oceanye/ESP32_C73-MF1750/8寸艾利尔042.jpg

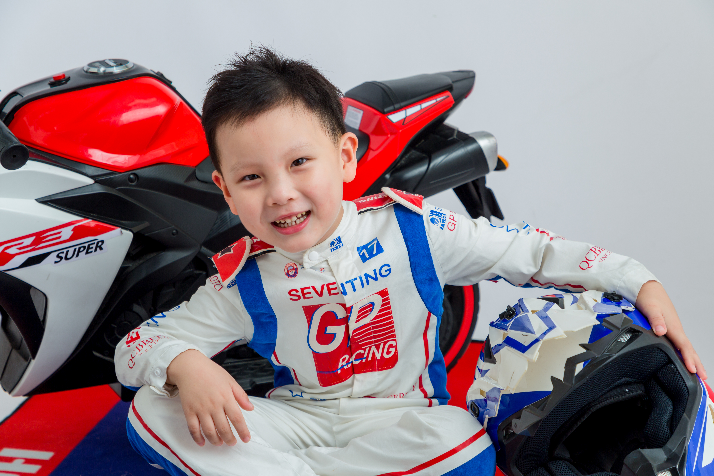
8寸艾利尔042.jpg
