oceanye/ESP32_C73-MF1750/参考资料/2路控制继电器Type-c/继电器引脚说明.jpg

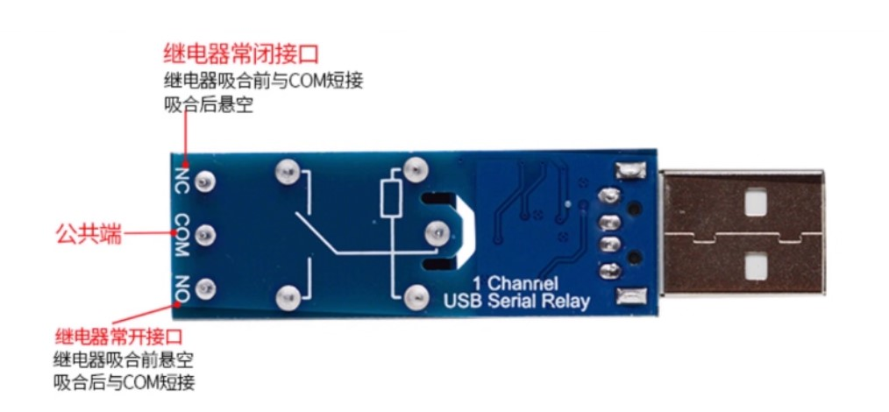
参考资料/2路控制继电器Type-c/继电器引脚说明.jpg
