oceanye/ESP32_C73-MF1750/hardware/mf1750_devkitc_b1_jlcpcb/support/PRE_EXPORT_SOURCE_AUDIT_NOTE.md

# Pre-export source audit

`PRE_EXPORT_SOURCE_VERIFICATION.json` is the exact historical B1 source verification record created before this Gerber/drill package existed.  Its legacy `No Gerber/drill manufacturing package is released` limit is superseded only by this export package's `MANIFEST.json`, `SHA256SUMS.txt`, and `README_ORDER.md`; all remaining source limits still apply.
