oceanye/ESP32_C73-MF1750/hardware/mf1750_devkitc_b2_jlcpcb/support/PRE_EXPORT_SOURCE_AUDIT_NOTE.md

# Pre-export source audit

`PRE_EXPORT_SOURCE_VERIFICATION.json` binds the exact verified B2 canonical source used by this export.  Its local evidence gate is PASS, while live portal/CAM/stock/placement review remains PENDING.  The functional-edge shortfall is removed; the listed J1/J3/J2/antenna/enclosure physical holds remain first-article checks.
