oceanye/ESP32_C73-MF1750/hardware/mf1750_production_v1/production/PCB下单与首板检查.md

# 嘉立创首板下单参数（MF-1750 Rev A1 / Q1 FIX）

- PCB：2 层，80 x 75 mm，FR-4，1.6 mm，1 oz，绿色阻焊，白色丝印。
- 最小线宽/间距：0.20/0.20 mm；常规过孔：0.60/0.30 mm。
- PCB 文件：只上传 `Gerber_mf1750_revA1_Q1FIX.zip`。
- SMT BOM：只上传 `BOM_mf1750_revA1_Q1FIX.csv`。
- SMT 坐标：只上传 `CPL_mf1750_revA1_Q1FIX.csv`。
- 不要复用嘉立创订单中修正前已经解析的旧文件记录。
- SMT：单面贴装；BOM/CPL 各含 46 个相同位号。J2 排针、TP 测试点和
  安装孔需要手工处理，不进入贴片坐标。
- 默认装配：R15、R12、R13 装；R16 不装。
- 禁止同时安装 R15 与 R16。
- J1 使用 C2856838 官方焊盘并旋转 180°，电缆从板顶边伸出；本板顶视
  pin 1 位于左侧 `PIN1 >` 丝印处。插屏前仍须以屏尾实物 pin 1 复核。

嘉立创预览必须逐项复核：

1. 板尺寸为 80 x 75 mm，2 层，全部 SMT 在 Top 面。
2. J1 pin 1 在左侧且排线向板顶边伸出。
3. D1-D4 阴极方向、Q1/Q2 pin 1 和封装方向与顶面渲染图一致。
4. R16 显示为不贴，R15/R12/R13 显示为贴装。
5. Q1 必须为 SI1308EDL：顶视 pin1=G（左下）、pin2=S（右下）、pin3=D（上）。
6. 二极管阴极色带：D1、D2 朝右；D3、D4 朝左。

J2 从 1 到 10 脚依次为：3V3、GND、SI0、SCL、CSB、DC、RST_N、
BUSY_N、可选 CS2、GND。前 8 脚兼容现有 DESPI-C73 主机接线；默认
R15 已把两路片选连接，R16 不贴。

最终布局复核：Q1-S→R1 约 2.51 mm，C0→L1 为 3.20 mm，L2→R3 为
4.55 mm；CP1 两支路合计 20.46 mm，CP2 合计 26.45 mm；两层 GND
铺铜由 6 个功率区局部过孔连接。KiCad 检查结果为 ERC 0、DRC 0、
未连接 0、原理图一致性错误 0。

首板必须限流上电并测量高压轨，不应把“DRC/ERC 通过”等同于已经完成
整屏实物电气验证。本板需要外部稳定 3.3 V；Q1 SI1308EDL 是已记录的
参考族器件选择，首板仍应测温并确认各高压轨后再插屏。
