oceanye/ESP32_C73-MF1750/docs/MF1750_DRIVER_API.md

# MF-1750 基础驱动与 API 参考

本文是 Rev A1/R16 基础驱动的当前统一接口说明。历史排查过程、制造证据和完整
实测记录分别保留在原有文档中；新代码应以本文、`src/epd_driver.h` 和实际路由为准。

## 1. 发布状态与适用范围

| 项目 | 当前值 |
|---|---|
| 当前源码与最近受监督验证 build | `MF1750_DRIVER_RC2G_R16_CCSET_MAPHASH_COLORGUARD_JOBTRACE_PSRFIX_WEBPHOTO_PHYSICAL_BUSYEDGE_2026-08-07`；精确 MAP job1 与 macro4 job2 的协议、nominal timing、BUSY edge、GPIO、电气和忠实度通过；不自动继承为所有帧/算法资格 |
| D0 正式实机验收 build | `MF1750_DRIVER_RC2C_R16_CCSET_MAPHASH_COLORGUARD_JOBTRACE_PSRFIX_2026-08-04` |
| C++ Driver API | `MF1750_R16_CASCADE_V3` |
| RC2F 历史 build / `firmware.bin` | `MF1750_DRIVER_RC2F_R16_CCSET_MAPHASH_COLORGUARD_JOBTRACE_PSRFIX_WEBPHOTO_PHYSICAL_2026-08-05`；811056 字节；SHA-256 `AE5261AA2E679B4AEA11C9C4C2CE5D12BD561EC72748828ECC5BA570A03A4A20`；已刷写，固定 MAP 基准与事故后恢复均通过 |
| RC2G `firmware.bin` | 815664 字节；SHA-256 `9DF89715385F98892549D24B57A6B139FB0844E9CEA52EF4FD2C961D6B0CD772`；2026-08-07 精确复核后刷入并完成两次受监督 exact-action 验证 |
| L535 研究变体 build（独立 TU/env，未继承生产验收） | `MF1750_L535_FRAME_V1_20260926`、`MF1750_L535_FRAME_V2_20261006`、`MF1750_L535_VSH_6000_20261010`、`MF1750_L535_VSH_6600_20261010`、`MF1750_L535_VSH_7200_20261010`、`MF1750_WF_A1_PLL50_20261011`、`MF1750_WF_B1_VSHLV2_6900_20261011`、`MF1750_WF_G6_WHITE_20261017`、`MF1750_WF_COMMENTED_FULL_20261018`、`MF1750_WF_BISECT_R1_20261018`、`MF1750_WF_BISECT_R2A_20261018`、`MF1750_WF_BISECT_R2B_20261018`、`MF1750_WF_BISECT_R2C_20261018`、`MF1750_WF_BISECT_R2D_20261018`、`MF1750_WF_BISECT_R2E_20261018`、`MF1750_WF_BISECT_R2F_20261018`、`MF1750_WF_BISECT_R2G_20261018`；各自批次 manifest 自封于 `.test-output/offline/`，上机资格以批次门为准 |
| L535 WF WMASK 研究变体（records 4–7 剩余 12 种非空组合，独立 TU/env，未继承生产验收） | `MF1750_WF_WMASK_01_20261018`、`MF1750_WF_WMASK_02_20261018`、`MF1750_WF_WMASK_05_20261018`、`MF1750_WF_WMASK_06_20261018`、`MF1750_WF_WMASK_07_20261018`、`MF1750_WF_WMASK_08_20261018`、`MF1750_WF_WMASK_09_20261018`、`MF1750_WF_WMASK_0A_20261018`、`MF1750_WF_WMASK_0B_20261018`、`MF1750_WF_WMASK_0C_20261018`、`MF1750_WF_WMASK_0D_20261018`、`MF1750_WF_WMASK_0E_20261018`；mask bit0/1/2/3 分别选择 record 4/5/6/7；离线包 `WF_WMASK_BUNDLES_20261018_V1`，上机资格以批次门为准 |
| L535 WF WMASK GrayExt 研究变体（低 4-bit base 加整个 records 0–3 组，独立 TU/env，未继承生产验收） | `MF1750_WF_WMASK_1E_20261019`、`MF1750_WF_WMASK_1C_20261019`、`MF1750_WF_WMASK_1D_20261019`；`1E/1C/1D` 是 family label，分别表示 base `0E/0C/0D` + records 0–3，不是新的 8-bit bitmask；离线包 `WF_WMASK_GRAYEXT_BUNDLES_20261019_V1`，上机资格以批次门为准 |
| L535 WF WMASK 0E single-record-add 研究变体（base `0E` 分别加 records 0/1/2/3 中恰好一个，独立 TU/env，未继承生产验收） | `MF1750_WF_WMASK_0E_R0_20261019`、`MF1750_WF_WMASK_0E_R1_20261019`、`MF1750_WF_WMASK_0E_R2_20261019`、`MF1750_WF_WMASK_0E_R3_20261019`；`0E_R*` 是显式 family label，不是新的 bitmask；离线包 `WF_WMASK_0E_R0TO3_BUNDLES_20261019_V1`，上机资格以批次门为准 |
| L535 WF WMASK 0E R0-anchored pair 研究变体（base `0E` 加 R0 与 records 1/2/3 中恰好一个，独立 TU/env，未继承生产验收） | `MF1750_WF_WMASK_0E_R0R1_20261019`、`MF1750_WF_WMASK_0E_R0R2_20261019`、`MF1750_WF_WMASK_0E_R0R3_20261019`；`0E_R0R*` 是显式 family label，不是新的 bitmask；离线包 `WF_WMASK_0E_PAIRS_BUNDLES_20261019_V1`，上机资格以批次门为准 |
| L535 partial-block 首批研究变体（docs/MF1750_PARTIAL_BLOCK_WAVEFORM_HANDOFF_20261020.md，独立 TU/env，未继承生产验收） | 路线 A `MF1750_PARTIAL_BLOCK_ATLAS_1E_20261020`：固定 1E 完整帧 tuple 驱动编译内置的白底七 code 图集帧；路线 B `MF1750_PARTIAL_BLOCK_PTLW_20261020`：clean-PTLW `0x83` 局部窗口 A=1E/B=0E/C=1C（9-byte 包含式、160×120、code-7 全量 preload 后 cropped DTM、PON/DRF/POF 且 PON 后不重复 PTLW）加 factory-OTP 白场锚点/恢复；两条路线的 R20/PWR/PLL/R21 与对应 wf_wmask 完整帧 profile 逐字节一致；不接受运行时坐标、未知命令、VCOM/高压修改或任意 LUT 字节；离线包 `MF1750_PARTIAL_BLOCK_20261020_V1`，上机资格以 P0–P3 批次门为准。P0 实测（批 `MF1750_PARTIAL_BLOCK_P0_20261020_V1`）：1E 下 code0 无可见驱动（对同区白基线 ΔE 1.21，t0→t30 稳定）——1E 混合表固有语义；bg_ref 单区橄榄色块经逐像素解码对拍排除映射/生成器 bug，分析包 `PARTIAL_BLOCK_P0_ANOMALY_ANALYSIS_20261020_V1`。修订 2 判别变体：`MF1750_PARTIAL_BLOCK_ATLAS_1E_20261020_V2`（同 8 格坐标，(544,384)=code7 探针、(792,384)=code6）与 `MF1750_PARTIAL_BLOCK_PTLW_20261020_V2`（patch code 0→4，其余逐字节不变）；离线包 `MF1750_PARTIAL_BLOCK_20261020_V2`。归一化+探针会话变体 `MF1750_PARTIAL_BLOCK_ATLAS_1E_20261020_V3`（排查②协议①+②：单会话内先 NORMALIZE——2×OTP 白 + 3×(code0/code1) active 表交替复位——再 1E 均匀 code7/code1 探针与 V2 图集，最后 OTP 白恢复；逐动作端点、无自动链；逐动作/逐步 BUSY 时间线）；离线包 `MF1750_PARTIAL_BLOCK_20261020_V3`。紧凑布局变体 `MF1750_PARTIAL_BLOCK_ATLAS_1E_20261020_V4`（8 格 110×110 收进当前可见窗 x[16,520] y[170,580] 且全部在 CS1 左半；row0=[0,1,2,3]、row1=[4,5,7,6] 保持 V2 约定；取消 V3 两个探针端点省 2 刷；NORMALIZE 8 步序与 V3 逐字节一致）；离线包 `MF1750_PARTIAL_BLOCK_20261020_V4`。BTST2[3] 阶梯扫掠变体 `MF1750_BTST2_SWEEP_V1_20261021`（排查④后续：V4 帧与 1E tuple 逐字节复用，四端点 `s17/s29/s39/s49` 仅刷新段 BTST2 第 4 字节按档重写（前三字节恒 `6F,1F,17`），0x49 档与 V4 atlas 刷新逐字节一致可直接对比；白恢复同 V4；离线包 `MF1750_BTST2_SWEEP_20261021_V1`）。修复版 `MF1750_BTST2_SWEEP_V2_20261021`（V1 缺陷：CS2 流写后未重选双控，PON/BTST2/DRF 只发 CS2 致级联主控永不完成刷新、DRF 60s 超时；V2 在刷新包装器首行恢复 `setActiveControllers(true, true)`，离线包 `MF1750_BTST2_SWEEP_20261021_V2`）。波形变体图集 `MF1750_WF_ATLAS_V1_20261021`（layer-1 扩稳定色：V4 帧逐字节复用，全帧路径首测 0E/1C，1E 为批内锚点，组曲 1D（GrayExt 亮端）与 0E_R0R1（R0 锚定 pair 暗簇）；刷新沿用 V4 已修复的双控选择语义；离线包 `MF1750_WF_ATLAS_20261021_V1`） |
| 硬件 | MF-1750 Rev A1，R15 拆除、R16=0 Ω |
| 控制器 | 双 SPD1657B，revision `0x04` |
| 面板 | 1024x600，双 512x600 控制器 |
| 默认刷新 SPI | 1,000,000 Hz |
| 实机范围 | RC2C 100 kHz/1 MHz MAP_ORIENT_V1 通过；RC2F 1 MHz 固定 MAP、恢复及低空间诊断通过；RC2F job5 macro4 时序异常；RC2G MAP job1 与同帧 macro4 job2 均 nominal 且忠实度通过，macro4 主观画质差，旧异常根因仍未定位 |

基础驱动 D0 已完成：初始化、双片选级联、`CCSET(0xE0)=0x01`、六色 4bpp
整帧、控制器映射、PON/DRF/POF BUSY 门禁、失败安全断电、任务状态和不可变
诊断报告均已落地并实机验证。

以下内容不属于已验收基础 API：高于 1 MHz 的 SPI 扫频、快速/局部波形、LUT、
局刷、灰阶、未校准普通图片真屏、设备端认证和远端取消。公开的
`epdDisplayFrameAtFrequency()` 只代表驱动可接受显式频率；除 100 kHz 与 1 MHz
外，不代表该频率已经获得硬件发布资格。

## 2. 规范帧合同

| 字段 | 合同 |
|---|---|
| 尺寸 | 精确 `1024x600` |
| 字节数 | 精确 `307200` |
| 排列 | top-left、逐行、无行填充 |
| 像素 | 4bpp；偶数 x 在高 nibble，奇数 x 在低 nibble |
| CS1 | `source_half=0, flip_x=0, flip_y=0, nibble_swap=0` |
| CS2 | `source_half=1, flip_x=0, flip_y=0, nibble_swap=0` |

物理颜色码：

| 码 | 颜色 |
|---:|---|
| `0x0` | 黑 |
| `0x1` | 白 |
| `0x2` | 黄 |
| `0x3` | 红 |
| `0x5` | 蓝 |
| `0x6` | 绿 |

这里的 4bpp 是应用帧和 SPI DTM 的 packed 容器，不代表面板存在 16 个独立颜色。
MF-1750 规格标称 `3-bit E6 full display capabilities`；当前生产合同仍只接受上述
六个经过实屏验证的物理码。`0x4/0x7` 的潜在 3-bit 状态和 `0x8..0xF` 的 bit3
alias/保留行为都尚未通过受控硬件实验。

`0x4` 和 `0x7..0xF` 非法。HTTP raw handler 会在复制完整帧和排队前逐 nibble
拒绝非法码；公开 C++ 显示入口还会在初始化、DTM、PON 之前再次完整验证。

## 3. C++ 驱动 API

头文件：`src/epd_driver.h`。

### 3.1 生命周期与显示

```cpp
void epdBegin();
int epdReadBusy();
bool epdDisplayFrame(const uint8_t *frame, size_t len);
bool epdDisplayFrameAtFrequency(const uint8_t *frame, size_t len, uint32_t spiHz);
bool epdClearWhite();
bool epdClearBlack();
```

- `epdBegin()`：配置 GPIO，并把所有面板侧输出保持为低；它不会自动刷新。
- `epdReadBusy()`：读取原始 BUSY_N 电平。面板供电且空闲时实测为 1；面板断电时
  可能为 0，不能脱离供电状态单独解释。
- `epdDisplayFrame()`：使用已验收的默认 1 MHz，要求非空指针和精确 307200
  字节；只有完整初始化、两半 DTM、PON、DRF、POF 和最终安全收尾都成功才返回
  `true`。
- `epdDisplayFrameAtFrequency()`：合同同上，并要求 `spiHz > 0`。高于 1 MHz
  属于实验调用，必须另做逐级硬件验收。
- `epdClearWhite()` / `epdClearBlack()`：维护诊断用整屏纯色刷新，不是应用渲染
  API；应用应始终生成规范完整帧。

每次显示操作结束后，SPI 被停止，SCK/MOSI/DC/RST/CS1/CS2 被拉低，避免 ESP32
仍由 USB 供电而面板 J2-1 断电时发生反向供电。

### 3.2 无副作用验证

```cpp
bool epdIsSupportedColorCode(uint8_t color);
bool epdValidateFrameColors(const uint8_t *frame, size_t len,
                            size_t *invalidPixel = nullptr,
                            uint8_t *invalidCode = nullptr);
```

两者都不访问面板。`epdValidateFrameColors()` 只检查传入的 `len` 字节颜色码；调用
显示 API 时仍必须独立满足 `len == 307200`。失败时可返回第一个非法像素的线性
索引与非法 nibble。

### 3.3 操作报告

```cpp
const EpdOperationReport &epdGetLastOperationReport();
```

报告是驱动内最后一次 result-bearing 操作的当前快照；下一次操作会覆盖它。直接
C++ 调用方若要长期保留证据，应立即复制结构体。HTTP wrapper 只在 job 完成后把
新报告复制成不可变 JSON，因此后续 REV 或诊断不能给旧 job 换贴报告。

重要字段：

| 字段组 | 含义 |
|---|---|
| `operationId` | 本次 MCU 启动内非零 u32 序号；重启后可重新从 1 开始 |
| `valid/running/sequenceOk` | 报告有效性、进行状态和最终序列结果 |
| `waitTimedOut/timeoutStage` | BUSY 等待超时及首次失败阶段 |
| `busyAssertionMissing/busyMissingStage` | 必须阶段在 250 ms 内没有 BUSY assertion |
| `pon/drf/pofBusySeen` | 三个正式高压阶段必须全部为 true |
| `postPsrBusySeen` | POF 后 PSR 的信息证据；允许为 false |
| `preCommandIdleFailure/preCommandBusyStage` | PON/DRF/POF 命令前无法在 3 秒内回到 idle 时 fail closed |
| `reset/pon/drf/pof/postPsrBusy` | RC2G 命令前电平、等待入口/出口、新 BUSY 边沿、等待和 assertion 延迟 |
| `safeFinishBusy*` | 面板侧输出拉低前、刚拉低后和 5 ms 后的 BUSY 原始样本 |
| `finalBusy/Rst/Cs1/Cs2` | 操作结束时 GPIO 快照；RST 低后的 BUSY 只作信息证据 |
| `inputFrameFnv1a` | 规范输入帧哈希 |
| `cs1DtmFnv1a/cs2DtmFnv1a` | 应用物理映射后的两路 DTM 哈希 |
| `*UploadMs/*WaitMs/totalMs` | 上传、各 BUSY 阶段和总耗时 |

POF 后 PSR 写入不会在当前实板再次拉低 BUSY，因此该阶段只要求最终 idle 和等待
证据；PON、DRF、POF 仍严格要求 BUSY assertion，缺失时 fail closed。RC2G 还要求
每条命令前先观察到 idle，再证明该命令之后出现新的 BUSY assertion；安全收尾必须
在拉低 RST/CS 前先观察到 idle。拉低 RST 后 BUSY 输入可能变为 0，不能单独据此
判定控制器仍忙。

## 4. ESP32 HTTP API

### 4.1 安全与调用规则

当前 ESP32 HTTP 服务没有认证和 TLS，只能运行在可信、隔离的调试网络。不要把它
直接暴露到互联网。正式应用优先使用主机 `HttpDeviceAdapter`，因为它限制路由、
绑定 artifact/mapping、执行一次性 arm，并核对 job 与 diagnostic；这些主机保护
并不等于设备端认证。

设备同一时间只允许一个 EPD job。`202` 只表示已排队，不表示显示成功。调用方必须：

1. GET version 并核对 build/API/尺寸/SPI/PSRAM/mapping；
2. POST 精确规范帧并保存返回的 `job_id` 与 FNV-1a；
3. 轮询相同 job 到 `completed` 或 `failed`；
4. GET immutable diagnostic，并核对 build/API/job/operation/hash/BUSY；
5. 最后由人确认画面、电源和温度。

网络超时后不得盲目重发 `/api/frame`。先查询 `/api/job` 和
`/api/diagnostic/report`；RC2F/RC2G V3 没有远端 cancel API。

### 4.2 稳定的应用协议路由

| Method | Route | 作用 | 面板 I/O |
|---|---|---|---|
| GET | `/api/version` | build、API、帧、SPI、mapping、PSRAM 预检 | 无 |
| POST | `/api/diagnostic/frame-ingress` | raw 帧长度/颜色/哈希/PSRAM 验证 | 无 |
| POST | `/api/frame` | 验证并排队一次正式 1 MHz 整帧刷新 | 有 |
| GET | `/api/job` | 当前/最后 job 状态 | 无 |
| GET | `/api/diagnostic/report` | 最后一个完成 job 的不可变 schema v2 报告 | 无 |

主机应用 adapter 的设备路由 allowlist 只包含以上五项。

另外两个可安全用于 D0 复核、但不在应用 adapter allowlist 内的接口：

| Method | Route | 作用 |
|---|---|---|
| GET | `/api/diagnostic/status` | 读取 `busy/rst/cs/cs2` 原始电平 |
| POST | `/api/diagnostic/map-orient-v1-generate` | 在 PSRAM 生成并校验规范 MAP；返回 `epd_action:"none"` |

N7 使用单独的 `esp32-s3-devkitc-1-n7-spi-sweep` 诊断构建。该构建不会注册
`/api/frame`、浏览器上传或任意频率接口；它以五个编译期固定动作替代默认服务的
可见写操作，并仅用于逐级、受监督的同一启动 SPI 扫频：

| Method | Route | 固定 SPI | 面板 I/O |
|---|---|---:|---|
| POST | `/api/diagnostic/map-orient-v1-sweep-1mhz` | 1 MHz | 一次 MAP_ORIENT_V1 整刷 |
| POST | `/api/diagnostic/map-orient-v1-sweep-2mhz` | 2 MHz | 一次 MAP_ORIENT_V1 整刷 |
| POST | `/api/diagnostic/map-orient-v1-sweep-4mhz` | 4 MHz | 一次 MAP_ORIENT_V1 整刷 |
| POST | `/api/diagnostic/map-orient-v1-sweep-8mhz` | 8 MHz | 一次 MAP_ORIENT_V1 整刷 |
| POST | `/api/diagnostic/map-orient-v1-sweep-10mhz` | 10 MHz | 一次 MAP_ORIENT_V1 整刷 |

这些端点拒绝 query/form 参数，不能由调用方指定其他频率。每个频点都要求独立的
workspace-global 单次 claim；前一频点的 schema v2 分析结果必须为 PASS 才能生成
下一动作身份。任何已 claim 动作的失败或证据不确定都按“不得重试、不得恢复”处理。

### 4.3 Version 预检

```http
GET /api/version
```

成功返回 `200 text/plain`：

```text
MF1750_DRIVER_RC2G_R16_CCSET_MAPHASH_COLORGUARD_JOBTRACE_PSRFIX_WEBPHOTO_PHYSICAL_BUSYEDGE_2026-08-07
Panel: 1024x600
Driver API: MF1750_R16_CASCADE_V3
Frame bytes: 307200
Refresh SPI Hz: 1000000
CS1 Mapping: 0,0,0,0
CS2 Mapping: 1,0,0,0
PSRAM bytes: <managed SPIRAM heap bytes>
Free PSRAM: <current free bytes>
```

`PSRAM bytes` 是 Arduino 受管 SPIRAM 堆，不是封装物理容量。N8R8 实机可能比
8 MiB 少报几 KiB；正式主机门禁只允许最多 64 KiB 的管理开销，并继续要求至少
一帧可用空间。

### 4.4 Raw 帧验证和正式刷新

两个入口都要求：

```http
Content-Type: application/octet-stream
Content-Length: 307200
```

body 是第 2 节规范的 307200 字节二进制帧，不能使用 multipart、base64 或 JSON。

非刷新验证：

```http
POST /api/diagnostic/frame-ingress
```

成功返回 `200`：

```json
{"ok":true,"bytes":307200,"fnv1a":2634290221,"free_psram":8060000,"epd_action":"none"}
```

正式刷新：

```http
POST /api/frame
```

成功排队返回 `202`：

```json
{"ok":true,"bytes":307200,"fnv1a":2634290221,"free_psram":8060000,"job_id":1}
```

### 4.5 设备内置照片工具网页

`GET /` 返回完全在浏览器内运行的照片工具，不会把原始图片上传到 ESP32。选择
一次原图后可反复切换以下六色处理方式：

- `none`：无抖动，形成平滑但细节较少的色块；
- `floyd-steinberg`：误差扩散，细节最多、颗粒也最密；
- `atkinson`：较轻的误差扩散，作为默认照片模式；
- `ordered-bayer-8x8`：固定 8x8 网点，输出可复现但可能出现规则纹理。

网页并排显示缩放/裁剪后的原图与“实际六色上传预览”。照片优化会用固定 gamma
提亮暗部并轻微降低饱和度；关闭后使用解码后的 sRGB 像素。所有模式都使用
`0/1/2/3/5/6` 六个物理码，同时由同一次颜色选择生成预览像素和 4bpp 帧，避免
原图预览与实际上传不一致。

原图构图画布支持鼠标和触摸指针拖动；鼠标滚轮或 `50%..400%` 滑杆缩放；左右
按钮按 90° 旋转；重置按钮恢复 `100%/0°/居中`。旋转后的 contain/cover 基准按
旋转外接框重新计算。拖动期间只更新原图构图，松开后量化；连续缩放使用短防抖，
停止操作后才生成六色预览。任何构图变化都会立即作废旧 `packed` 帧并禁用上传，
直到新预览及其 FNV-1a 生成完成。

右侧六色预览采用 `参考资料/MF-1750..1).pdf` 第 4 页 M009F-T A1 机械规格：

| 参数 | 预览合同 |
|---|---:|
| 像素矩阵 | 1024×600 |
| 有效显示区 | 163.84×97.20 mm |
| 像素间距 | 0.160×0.162 mm |
| 标称密度 | 158 PPI |

因此右侧 canvas 的 CSS 外观比例使用 `163.84:97.20`，而不是把 1024:600 当作
正方形像素比例。适应窗口模式显示完整有效区；1×/2×/4×检查模式按横向一个逻辑
像素对应 1/2/4 CSS px 展开，纵向间距再乘 `0.162/0.160`，可选像素边界叠加。
这模拟的是像素几何与六色码，不是显示器物理毫米校准，也不模拟微胶囊纹理、环境
光、视角或实际 Lab 颜色；后者仍需 calibrated palette 和实屏对比。

切换裁剪、照片优化或抖动模式只在浏览器中重新计算，绝不访问 `/api/frame`。
只有点击“上传并刷新”才提交当前 `packed` 帧；网页必须核对设备响应的 `bytes`
与 FNV-1a 后才轮询对应 job。该内置工具使用固定 reference RGB 色板，仍属于方便
调试的近似照片模式，不替代带 provenance 的 calibrated host pipeline。

### 4.6 Job 状态

```http
GET /api/job
```

```json
{
  "job_id": 1,
  "action": "uploaded_frame",
  "state": "completed",
  "result": true,
  "queued_at_ms": 24256,
  "started_at_ms": 24261,
  "finished_at_ms": 58449,
  "frame_fnv1a": 2634290221
}
```

`state` 为 `idle|queued|running|completed|failed`。未产生结果时 `result` 为
`null`。三个时间戳是本次启动内的 u32 `millis()`，可能回绕；job id 也是本次启动
内序号，MCU 重启后可以重新从 1 开始。

### 4.7 Immutable diagnostic

```http
GET /api/diagnostic/report
```

启动后尚无完成报告时返回：

```json
{"schema_version":2,"valid":false,"error":"no_completed_job_report"}
```

完成后响应把以下身份和驱动字段绑定在同一个不可变 JSON 中：

- `firmware_build_tag`、`driver_api_version`；
- `job_id/action/state/result`、`job_operation_id`、三个 job 时间戳；
- `operation_id`、`valid/running/sequence_ok`；
- `wait_timeout`、`busy_assertion_missing`、`timeout_stage`、
  `busy_missing_stage`；
- `pon/drf/pof/post_psr_busy_seen` 与对应 `*_ms`；
- RC2G 的 `pre_command_idle_failure/pre_command_busy_stage`、
  `busy_trace_schema_version=1` 与 nested `busy_trace`；
- `spi_hz`、完整帧/CS1/CS2 FNV-1a；
- 两路 mapping 和安全收尾的最后等待阶段。

正式成功至少要求：job completed/result=true，两个 operation id 相同且非零，
`sequence_ok=true`，PON/DRF/POF BUSY 为 true，无 timeout/missing stage，SPI/mapping
和三个哈希与提交内容一致，`last_wait_stage="post-display PSR"`。RC2G 还必须证明
PON/DRF/POF 都是 idle-before-command 后的新 BUSY 边沿，safe-finish 开始时 BUSY
为 idle，最终 RST/CS1/CS2 为低；最终 BUSY 0 或 1 都保留为信息样本。

### 4.8 HTTP 错误

| 状态 | 典型 error | 含义 |
|---:|---|---|
| 400 | `frame_size_mismatch` | Content-Length/raw 总长度不等于 307200 |
| 400 | `unsupported_color_code` | 含非法 nibble；同时返回 `invalid_pixel/code` |
| 400 | `frame_too_large` / `upload_aborted` | raw 上传越界或中止 |
| 409 | `epd_action_pending` | 已有 queued/running job |
| 415 | `content_type_must_be_application_octet_stream` | 不是 raw octet-stream |
| 500 | `map_generation_failed` | 规范 MAP 生成/自校验失败 |
| 404 | `Not found` | 未注册路由 |

PSRAM 分配失败通过 400 `frame_buffer_allocation_failed` 返回。错误响应不会把帧排队。

## 5. 维护诊断路由

以下路由继续存在于 RC2F/RC2G 固件，但不属于稳定应用 API，也不在
`HttpDeviceAdapter` allowlist 中。它们可能切换 GPIO、复位控制器、启动高压或
显示历史非规范尺寸；只有在面板供电条件、冷启动间隔和人工授权明确时才可调用。

无高压/引脚维护：

- `POST /api/diagnostic/revisions`
- `POST /api/diagnostic/reset`
- `POST /api/diagnostic/cs-high`
- `POST /api/diagnostic/cs-low`
- `POST /api/diagnostic/cs2-low`
- `POST /api/diagnostic/release`

历史/固定图刷新：

- `POST /api/test`
- `POST /api/black`
- `POST /api/white`
- `POST /api/bars`
- `POST /api/halves-wb`
- `POST /api/bars-800x480`
- `POST /api/white-800x480`
- `POST /api/black-800x480`
- `POST /api/bars-512x600`
- `POST /api/white-512x600`
- `POST /api/black-512x600`
- `POST /api/bars-swap`
- `POST /api/bars-h`
- `POST /api/bars-8bpp`
- `POST /api/bars-cs2-test`

100 kHz 定向诊断：

- `POST /api/diagnostic/white-512-slow`
- `POST /api/diagnostic/black-512-slow`
- `POST /api/diagnostic/white-800-slow`
- `POST /api/diagnostic/white-1024-short-slow`
- `POST /api/diagnostic/white-512-long-slow`
- `POST /api/diagnostic/white-1024-full-slow`
- `POST /api/diagnostic/cs1-bars-isolated`
- `POST /api/diagnostic/cascade-white-black-slow`
- `POST /api/diagnostic/cascade-black-white-slow`
- `POST /api/diagnostic/cascade-dual-bars-slow`
- `POST /api/diagnostic/cascade-global-bars-slow`
- `POST /api/diagnostic/cascade-global-horizontal-bars-slow`
- `POST /api/diagnostic/map-orient-v1-slow`
- `POST /api/diagnostic/dual-white-black-slow`
- `POST /api/diagnostic/dual-black-white-slow`
- `POST /api/diagnostic/dual-white-white-slow`

上述刷新路由通常返回 `202` 与嵌套 `job`；必须继续查询 job/report，不能把排队响应
当作显示成功。部分旧探针没有完整 result/report 语义，只保留用于历史溯源。

## 6. 推荐主机入口

只生成、验证规范 MAP：

```powershell
python tools\mf1750_frame_tool.py --pattern map-orient-v1
```

连接设备但不刷新：

```powershell
python tools\mf1750_frame_tool.py --pattern map-orient-v1 `
  --url http://DEVICE-IP
```

正式刷新需要冷启动确认和两项显式 mapping：

```powershell
python tools\mf1750_frame_tool.py --pattern map-orient-v1 `
  --url http://DEVICE-IP --refresh --confirm-cold-start `
  --controller-mapping 0,0,0,0 `
  --controller-mapping 1,0,0,0
```

工具输出中的 `hardware_tested:false` 表示机器不能替代人的实屏、电源和温度确认，
不表示本文记录的 D0 硬件验收不存在。

## 7. Loopback 应用 API

启动默认离线 UI：

```powershell
python -m app.server
```

显式启用设备 adapter：

```powershell
python -m app.server --enable-device --device-url http://DEVICE-IP
```

服务只允许 numeric loopback 地址。每次启动生成高熵 token，打印在 URL fragment；
浏览器随后把它移入同源 `sessionStorage`。所有 `/application/*` 请求必须带
`X-Application-Token`，POST 还必须有匹配的 `Origin`，并拒绝 query string。

读取路由：

| Method | Route | 作用 |
|---|---|---|
| GET | `/application/config` | 面板、palette、dither、fit、adapter 配置 |
| GET | `/application/status` | artifact、arm、job、锁和恢复状态 |
| GET | `/application/report` | 当前应用 artifact/report |

变更路由：

| Method | Route | 请求 |
|---|---|---|
| POST | `/application/convert` | 精确 2457600 字节 normalized RGBA octet-stream |
| POST | `/application/artifact/invalidate` | JSON object |
| POST | `/application/device/allow` | `{"allow":true}` |
| POST | `/application/device/preflight` | mapping JSON |
| POST | `/application/device/ingress` | `{}` |
| POST | `/application/device/arm` | `{"confirmation":"ARM MF1750 REFRESH"}` |
| POST | `/application/device/enqueue` | mapping JSON |
| POST | `/application/device/job` | `{}` |
| POST | `/application/device/report` | `{}` |
| POST | `/application/device/recover` | `{}` |
| POST | `/application/device/local-abort` | `{}` |
| POST | `/application/device/cancel` | `{}`；RC2F/RC2G V3 明确返回 unsupported |

mapping JSON：

```json
{"cs1":[0,0,0,0],"cs2":[1,0,0,0]}
```

`/application/convert` 的必需 Content-Type 是 `application/octet-stream`；浏览器还会
发送 `X-Input-SHA256`、`X-Input-Media-Type`、`X-Fit-Policy`、`X-Dither-Mode`、
`X-Text-Mode` 和 `X-White-Protection`。默认 reference palette 未校准，只能生成
明确标记的离线预览；只有带完整 provenance 的 calibrated palette 才可能获得正式
上传授权。

普通变更成功响应为 `{"ok":true,"result":...}`；错误统一包含
`ok=false/error/detail/hardware_tested=false`。应用层的 `hardware_tested` 永远为
false，最终物理验收必须在应用报告之外人工记录。

`/application/device/local-abort` 不是远端 cancel。若已经尝试提交
`POST /api/frame`，或 matching completed job 尚未取得 matching diagnostic 与
safe-finish 证据，响应中的 `new_submission_locked=true`，本进程继续拒绝 artifact
替换、preflight、arm 和 enqueue。`remote_job_may_continue` 只描述远端活性是否仍
未知；即使它为 false，丢失安全收尾证据时提交锁仍可保持。只有从未尝试提交 frame
的本地 arm 才能通过 local-abort 安全解锁。

## 8. 已知边界与版本策略

- RC2C/V3 是底层驱动已实测的不可变固件身份；RC2D/V3 增加设备内置网页照片
  工具，RC2E/V3 增加构图变换，RC2F/V3 增加物理像素几何预览，RC2G/V3 增加
  BUSY 命令边沿和安全收尾 GPIO 证据。每个版本必须以独立 build、构建指纹和刷写
  复验记录管理，不能继承 RC2C/RC2F 的固件哈希或硬件资格。RC2G 离线构建记录见
  [`RC2G_BUSYEDGE_OFFLINE_BUILD_2026-08-07.json`](RC2G_BUSYEDGE_OFFLINE_BUILD_2026-08-07.json)。
- 任何改变初始化、CCSET、mapping、颜色码、PON/DRF/POF/PSR、BUSY 门禁或
  面板 GPIO 安全状态的变更，都必须提升 build 身份并重新实机验收；若公开 C++
  调用合同出现不兼容变更，还必须提升 Driver API。
- 当前设备 API 无认证、无 TLS、无 cancel、无持久 job 历史。
- local-abort quarantine 当前只在本地进程内保存；服务异常重启后必须先人工确认
  设备 idle 与安全收尾，不能把重启当作自动解锁证据。完整闭环需要持久 latch，或
  设备侧 boot/request nonce 与可持久查询的 job identity。
- H0 的 RC2C 源码/证据 archive 与 hash 已生成；精确验收二进制和持久异机副本仍
  未补齐，硬件验收 tag 也未创建。创建 tag 前仍需用户明确指定名称和目标。
- 网络照片源、随机选择与定时刷新按
  [`TODO_NETWORK_RANDOM_PHOTO_PIPELINE.md`](TODO_NETWORK_RANDOM_PHOTO_PIPELINE.md)
  分阶段执行；当前尚未实现，也不得直接在 ESP32 上猜测式扩展。
- 当前没有公开或 legacy 未知颜色码测试 API。未来实验不能通过放宽 `/api/frame`
  或公共 C++ 颜色校验实现；只能使用默认关闭、固定图案、哈希锁定、一次性 arm
  的隔离诊断 build/action，并提升版本、重新完成安全和实机验收。完整边界见
  [`EPD_EXTENDED_COLOR_FEASIBILITY_2026-08-05.md`](EPD_EXTENDED_COLOR_FEASIBILITY_2026-08-05.md)
  与 [`TODO_EPD_EXTENDED_COLOR_TESTS_2026-08-05.md`](TODO_EPD_EXTENDED_COLOR_TESTS_2026-08-05.md)。
- 完整实测数据见 `docs/REV_A1_R16_CASCADE_FULLFRAME_TEST_2026-08-04.md`。
