oceanye/ESP32_C73-MF1750/docs/MF-17506-M009F-T_外部参数建议审查_2026-08-21.md

# MF-17506-M009F-T 外部参数建议审查

状态：`OFFLINE EVIDENCE REVIEW / NO DEVICE ACTION / NOT LIVE-AUTHORIZED`  
审查日期：`2026-08-21`  
适用范围：阶段二单像素颜色状态发现，以及后续可能的局刷、SPI 速率和波形研究

## 1. 结论

外部建议中，3.3 V 逻辑、电路现用的 SPI mode 0、MSB first，以及 BS0/BS1 拉低可纳入当前
精确实现；`BUSY active HIGH` 必须纠正为 **BUSY 忙时 LOW、空闲时 HIGH**。当前阶段只保留
已验证的 1 MHz SPI，不把 2–10 MHz 建议写入 D1-512 执行合同。

当前没有足以证明 MF-17506 + 双 SPD1657B 支持真局部刷新的精确命令资料，也没有可信的
runtime LUT 寄存器表。因此不猜测 `0x86`、`0x32` 或其他控制器命令，不把局部刷新写入当前
驱动。刷新中切断主电源会打断原厂波形和直流平衡；本项目当前明确不实现该路径。

## 2. 证据边界

[COMPUTEX 官方 SPD1657 产品页](https://www.computextaipei.com.tw/zh-tw/product/CBA4659B8C39B7F72BDDBEB61C4033B7A51D2AFD55BCA758/info.html)
只支持以下有限结论：SPD1657 被描述为 `800 source × 600 gate`、用于 Spectra 6。该页面不证明：

- 本板所用 SPD1657B rev `0x04` 的完整寄存器、命令或 LUT 格式；
- MF-17506 双控制器 1024×600 级联板的精确初始化和窗口合同；
- `E2802` 是本项目可采用的、与 SPD1657B 完全等价的器件身份；
- 当前面板支持真局刷、刷新中切电或任意第三方控制器命令。

本项目的精确板级实现、已封存 SPI 帧和实测 BUSY 极性优先于相邻型号样例和平台级宣传。

## 3. 逐项裁决

| 外部建议 | 裁决 | 本项目落地 |
|---|---|---|
| logic voltage = 3.3 V | 接受 | 与当前逻辑电压合同一致；不因此推断面板内部高压或其他电源域。 |
| SPI mode 0 | 接受 | 当前精确驱动使用 mode 0。 |
| SPI bit order = MSB first | 接受 | 当前精确驱动使用 MSB first。 |
| BS1 = LOW、BS0 = LOW | 接受 | 当前板通过 R12/R13 固定为低，按现有四线 SPI 接口使用。 |
| BUSY active HIGH | **纠正** | 实测与当前驱动合同均为忙时 LOW、空闲时 HIGH；不得反转等待条件。 |
| 1 MHz 起步 | 接受 | D1-512 固定 1 MHz；不得在同一发现批次改变 SPI 速率。 |
| 2–4 MHz normal、8–10 MHz upper | 推迟 | 尚未在本精确硬件合同下资格化；如需要，另立 N7 速率完整性测试，不与颜色发现混跑。 |
| `Ci→Cj`、`Ci→Cj→Ck` 历史搜索 | 接受概念 | D1-512 直接覆盖全部 `8³=512` 条三步历史，每个 ROI 内像素使用统一 code，不做空间混色。 |
| 16 分区提高吞吐 | 被更密集方案取代 | 当前实际布局为每半屏 11×24，共 528 ROI；其中 512 个候选、16 个参考。仍是完整全屏刷新。 |
| 真局部刷新 | 推迟且硬封锁 | exact support=`UNKNOWN`，current driver=`FALSE`；取得 SPD1657B 精确 command/support package 前不上机探测。 |
| 使用 `0x86` 作为局刷入口 | 拒绝 | 相邻样例只把它标为未来 dither-image helper；没有证据证明其为本板局刷命令。 |
| 写入 RAM LUT / `0x32` / 套用 SSD、UC 系列命令 | 拒绝 | 没有精确寄存器和 LUT 格式；禁止猜命令、穷举命令或套用异构控制器表。 |
| 刷新中按比例切断驱动板电源 | 拒绝，不实现 | 会中断原厂 OTP 波形并破坏直流平衡；当前阶段不得生成可执行 runner、定时切电路径或现场步骤。 |
| 切电前 MCU 全部高阻 | 拒绝作为当前安全动作 | 与当前故障路径已验证的 safe-finish 拉低策略冲突，且没有本板直接证据。 |
| 每候选做两次自动恢复 | 拒绝自动化 | 无精确依据且会增加可见刷新；本项目继续保持一动作一裁决、无 retry/recovery/autochain。 |

## 4. D1-512 当前安全实现边界

D1-512 仅复用已经验证的 factory OTP 完整刷新路径：

1. standard white baseline；
2. 512-recipe source frame；
3. 512-recipe mid frame；
4. 512-recipe target frame；
5. standard white recovery。

实际网格为每半屏 `11列 × 24行`，两半合计 `22×24=528` 个 ROI。每格 `40×22 px`，横向
白缝 4 px、纵向白缝 2 px，每半屏起点 `x0=16`，全屏 `y0=13`。512 格承载所有
`source0..7 × mid0..7 × target0..7` 候选；每个控制器另有 code 0–7 共 8 个参考格，左右合计
16 个参考格。所有候选格内部像素同态，不使用抖动或观看距离混色。

这五个动作仍是全屏 DTM 上传和全局 `PON→DRF→POF`，不是局部刷新。任何离线代码完成、测试
通过或固件构建都不构成上机授权；现场仍须在操作者返回后重新经过 J2-OFF、应用固件刷写和
只读身份检查边界。

## 5. 后续重新打开被推迟路线所需证据

- 局刷：SPD1657B 精确 revision 的 command/support package，至少包含窗口、old-frame RAM、
  partial waveform、边界和 cleanup 合同；
- runtime LUT：精确寄存器地址、长度、格式、VCOM/高压约束及安全恢复说明；
- 高速 SPI：独立的 MAP/双 DTM/帧完整性测试与逻辑分析仪证据；
- 任意波形中断：单独牺牲屏、电子负载开关、直流平衡评估和独立风险批准。

在这些证据到位前，上述路线保持 `NOT IMPLEMENTED / NOT LIVE-AUTHORIZED`。
