oceanye/ESP32_C73-MF1750/docs/MF-17506-M009F-T_阶段二与阶段三测试计划.md

# MF-17506-M009F-T 阶段二与阶段三完整测试计划

版本：v1.0  
日期：2026-08-20  
对象：MF-17506-M009F-T，7.50 英寸，1024 × 600，3-bit E6 电泳屏  
目标：先利用原厂 OTP 波形寻找更多可重复颜色，再在确认 SPD1657B 支持并开放 RAM LUT 写入后，开展受约束的自定义波形实验。

> 本计划以牺牲屏为对象，但仍以“可恢复、可追踪、一次只改变一个变量”为原则。它不能消除永久残影、色料迁移失衡、FPC/驱动 IC 损坏或高压电源故障的风险。

> 执行状态（2026-08-20）：USB/COM 控制继电器已采购但尚未完成实物验收；逻辑分析仪尚未到位。
> 本文保留总体研究设计，实际设备门、证据抵扣、继电器验收、批次数量、人工交接和阶段三硬停止
> 以配套的 [`MF-17506-M009F-T_阶段二与阶段三落地执行流程.md`](MF-17506-M009F-T_阶段二与阶段三落地执行流程.md)
> 为准。该执行补充当前仅为离线设计，不授权 USB/COM、上电、刷写、RESET、继电器动作、刷新或 LUT 写入。

> **2026-08-21 操作者裁决：** 阶段二按“未发现肉眼可辨的新单像素颜色”关闭；色卡、延迟保持
> 和重复资格化不再补做，未执行项记作 operator-closed 而不是 PASS。逻辑分析仪降为阶段三
> 辅助设备；阶段三改沿已存在的厂家 profile 经验 H3 路线继续，严格 ABI 仍标记未证明。具体
> 边界见 [`MF-17506-M009F-T_阶段二关闭与阶段三推进裁决_2026-08-21.md`](MF-17506-M009F-T_阶段二关闭与阶段三推进裁决_2026-08-21.md)。

> **2026-08-30 discovery 补充：** 2026-08-21 的阶段二关闭裁决不变。本日仅在独立
> fresh identity 下执行 RAW-P16 crossover T2 discovery successor V2，用于人工宽色候选发现；
> 它不是阶段二重新开放、不是原 T2、不是 RAM-LUT 阶段三，也不产生正式合格颜色。V2 后已由
> 精确绑定的 W3 factory-OTP white 完成白收容并将 J2 置 OFF。

## 1. 已确认事实、假设和边界

### 1.1 已由面板规格确认

- 面板型号：MF-17506-M009F-T。
- 分辨率：1024 × 600；像素间距约 0.160 × 0.162 mm。
- 50-pin FPC；机械图给出 50 个触点总跨距约 24.50 mm、单触点宽约 0.30 mm，据此可判定为 0.5 mm 间距。采购时仍须核对触点方向、上下接和锁扣结构。
- 两颗 SPD1657/1657B 类驱动 IC；引脚中存在主 `CSB` 和 `SL_CSB`。
- IC 集成显示 RAM、SRAM、LUT、时序控制和高压电源控制；规格写明原厂波形存放在片上 OTP。
- 默认可用 4-wire SPI：`CSB`、`SCL`、`SI0`、`DC`，另有 `RST_N` 和 `BUSY_N`。
- 规格中的 `BUSY_N` 描述与常见命名相反：文档明确写“High 表示忙”。软件必须以真机测量为准，不可只根据 `_N` 后缀判断极性。
- VDD 典型 3.0 V，工作范围 2.4–3.6 V；工作温度 0–50 °C。该数值是面板逻辑电源条件，不等于现有驱动板的外部输入电压。
- 规格不提供 SPD1657B 命令表，明确要求另查 IC 数据手册。

### 1.2 当前实验基础

- 已掌握原有 6 种常规颜色编码，并发现第 7 种蓝色（Blue-2）。
- 阶段二不改 LUT，只调用原厂 OTP 波形，通过不同的颜色历史、目标码、重复次数和等待时间寻找中间稳定状态。
- 阶段三才尝试 RAM LUT；只有在确认命令、数据长度、相位编码和装载流程后才允许进入。
- 逻辑分析仪：DSLogic Plus 100 MHz、16 通道已经足够。阶段二可选，阶段三强烈建议使用；没有必要仅为本项目升级 U2Pro16。

### 1.3 需要纠正的并行测试理解

- 16 个画面分区可以在一次刷新中测试 16 个不同的“像素状态序列”。
- LUT 通常是某颗驱动 IC 的全局资源，不是每个画面分区各有一套 LUT。
- 因而阶段三在单颗 IC 上通常一次只能测试一套候选 LUT；若两颗 IC 确实可独立装载并独立刷新，最多可同时比较两套 LUT，左右各一套。
- 是否能左右独立，必须通过 `CSB/SL_CSB`、BUSY 行为和独立刷新实测确认；仅凭有两颗 IC 不能直接认定。

## 2. 总体流程和放行门槛

| 门槛 | 必须满足的条件 | 不满足时处理 |
|---|---|---|
| G0 硬件安全 | 驱动板原厂模式正常；供电、限流、FPC 方向、公共地正确 | 停止，不接牺牲屏 |
| G1 基线可重复 | 7 色条连续刷新 3 次，无异常 BUSY、过流、花屏 | 排查硬件/时序，不开始筛色 |
| G2 阶段二完成 | 42 个有向两步转换完成；候选颜色有照片和日志 | 补齐数据后再筛选 |
| G3 RAM LUT 证据 | 获得 SPD1657B 命令依据或有效总线捕获；明确 LUT 长度和格式 | 不写 LUT，只继续阶段二 |
| G4 等价 LUT | RAM 装载“未修改基线 LUT”后，显示、BUSY 时间和电流与原厂基线一致 | 立即停止自定义 LUT |
| G5 受约束搜索 | 候选参数满足相位、时长、能量和恢复约束 | 拒绝执行该候选 |

## 3. 设备清单

### 3.1 必需设备

| 项目 | 数量 | 要求/建议 | 用途 |
|---|---:|---|---|
| MF-17506-M009F-T 牺牲屏 | 1–2 | 至少一块实验屏；最好另留一块原始对照屏 | 波形实验与对照 |
| 已验证驱动板 | 1 | 具备正确升压、VCOM、双 IC 连接和 FPC 座 | 驱动面板；不要直接自制切换 VGH/VGL 等高压轨 |
| MCU 板 | 1 | ESP32-S3 或现有主控；USB 串口稳定 | 单一测试固件、执行刷新和回报状态 |
| 可调稳压电源 | 1 | 电压覆盖驱动板额定输入；具有可设电流限制和输出开关 | 供电、异常限流、观察平均电流 |
| 程序控制断电装置 | 1 | 见 3.3；只切驱动板输入正极 | 自动冷启动、刷写保护、故障恢复 |
| 数字万用表 | 1 | 可测驱动板输入电压、静态电流、断电残压 | 接线和掉电验证 |
| DSLogic Plus | 1 | 100 MHz、16 通道 | 阶段三协议确认；阶段二故障诊断 |
| 50-pin 0.5 mm FPC 转接板/延长板 | 1–2 | 必须核对同面/反面触点和座型 | 安全引出数字信号；不要靠飞线夹 FPC |
| 固定相机或手机 | 1 | 锁定曝光、白平衡、焦距；最好支持 RAW | 颜色比较和自动评分 |
| 固定照明箱 | 1 | 高显指、遮挡环境光、固定灯距和角度 | 保证不同批次颜色可比较 |
| 灰卡/色卡 | 1 | 与屏幕处于同一画面和光照平面 | 白平衡和颜色校准 |
| 温度计 | 1 | 记录室温；最好增加贴片热电偶 | 波形与温度高度相关，保证可重复性 |
| ESD 工具 | 1 套 | 防静电腕带、台垫、接地 | 保护裸屏和驱动板 |

### 3.2 建议增加

| 项目 | 建议型号/能力 | 价值 |
|---|---|---|
| 输入电流记录 | INA226 模块，或程控电源自带采样 | 记录每次刷新平均/峰值趋势；INA226 不替代示波器观察快速尖峰 |
| 总线隔离 | TI SN74LVC125A 等带 `Ioff`/部分掉电保护的三态缓冲器 | 防止驱动板断电时，SPI 通过保护二极管反向供电 |
| 示波器 | 50–100 MHz，带合适探头 | 查看电源跌落、上电斜率和 BUSY 异常；不建议新手直接测面板高压轨 |
| 反射式色度仪/分光仪 | 可测反射材料的设备 | 比相机更准确地计算色差；初期可暂不买 |
| 固定压屏框 | 非金属、均匀支撑、不压有效区 | 保持相机位置和面板平整度一致 |

### 3.3 程序控制电源的推荐选择

#### 方案 A：现有电源 + USB 继电器（阶段二最推荐）

- 推荐：Numato 1 Channel USB Powered Relay（SPDT，新版 10 A 型号），电脑上表现为串口，可由 Python 控制。
- 接线：`电源正极 → COM`，`NO → 驱动板电源正极`；电源负极、驱动板地、MCU 地和逻辑分析仪地保持公共参考。
- 使用 NO 触点可以让继电器未吸合时默认断电。
- 机械继电器动作是毫秒级，足以完成以秒为单位的冷启动；若要做数万次快速循环，改用负载开关。
- 不推荐切换地线，因为 MCU 和逻辑分析仪仍需共同参考地。

#### 方案 B：MCU 控制负载开关（长期自动化最推荐）

- 推荐：TI TPS22975/TPS22975EVM，适用于驱动板输入不高于 5.7 V 的情况。
- 特性包括 6 A 连续能力、可调上升时间和可选快速输出放电。
- `ON` 必须加硬件下拉，使 MCU 复位或刷写时默认关闭。
- 与三态 SPI 缓冲器配合：驱动板掉电前先关总线，避免反向供电。
- 如果驱动板输入高于 5.7 V，改选覆盖该电压的高边负载开关/eFuse，不要勉强使用 TPS22975。

#### 方案 C：SCPI 程控台式电源（需要电流记录时选择）

- RIGOL DP932U/DP900 系列：支持标准 SCPI，适合由 PC 控制输出并记录数据。
- OWON ODP3033：支持 USB Device、RS232、LAN 和 SCPI，三通道 0–30 V/3 A（前两路）。
- 对当前项目而言，台式程控电源不是进入阶段二的必要条件；已有合格电源时，加 USB 继电器即可。

### 3.4 不建议购买/使用

- 无文档、上电默认吸合、USB 枚举时会抖动的继电器板。
- 仅低端切地的 MOSFET 模块。
- 不能设限流、输出关闭后仍有明显漏电的廉价电源模块。
- 将逻辑分析仪探头接到 `VGH/VGL/VSH/VSL/VCOM` 等高压轨。
- 在不清楚 FPC 触点方向时插拔或反插转接板。

## 4. 测试台接线与电源时序

### 4.1 推荐连接

```text
PC
├─ USB → MCU（SPI、复位、BUSY、测试指令）
├─ USB → DSLogic Plus（阶段三捕获）
└─ USB → USB 继电器/SCPI 电源（控制驱动板输入）

稳压电源 + → 继电器 COM → 继电器 NO → 驱动板额定输入 +
稳压电源 - ─────────────────────────→ 驱动板 GND
MCU GND、驱动板 GND、逻辑分析仪 GND 共地
```

> 只切驱动板的主输入正极。不要单独切面板内部的 VGH、VGL、VSH、VSL、VCOM 等轨。

### 4.2 断电序列

1. 停止发送新命令。
2. 等待 `BUSY_N` 回到实测空闲电平。
3. 发送驱动 IC 的正常 Power-Off/Deep-Sleep 命令（以工作固件为准）。
4. 等待固件规定的释放时间。
5. 将 MCU 的 `SCL/SI0/DC/CSB/SL_CSB/RST_N` 设为高阻或安全低电平；有三态缓冲器时先拉低 `BUS_EN`。
6. 关闭继电器/负载开关。
7. 用万用表确认驱动板输入已下降到接近 0 V；首次标定残压衰减时间。

### 4.3 上电序列

1. MCU 先进入安全 GPIO 状态，`CSB/SL_CSB` 为未选中。
2. 打开继电器/负载开关。
3. 等驱动板逻辑电源稳定。
4. 继电器 ON 后只允许只读查询；raw BUSY 准入电平可能延迟建立，必须明确读到当前固件合同
   规定的 `BUSY=1` 才能 claim/ARM/EXECUTE。relay ON receipt、固定 sleep 或控制器状态推断均不能
   替代该门；未建立时保护性 OFF。
5. 有三态缓冲器时，再使能 `BUS_EN`。
6. 执行硬件复位和完整初始化。
7. 验证本 campaign 冻结的 raw BUSY 准入电平、控制器状态和温度读取（如果命令已知）；
   不得仅凭 `_N` 命名推断极性。
8. 显示基准白场或 7 色条，确认系统健康。

### 4.4 刷写固件

- 不需要为每个候选测试重新刷写固件。使用一个参数化测试固件，PC 通过 USB/串口发送测试计划。
- 真正刷写 MCU 固件时，驱动板应保持断电，且 SPI 总线不得反向供电。
- 最稳妥的架构是：电脑控制独立 USB 继电器；即使 MCU 在复位，驱动板仍保持断电。

## 5. 软件和数据结构

### 5.1 MCU 固件最小功能

- `power_state`：报告驱动板是否供电。
- `hard_reset`：执行固定复位时序。
- `init_factory`：原厂 OTP 模式初始化。
- `draw_regions`：向 16 个区域写入各自颜色码。
- `refresh`：触发刷新并测量 BUSY 时长。
- `clear_factory`：执行已验证的原厂清屏/恢复序列。
- `load_lut`：仅在阶段三 G3 放行后编译启用。
- `read_status/read_lut`：若 SPD1657B 协议支持则实现。
- 看门狗、BUSY 超时、串口心跳和错误码。

### 5.2 PC 控制程序

- 读取 CSV/JSON 测试计划，不修改固件即可更换候选。
- 为每次运行生成唯一 `run_id`。
- 依次控制供电、初始化、写图、刷新、拍照和恢复。
- 保存串口日志、逻辑分析文件名、照片名和 LUT 哈希。
- 出现异常时停止队列，不自动无限重试。

### 5.3 每次测试必须记录

```csv
run_id,timestamp,panel_id,fw_hash,mode,lut_hash,temperature_c,
region_id,controller_side,source_code,mid_code,target_code,
dwell_ms,repeat_count,busy_ms,input_v,current_avg,current_peak,
photo_file,logic_file,result_label,recovery_ok,notes
```

阶段二 `lut_hash` 固定写 `factory_otp`；阶段三必须保存候选 LUT 原始文件和 SHA-256。

## 6. 16 分区画面设计

### 6.1 布局

- 左半屏 8 格：L01–L08。
- 右半屏 8 格：R01–R08。
- 每格使用相同面积，外围留出白色安全边框。
- 每格内加入机器可读编号；编号区域使用固定黑白，不参与颜色评分。
- 中央分界线清晰标注，用于判断两颗 IC 的边界差异。
- 每批将候选在左右半屏互换一次，排除左右 IC、光照和相机镜头偏差。

### 6.2 分区能够并行的内容

| 测试内容 | 16 格能否不同 | 说明 |
|---|---|---|
| 初始颜色码 | 可以 | 每格写不同源状态 |
| 中间颜色码 | 可以 | 每次全屏刷新时各格写不同目标码 |
| 最终颜色码 | 可以 | 可并行比较状态历史 |
| 等待时间 | 一般不可以完全独立 | 全屏共享刷新时间；可分批测试 |
| 同一 IC 内 LUT | 不可以 | 通常为全局 LUT |
| 左右两颗 IC 的 LUT | 待验证 | 独立装载/刷新成立时最多两套 |

## 7. 阶段二：原厂 OTP 波形下的颜色状态搜索

### 7.1 目标

1. 建立 7 个已知编码在真屏上的颜色和时序基线。
2. 穷举“原色 → 新色”的有向转换，找出因色料历史产生的新颜色。
3. 对命中颜色继续测试三步序列、重复刷新和停留时间。
4. 将新颜色分为：瞬态、短期稳定、可恢复稳定和不可接受残影。

### 7.2 固定实验条件

- 室温优先保持 23–25 °C；每次记录实际温度。
- 固定光源、相机、焦距、曝光、白平衡、拍摄距离和角度。
- 每个批次开始前执行同一原厂恢复序列。
- 所有刷新必须等待 BUSY 空闲。
- 阶段二不改 LUT、不主动切断刷新中途电源、不探测高压轨。

### 7.3 S2-0：硬件和基线验收

1. 驱动板空载上电，核对输入电压和限流设置。
2. 接牺牲屏，显示全白并等待 60 s，观察过热、异响、气味和异常电流。
3. 显示 7 色条，每种颜色占等面积。
4. 连续重复 3 次：恢复 → 7 色条 → 拍照 → 记录 BUSY 时长和电流。
5. 左右半屏显示相同颜色，比较两侧色差和刷新时间。

放行标准：3 次均可完成；BUSY 不超时；无明显新增坏点/条纹；恢复序列能回到基准状态。

### 7.4 S2-1：两步有向转换全覆盖

设 7 个已知编码为 `C0…C6`。测试所有 `Ci → Cj`：

- 总组合 7 × 7 = 49。
- 去掉 7 个 `Ci → Ci` 基线后，共 42 个有向转换。
- 每批 16 个分区，3 批即可覆盖 42 个转换；剩余格放已知参照色。

每批步骤：

1. 执行原厂恢复序列。
2. 16 格分别写入各自 `source_code`，刷新并等 BUSY 空闲。
3. 等待固定 2 s。
4. 16 格分别写入各自 `target_code`，刷新并等 BUSY 空闲。
5. 在 5 s、60 s、10 min 拍照；期间不再刷新。
6. 记录每格颜色、均匀性、左右边界、残影和是否随时间回退。
7. 执行恢复序列并确认 `recovery_ok`。
8. 将同一批候选左右互换后复测一次；命中项至少再重复 3 次。

候选判定：与 7 个已知颜色中的最近者存在明显色差，且区域内部不是仅由斑驳混色造成的视觉假色。

### 7.5 S2-2：三步状态序列搜索

测试 `Ci → Cj → Ck`：

- 全空间为 7³ = 343 条序列。
- 每批 16 条，需要 22 批。
- 可以先排除 `Ci = Cj = Ck` 等明显无变化项；若追求完整数据库则保留。

每批步骤：

1. 恢复到统一基线。
2. 写 `Ci`，刷新，等 BUSY 空闲，等待 2 s。
3. 写 `Cj`，刷新，等 BUSY 空闲，等待 2 s。
4. 写 `Ck`，刷新，等 BUSY 空闲。
5. 在 5 s、60 s、10 min 拍照并评分。
6. 执行恢复并记录恢复质量。

优先策略：先让 `Ck` 取白、黑、两种蓝色及最可能产生混色的目标码；命中后再补全其余序列。

### 7.6 S2-3：命中颜色的参数精炼

对每个候选颜色单独测试：

- 中间等待：0.5 s、2 s、10 s、60 s。
- 相同目标重复刷新：1、2、3 次。
- 候选序列重复：至少 10 次。
- 保存时间：立即、1 min、10 min、1 h、24 h。
- 左右 IC 互换位置，并在屏幕中心/边缘互换位置。

注意：等待时间可能不改变“无电场时”的颜料位置，但可揭示松弛、残影和温度漂移，因此只对命中项测试，不必全空间扫描。

### 7.7 S2-4：阶段二结果分级

| 等级 | 条件 | 后续 |
|---|---|---|
| A | 新颜色明显；10 次可重复；24 h 仍可辨；可完全恢复 | 纳入调色板候选 |
| B | 新颜色明显；重复性一般或存在轻微残影；可恢复 | 进入阶段三重点对象 |
| C | 仅短时可见或区域严重斑驳 | 记录但不优先 |
| D | 导致 BUSY/电流异常、不可恢复残影或坏点 | 加入禁用序列并停止相邻搜索 |

### 7.8 阶段二逻辑分析仪的使用

阶段二正常运行时可以不用逻辑分析仪。以下情况再接入：

- BUSY 偶发不返回或左右半屏不同步。
- 怀疑 DC/CS 时序、命令间隔或复位过程有误。
- 需要为阶段三保留一份“原厂初始化 + 刷新”的基准捕获。

推荐通道：`SCL`、`SI0`、`DC`、`CSB`、`SL_CSB`、`RST_N`、`BUSY_N`、`POWER_EN`。SPI 较低速时，25–50 MS/s 已有足够余量；只有更高速总线才提高采样率。

### 7.9 2026-08-30 RAW-P16 T2 discovery successor V2 人工粗发现

fresh T2 V2 action=
`c184e610cc2ac464ca152eb1af7a0a9f746e5d92c38da53b673de9c0dcdcfd1f`
已 `complete_pass`，每侧 `4×8`，driver=`41913 ms`。人工第一行：

```text
CS1 / commented535(C): 橄榄、黑、绿、白、浅黄、蓝、黄、黑
CS2 / active535(A):    红、粉、绿、白、棕、蓝、深粉、深蓝
```

同一侧四行呈相同颜色集合、不同顺序，观察期间稳定。该记录尚无色卡或受控相机量化，仅为
人工 discovery 候选；不证明绝对颜色、单像素新颜料、正式灰阶、跨位置/跨批重复性或可用
palette，`qualified_colour_count=0`。

精确绑定的 W3 factory-OTP-white action=
`b37e6e5846eecff74b0d478dcdcf5223cdb20f2aa794a2b7f264c42bc21a87e9`
已 `complete_pass`，driver=`35014 ms`；操作者确认全屏干净白，最终 J2 commanded/query OFF。

本轮没有执行 RAM-LUT 写入、未知命令枚举或阶段三 T3，故以下阶段三硬前提与状态均不改变。

## 8. 阶段三：RAM LUT 和自定义波形实验

### 8.1 阶段三的硬前提

面板规格出现“SRAM/LUT”和“波形在 OTP”并不自动证明 MCU 可以任意写 RAM LUT。必须至少取得以下一种证据：

1. SPD1657B 官方/原厂命令资料，明确列出 LUT 装载、长度、相位格式和激活命令；或
2. 一块已知支持自定义 LUT 的参考驱动板/测试仪总线捕获，可完整重复其写入流程；或
3. 现有工作固件确实发送一段可识别的 LUT 数据，且能通过单字节变更验证作用。

如果只有面板 PDF，阶段三停在协议采集，不执行 LUT 写入。

### 8.2 S3-0：逻辑分析仪捕获基线

接入通道：

| 通道 | 信号 | 目的 |
|---:|---|---|
| 0 | SCL | SPI 时钟和解码 |
| 1 | SI0/MOSI | 命令/数据 |
| 2 | DC | 区分命令和数据 |
| 3 | CSB | 主 IC 事务边界 |
| 4 | SL_CSB | 从 IC 事务边界 |
| 5 | RST_N | 复位和初始化边界 |
| 6 | BUSY_N | 刷新时长及忙极性 |
| 7 | POWER_EN | 冷启动时序 |
| 8 | BUS_EN/Power-Good | 可选，总线隔离状态 |

捕获四类操作：

1. 冷上电和完整初始化。
2. 仅写 RAM、不刷新。
3. 单色全屏刷新。
4. 7 色条刷新和正常 Power-Off。

每个捕获文件同时保存固件版本、SPI 频率、温度和照片。触发点优先选 `POWER_EN` 上升沿、`RST_N` 上升沿或 `CSB` 下降沿。

### 8.3 S3-1：确认 RAM LUT 能力

必须回答：

- LUT 是从 OTP 自动复制到 RAM，还是 MCU 直接写入？
- LUT 写命令、地址、总字节数和各表偏移是什么？
- 是否有校验和、解锁、写保护或特殊上电窗口？
- LUT 对主/从 IC 是分别写入还是广播？
- 是否存在 LUT/状态读回命令？`SI0` 读模式的方向切换如何完成？
- 每个相位的驱动状态枚举和时长单位是什么？
- VCOM、border、温度分支和各颜色转换表是否独立？
- LUT 生效后是一次性使用、持续到复位，还是会写入非易失区？

安全要求：只允许写易失 RAM；在完全确认命令前，不执行任何可能写 OTP/NVM 的命令。

### 8.4 S3-2：未修改基线 LUT 等价验证

这是阶段三最重要的门槛。

1. 获取原厂工作 LUT 的完整字节序列或可重复装载形式。
2. 冷启动，以原厂 OTP 路径刷新 7 色条，记录照片、BUSY 时长和电流。
3. 冷启动，把“未修改的同一 LUT”写入 RAM。
4. 用完全相同的图像和环境刷新。
5. 比较左右两侧、颜色、BUSY 时长、电流和恢复效果。
6. 重复至少 3 次。

放行标准：显示结果、刷新时间和电流趋势应与基线一致；如有系统性差异，说明 LUT 解析或装载仍不正确，禁止继续变异。

### 8.5 S3-3：波形参数模型

在格式确认后，把 LUT 解析为可审查的参数，而不是直接随机字节：

```yaml
candidate_id: lut_0001
base_lut_sha256: ...
target_transition: Cx_to_Cy
phases:
  - drive_state: VALID_ENUM
    duration_ticks: N
    paired_group: 1
constraints:
  total_duration_ratio: 0.90
  charge_pair_preserved: true
  otp_write_command_present: false
```

可搜索变量：

- 完整相位块的保留/删除。
- 成对相位的时长同比缩放。
- 某个源色 → 目标色转换的驱动状态序列。
- 合法范围内的重复次数。
- VCOM/border 相关字段仅在格式完全确认后单独测试。

禁止的初始搜索方式：

- 对 LUT 原始字节做无约束随机翻转。
- 在相位中途直接切电，以“停住颜色”。
- 未确认枚举含义就写入未知驱动状态。
- 同一次测试同时改变电压、相位、温度和颜色历史。
- 写入任何可能指向 OTP/NVM 编程的命令。

### 8.6 S3-4：保守的搜索顺序

第一轮只做低能量、结构保持的变化：

1. 保持驱动状态顺序不变，成对缩短相位时长，例如从基线的 100% 逐步降到 95%、90%、85%。
2. 仅在完整且已确认平衡的相位块边界截短。
3. 每次只修改一个转换项，并保留其它表为基线。
4. 每个候选先在小面积区域测试，另一半显示基准对照。
5. 候选通过恢复测试后，才扩大面积或增加重复次数。

第二轮才考虑：

- 对命中候选做更细时间步进。
- 在保持配对关系的前提下增减完整相位组。
- 调整相邻合法驱动状态。
- 测试温度分支，但仍保持 0–50 °C 内并优先 23–25 °C。

### 8.7 S3-5：单个候选的执行流程

1. 检查候选文件的格式、长度、哈希和安全约束。
2. 冷启动并运行健康检查。
3. 显示原厂基线图，确认屏幕可恢复。
4. 装载候选 RAM LUT；如支持读回，逐字节校验。
5. 设置 16 格源状态；刷新并等待 BUSY 空闲。
6. 设置 16 格目标状态；用候选 LUT 刷新。
7. 同步记录 BUSY、输入电流和 SPI 事件。
8. 在 5 s、60 s、10 min 拍照。
9. 重新装载原厂 LUT/复位回 OTP 路径。
10. 执行原厂恢复序列并拍照。
11. 根据异常条件决定继续、冷却或终止队列。

如果确认左右 IC 独立：左侧运行候选 LUT，右侧运行未修改基线 LUT，下一轮左右互换。否则使用整屏同一 LUT，并以相邻批次做对照。

### 8.8 S3-6：自动化搜索策略

使用“候选生成器 → 约束检查 → 真屏执行 → 图像评分 → 恢复验证”的闭环：

1. 从等价基线 LUT 生成候选。
2. 静态检查长度、字段合法性、相位对称/配对、总时长和禁止命令。
3. 一次只运行一个候选或左右各一个候选。
4. 计算候选区域相对 7 个已知颜色的最小色差。
5. 同时评价均匀性、左右差异、残影、BUSY 时长、电流和恢复质量。
6. 新颜色且可恢复的候选进入邻域细化；异常候选及其相邻高应力方向加入禁区。
7. 每个会话设定最大候选数；到达上限后人工检查照片和屏幕，再决定是否继续。

建议评分：

```text
总分 = 新颖色差分 + 均匀性分 + 保持分 + 可重复分
       - 残影罚分 - 电流异常罚分 - BUSY 异常罚分 - 恢复失败罚分
```

颜色“新颖”不能只看 RGB 数值。相机先用灰卡/色卡校正，再将区域颜色转换到 Lab，计算其到 7 个已知颜色的最小 ΔE00；同时保留原始 RAW/JPEG，避免自动白平衡制造假色。

### 8.9 阶段三停止条件

满足任一项立即关闭总线、等待安全状态后断驱动板输入，并停止自动队列：

- BUSY 超过基线允许范围或长时间不返回。
- 输入电流显著超过已验证基线，或电源进入限流。
- 驱动板、FPC 或面板局部异常发热、异味、啸叫。
- 出现扩大的永久线条、块状坏点、闪烁或左右失步。
- 原厂恢复序列连续两次不能恢复基准白场/色条。
- LUT 读回与写入不一致。
- 日志、相机或逻辑分析记录缺失，无法追溯候选。
- 软件检测到未知字段、长度错误、OTP/NVM 命令或不受支持的驱动状态。

## 9. 电流限制和风险控制

- 面板规格中的工作电流为 TBD，不能直接抄一个固定限流值。
- 先用原厂 7 色条和高负载图案测得正常启动峰值与刷新峰值，再在“不会误触发正常启动、但能拦截明显故障”的位置设限流。
- 第一轮自定义 LUT 的总时长/应力不超过基线；先缩短、后细化，再谨慎考虑增加。
- 每个候选后都要执行可恢复的原厂清屏，不允许连续无限叠加未知偏置。
- 逻辑分析仪只接数字低压信号；测高压电源需要合适示波器探头、接地方法和操作者经验。
- 屏幕断电后图像仍会保持，这不代表驱动 IC 仍有电。判断冷启动必须测驱动板输入/逻辑电源，而不是看画面。

## 10. 执行排期建议

| 工作包 | 内容 | 预计批次 | 产出 |
|---|---|---:|---|
| WP0 | 接线、电源时序、相机和 7 色基线 | 1–2 天 | 基线照片、电流、BUSY 数据 |
| WP1 | 42 个两步有向转换 | 3 批 + 镜像复测 | 两步转换矩阵 |
| WP2 | 343 个三步序列 | 22 批 | 三步状态数据库 |
| WP3 | 命中项重复、等待、24 h 保持 | 按命中数 | A/B/C/D 分级调色板 |
| WP4 | SPD1657B 协议资料和总线捕获 | 不定 | 命令表、LUT 结构、证据包 |
| WP5 | 未修改 RAM LUT 等价验证 | ≥3 次 | G4 放行或停止报告 |
| WP6 | 受约束 LUT 搜索 | 每会话限额 | 候选 LUT、照片、日志和评分 |
| WP7 | 命中波形稳定性/可靠性 | 后续阶段 | 可用波形集合和风险说明 |

## 11. 每日开工检查表

- [ ] FPC 方向、锁扣和转接板无松动。
- [ ] 驱动板输入电压正确，电流限制已加载。
- [ ] 继电器/负载开关默认关闭。
- [ ] MCU 复位时 `POWER_EN` 默认关闭、SPI 不反向供电。
- [ ] BUSY 极性已由本次固件实测确认。
- [ ] 室温、光源、相机参数已记录并锁定。
- [ ] 基线 7 色条和恢复序列正常。
- [ ] 测试计划、固件哈希和候选 LUT 哈希已记录。
- [ ] 自动停止条件和最大候选数已启用。
- [ ] 照片、串口、逻辑分析和电流日志目录可写。

## 12. 单次异常处置

1. 停止发送 SPI 命令。
2. 若 BUSY 仍正常结束，等待其空闲；若硬件明显异常，直接关闭驱动板主输入。
3. 保存当前日志、候选 LUT 和最后一张照片，不自动覆盖。
4. 冷却并检查输入残压、FPC、连接器和驱动板温度。
5. 重新上电后只运行原厂基线，不立即重跑候选。
6. 原厂基线不正常则封存该屏和候选，不继续搜索。

## 13. 阶段性交付物

阶段二完成时应有：

- 7 色基准图和颜色编码表。
- 49 项两步转换矩阵（含 7 项自转换基线）。
- 343 项三步序列结果或明确的裁剪规则。
- 每个命中颜色的序列、照片、重复性、保持时间和恢复评级。
- 左右 IC 差异报告。

阶段三完成时应有：

- SPD1657B 初始化、LUT 装载和刷新协议说明。
- 原厂/等价 RAM LUT 文件及哈希。
- 逻辑分析捕获文件和通道定义。
- 每个候选 LUT 的结构化参数、原始字节、运行日志和图片。
- 新颜色调色板、推荐波形、禁用波形和恢复流程。
- 对牺牲屏损伤、残影和重复性限制的真实记录。

## 14. 当前最合理的采购结论

1. 保留 DSLogic Plus 100 MHz 16 通道，不升级 U2Pro16。
2. 如果已有合格可调电源，先买一个有明确串口协议、NO 触点默认断开的 USB 单路继电器；Numato 单路 USB SPDT 是可参考的成熟型号。
3. 如果计划长期无人值守自动化，并且驱动板输入 ≤5.7 V，增加 TPS22975/TPS22975EVM 和带部分掉电保护的三态总线缓冲器。
4. 优先投入固定照明、相机固定架、50-pin 0.5 mm FPC 转接板和可追踪日志；这些对找到“真正的新颜色”比升级逻辑分析仪更重要。
5. 在拿到 SPD1657B 命令表或可复现 LUT 总线捕获之前，不进行阶段三 LUT 写入。

## 15. 参考资料

- `MF-1750..1).pdf`：MF-17506-M009F-T 规格书，A1，2026-02-28。
- Numato 1 Channel USB Powered Relay（SPDT）：https://numato.com/docs/nl-usbr-c-001/
- TI TPS22975：https://www.ti.com/product/TPS22975
- TI TPS22975EVM：https://www.ti.com/tool/TPS22975EVM
- RIGOL DP900 系列：https://www.rigol.com/intl/products/dc-power-supply/DP900.html
- OWON ODP 系列：https://tw.owon.com/products_info.asp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
