oceanye/ESP32_C73-MF1750/docs/MF-17506-M009F-T_阶段二与阶段三落地执行流程.md

# MF-17506-M009F-T 阶段二与阶段三落地执行流程

版本：执行补充 v1.0  
日期：2026-08-20  
上位计划：[`MF-17506-M009F-T_阶段二与阶段三测试计划.md`](MF-17506-M009F-T_阶段二与阶段三测试计划.md)  
上位计划当前文件 SHA-256：`e83895293cc1652524b46159ccd79d5fcbd243425ee40f575621f374aeb7343a`  
静态照片代码规格：[`MF-17506-M009F-T_静态照片阶段二代码实施规格.md`](MF-17506-M009F-T_静态照片阶段二代码实施规格.md)  
当前状态入口：[`STATUS_HANDOFF.md`](STATUS_HANDOFF.md)

状态：`OFFLINE EXECUTION DESIGN / RELAY PROCURED NOT COMMISSIONED / LOGIC ANALYZER NOT AVAILABLE / NO LIVE AUTHORIZATION`

> **2026-08-21 状态覆盖：** 操作者已关闭阶段二，取消未完成的色卡/保持/重复资格化；逻辑
> 分析仪不再作为经验 H3 profile 试验的开工前置，只保留为辅助捕获。仓库后续已经完成继电器
> 实物控制、WF20 C/T 真屏因果对照和 D1-512 全空间筛查；历史 `PENDING/0 of 4` 数值不得继续
> 当作当前状态。阶段三按新裁决先准备 WF23 standalone treatment；严格 ABI 仍未证明，禁止盲扫
> 命令、随机修改 opaque body、写 VCOM/高压/OTP/NVM 或刷新中切电。当前状态以
> `STATUS_HANDOFF.md` 与阶段二关闭裁决文件为准。

本文不替换上位计划，而是把它落成可实施的设备门、软件包、批次顺序、人工交接和证据结构。
本文不授权访问 USB/COM、上电、刷写、RESET、继电器动作、面板刷新或 LUT 写入。

## 1. 当前执行判断

1. USB/COM 控制继电器已经采购，但型号、串口协议、VID/PID/序列号、上电默认状态和失联行为
   尚未在本仓库封存，因此状态为 `PROCURED_NOT_COMMISSIONED`，不能直接接入驱动板。
2. 逻辑分析仪尚未到位。它不阻塞阶段二的离线开发、继电器验收和 factory-OTP 状态搜索，
   但阶段三保持硬阻塞；没有逻辑分析仪也没有同版 SPD1657B LUT 命令证据时，禁止写 LUT。
3. 当前面板已由操作者确认 `J2=OFF / 全屏干净白 / 无残留 / 无声味热异常`。开始新会话前
   必须重新取得现场数值，不能继承该历史确认。
4. 继电器只负责会话上电、正常收尾断电和故障切断。正常的相邻刷新之间保持供电，不因每个
   action 反复切换继电器；刷固件、改接线、合同要求冷启动或异常恢复时才做电源循环。
5. 第一阶段自动化始终为“有人监督的逐批执行”。USB 继电器不是无人值守安全证明，也不替代
   电源限流、物理切断、温度/电流观察和人工停机。

## 2. 现有证据抵扣与新计划缺口

| 项目 | 已有证据 | 在本计划中的处理 | 仍需补齐 |
|---|---|---|---|
| 原生 transport code | 八码 atlas 已得到 7 个视觉组，`code4 ≡ code7`，其余六码可区分 | 作为先导证据和批次参照 | 新夹具/新屏上的 3 次基线重复、固定相机和正式色差记录 |
| 两步 old→new | 已完成双控制器完整 8×8 primer→target 首轮，左右反序；code4/code7 列出现历史亮度分层，其余列无纵向变化 | 不再把“是否覆盖”当未知；用于排列正式确认批次和高优先候选 | 5 s/60 s/10 min 时间点、16大格、镜像、重复和统一温度证据 |
| U04/U07 六前态 | 六个前态到 U04/U07 后均为一致蓝色，两 target 肉眼无差别 | 降低相同路径的重复优先级 | 仅在新矩阵出现矛盾或需要仪器定量时复测 |
| 白恢复 | 多条路径均能恢复干净白；最近标准全白为 RC2G Job/Operation 4/4 | 作为每批收尾基线 | 新会话仍须验证；历史成功不授权失败后的自动第二次恢复 |
| 空间抖色 | 70 ROI atlas 与照片分析完成，出现橙、浅黄、黄绿、紫、棕、青绿和粉红等空间混色 | 与原生单像素状态搜索分开记账 | 可选渐变/效果扩展另建 release，不混入本阶段二 42/343 序列 |
| RAM LUT | 同版 SPD1657B 精确命令、799/704-byte 双控 ABI 和电气字段仍无直接证据 | 阶段三保持 `NO-GO` | 官方命令资料或可复现参考捕获、完整格式、等价 RAM LUT |

现有 8×8 矩阵结果入口：

- `../.test-output/hardware/MF1750_EC5_OTP_TRANSITION_MATRIX_LIVE_20260810_V1/ordinal-02-target-result.json`
- `../.test-output/hardware/MF1750_EC5_OTP_TRANSITION_MATRIX_LIVE_20260810_V1/ordinal-02-target-observation.json`
- `../.test-output/hardware/MF1750_EC5_OTP_TRANSITION_MATRIX_LIVE_20260810_V1/ordinal-03-white-result.json`
- `../.test-output/hardware/MF1750_EC5_OTP_TRANSITION_MATRIX_LIVE_20260810_V1/ordinal-03-white-observation.json`

## 3. 门禁与设备到位状态

| Gate | 名称 | 当前状态 | 放行条件 | 可执行内容 |
|---|---|---|---|---|
| D0 | 离线设计门 | `OPEN` | 不访问设备，所有计划可重放 | 计划编译器、fake relay、schema、测试、预览 |
| R0 | 继电器身份门 | `PENDING ARRIVAL/INFO` | 型号、手册、触点额定值、VID/PID/serial、命令协议封存 | 只读枚举与离线 adapter 选择 |
| R1 | 继电器空载门 | `PENDING` | 默认 NO、枚举不抖动、命令幂等、重连行为已测 | 空载 ON/OFF，不接驱动板 |
| R2 | 继电器低压假负载门 | `PENDING` | 100 次循环无误吸合；失联/进程退出行为已记录 | 万用表或安全假负载测试 |
| R3 | 驱动板无屏门 | `PENDING` | 输入残压/衰减、反向供电和上电时序通过 | 驱动板供电，不接面板 |
| S20 | 阶段二基线门 | `PENDING FRESH SESSION` | 面板、RC2G/固件、供电、相机和 7 色基线通过 | factory-OTP 可见动作 |
| S21 | 两步确认门 | `PENDING` | 三个正向批次和三个镜像批次均完整恢复 | 候选筛选与重复 |
| L0 | 逻辑分析仪设备门 | `BLOCKED: NOT AVAILABLE` | 型号/序列号封存，已知 SPI 自测解码通过 | factory-OTP 数字捕获 |
| G3 | LUT 命令证据门 | `BLOCKED` | 官方资料或完整可复现写 LUT 捕获；OTP/NVM 命令可排除 | 只允许构建 RAM-LUT loader 候选 |
| G4 | 等价 LUT 门 | `BLOCKED` | 未修改 RAM LUT 与 OTP 基线至少 3 次等价 | 单变量、低应力 LUT 候选 |

任何后级 Gate 不能用“设备已采购”“命令看起来相似”“面板 PDF 提到 SRAM/LUT”替代。

## 4. PC 侧软件落地架构

建议新增以下彼此隔离的模块；真实设备 adapter 在 R0 后才实现：

```text
tools/mf17506_stage23/
├─ plan_compiler.py          # 生成批次、镜像位置、动作身份和预览
├─ relay_contract.py         # 继电器接口、状态机和 fail-closed 规则
├─ relay_fake.py             # 离线 fake，覆盖断连/超时/误回包
├─ relay_<model>.py          # R0 后按实物型号新增，不猜协议
├─ session_runner.py         # 电源、MCU、相机提示和证据落盘编排
├─ observation.py            # 人工观察输入与封存
├─ analyzer.py               # Lab/ΔE00、均匀性、保持和恢复分析
└─ logic_import.py           # L0 后导入 DSLogic 捕获；阶段二可缺省
```

### 4.1 继电器统一接口

真实 adapter 至少实现：

```text
discover() -> exact device identity
connect(expected_identity)
command_off()
command_on()
read_commanded_state() -> ON/OFF/UNKNOWN
close()
```

`read_commanded_state()` 只代表控制器回报，不证明驱动板真的有电或已经掉电。R2/R3 必须通过
电压或电流实测标定。软件不得只凭 COM 号选设备，必须同时绑定 VID、PID、USB 序列号和型号；
MCU 与继电器端口必须由不同 identity 区分。

### 4.2 电源状态机

```text
SAFE_OFF
  └─ operator gate + relay identity + electrical setup
       → POWERING_ON → ON_VERIFY → RUN_READY
RUN_READY
  ├─ exact visible action → ACTION_ACTIVE → RUN_READY
  ├─ normal close → POWERING_OFF → OFF_VERIFY → SAFE_OFF
  └─ anomaly → FAULT_LATCHED → emergency OFF → manual inspection
```

- `POWERING_ON` 期间禁止 MCU 刷写和可见刷新。
- `ACTION_ACTIVE` 期间普通软件不得切继电器；只有明确硬件异常允许紧急断电。
- 任一串口超时、回包不符、日志落盘失败或状态为 `UNKNOWN` 都进入 `FAULT_LATCHED`，不自动重试。
- 程序退出时尝试发送 OFF，但若实测继电器在 USB 失联后保持最后状态，就不能把退出清理视为
  硬件 failsafe；在增加 watchdog/eFuse 前禁止无人值守。

### 4.3 运行证据目录

```text
.test-output/hardware/MF17506_STAGE23_<SESSION_ID>/
├─ SESSION-MANIFEST.json
├─ DEVICE-IDENTITIES.json
├─ RELAY-EVENTS.ndjson
├─ MCU-TRANSCRIPT.ndjson
├─ POWER-OBSERVATIONS.csv
├─ CAMERA-CONTRACT.json
├─ actions/
│  └─ <ordinal>-<action-id>/
│     ├─ ACTION-MANIFEST.json
│     ├─ RESULT.json
│     ├─ OBSERVATION.json
│     └─ photos/
└─ logic/                    # L0 前必须为空且 manifest 明确 not_available
```

所有 manifest 先于设备动作生成；结果使用新文件原子落盘，禁止覆盖。每次动作记录 firmware、
plan、frame、relay adapter 和 LUT（若有）的 SHA-256。claim 后发生超时则结果为
`UNKNOWN_DO_NOT_RETRY`，不能自动补发同一可见动作。

## 5. 继电器到位后的验收流程

### R0：身份和文档封存

1. 拍摄继电器正反面、端子标识和铭牌。
2. 保存厂家命令手册或协议文本，不从其他相似板卡猜命令。
3. 只连接 PC，不接触点负载；读取设备管理器/USB 枚举的 VID、PID、serial、COM 和驱动名。
4. 验证插入、拔出和 PC 重启时触点默认状态；用万用表蜂鸣/电阻档确认 COM–NO。
5. 若上电、枚举或打开串口会短暂吸合，R0 直接失败，不接驱动板。

### R1/R2：空载和假负载

1. 运行 OFF 10 次，确认幂等且不会反向变 ON。
2. 运行 `ON→OFF` 100 次，记录命令、回包、接点状态和动作时间。
3. 分别在 ON 和 OFF 时拔 USB、关闭控制进程、让 PC 睡眠/唤醒，记录继电器保持还是释放。
4. 制造串口占用、乱码、半包和超时，fake/真实 adapter 均应 fail closed。
5. 若继电器失联后保持 ON，标记 `NO_HARDWARE_FAILSAFE`；仍可有人监督使用，但不能无人值守。

### R3：驱动板无屏验收

1. 物理切断保持可用；面板不接，MCU SPI 先置安全态。
2. 电源正极通过 `COM→NO` 接驱动板输入；负极和 MCU 共地。继电器不得旁路现有物理切断。
3. 校准 ON 后输入稳定时间、OFF 后输入和 TP1 残压下降时间。
4. MCU USB 保持连接，继电器 OFF 时检查驱动板是否被 SPI/GPIO 反向供电。
5. 如有反向供电，先增加具备部分掉电保护的三态缓冲器；未解决前不得接屏自动循环。

R0–R3 全部通过后，才能生成绑定该继电器 identity 的真实 session release。

## 6. 阶段二的正式执行顺序

### 6.1 七个正式视觉状态

阶段二主矩阵固定使用 transport code `0–6`：

| code | 当前人工颜色名 | 角色 |
|---:|---|---|
| 0 | 黑 | 正式状态 |
| 1 | 白 | 正式状态/恢复参照 |
| 2 | 黄 | 正式状态 |
| 3 | 红 | 正式状态 |
| 4 | Blue-1 | 正式状态 |
| 5 | Blue-2 | 正式状态 |
| 6 | 绿 | 正式状态 |
| 7 | 与 code4 肉眼等色 | alias 控制，不作为第八个新颜色 |

每个正式批次保留至少一个 `code4↔code7` alias 控制格，用于发现控制器或会话漂移。

### 6.2 S2-PRE：完全离线准备

1. 生成 42 个 `Ci→Cj, i≠j`，按 14 项/批分为 A/B/C 三批；每批另留 2 格为白和 alias 控制。
2. 为每批生成左右位置镜像版 A′/B′/C′，pair identity 不变，只改变 ROI。
3. 冻结 source/target/white 三帧及 preview SHA-256；每批最多 3 个可见动作。
4. 为照片预生成 ROI、编号、灰卡区域和文件名，不依赖现场手工命名。
5. 生成 dry-run transcript，fake relay 和 fake MCU 下证明 0 真实 I/O、异常不自动继续。

### 6.3 S2-0：新测试台基线

1. fresh 现场检查并建立 session；继电器处于 OFF，物理切断就绪。
2. 上电、初始化 factory OTP，执行全白健康检查。
3. 执行三轮 `7色条→观察/拍照→标准白恢复`，总计 6 个可见动作；正常轮次之间不切继电器。
4. 每轮记录 BUSY、输入电流、温度、左右一致性和白恢复。
5. 三轮任一异常即停止；不得为了凑足三轮自动重放失败动作。

S2-0 通过只证明新测试台基线稳定，不自动授权 S2-1。

### 6.4 S2-1：42 个两步转换正式确认

每个 A/B/C 或 A′/B′/C′ 批次：

1. 标准白恢复并确认基线。
2. 显示 source frame；等待 BUSY 完成和固定 2 s。
3. 显示 target frame；等待 BUSY 完成。
4. 在 5 s、60 s、10 min 拍照；这 10 min 内保持统一的 powered-idle 条件，不切继电器。
5. 记录每格颜色、均匀性、旧态轮廓、边界、左右差异、电流和温度。
6. 执行一次标准白恢复并人工确认。
7. 到达批次安全停点；下一批必须由操作者继续，不自动串行。

正式覆盖量：3 个正向批次 + 3 个镜像批次，每批 `source→target→white`，共 **18 个可见动作**。
时间点拍摄不是可见动作。现有 8×8 结果是先导证据，不计入这 18 个新测试台正式动作。

### 6.5 候选判定和重复

初筛只标记，不立即宣称新颜色：

- `H0`：落在既有 7 色组内；
- `H1`：可能只是不均匀/网点/残影造成的假色；
- `H2`：与最近已知色有稳定差异，待镜像和重复；
- `H3`：出现电气、BUSY 或恢复异常，立即禁用并封存。

只有正向和镜像都为 H2 的 pair 才进入确认。先重复 3 次；仍成立后再做 10 次重复、
0.5/2/10/60 s dwell 和 1 h/24 h 保持。1 h/24 h 必须在 manifest 中固定为
`powered_idle` 或 `safe_power_off`，两种保持模式不得混在同一统计中。

### 6.6 S2-2：三步序列不是默认全量队列

`7³=343` 条序列若按 16 格执行，需要 22 批；每批至少
`source→mid→target→white` 四个可见动作，即 **88 个动作**。若全量再做左右镜像，则至少
**176 个动作**，尚未计入重复和异常恢复。

因此默认流程为：

1. 只从 S2-1 的 H2 候选生成优先三步序列；
2. 每条候选的前态扩展、目标扩展和 alias 控制由 plan compiler 确定并完整列出；
3. 先运行一个不超过 16 条的批次，人工评审后再决定是否扩展；
4. 若 S2-1 没有 H2，阶段二以“未发现新增可重复单像素状态”结束，不穷举 343；
5. 只有用户明确选择“建立完整状态数据库”时才生成 343 全量 release，且必须另行预算屏耗和时间。

裁剪不是删除数据：所有未执行序列必须在最终报告中列出 `NOT_RUN` 和确定性裁剪理由。

## 7. 逻辑分析仪到位后的流程

### L0：设备自测

1. 封存型号、硬件序列号、软件版本和探头定义。
2. 用已知频率方波和已知 SPI fixture 做 25/50/100 MS/s 自测；确认边沿、位序和时间基准。
3. 检查所有探头仅连接数字低压信号，共地方式正确；禁止连接 VGH/VGL/VSH/VSL/VCOM。

### L1：factory-OTP 基准捕获

在不改 LUT 的固件上捕获并分别保存：

1. 冷上电、复位和完整初始化；
2. 仅写显示 RAM、不刷新；
3. 全白刷新；
4. 7 色条刷新；
5. 正常 Power-Off/Deep-Sleep。

每个捕获至少保存原始工程文件、导出 CSV/二进制、通道定义、触发点、采样率、固件哈希和照片。
解析结果必须能与固件发出的命令/数据计数相互核对。

L1 可以在阶段二基线会话中附带完成，但逻辑分析仪未到位时不得伪造 `logic_file`；字段应明确为
`not_available`，不能写空文件冒充捕获。

## 8. 阶段三的逐门落地流程

### G3：命令和格式证据

L1 捕获普通 factory-OTP 初始化并不等于发现 RAM-LUT 写命令。进入 loader 实现前必须确定：

- 写入是易失 RAM，而非 OTP/NVM；
- 主/从 IC 的选择方式、命令、长度、表偏移和激活流程；
- 相位驱动枚举、时长单位、VCOM/border/温度分支；
- 是否可读回，以及读方向切换；
- 复位/掉电后的失效边界。

若捕获中根本没有 LUT payload，结论应是“当前路径使用 OTP，未观察到 host LUT”，而不是尝试
猜写相邻芯片命令。

### G4：未修改基线 LUT

只有取得完整原厂等价 RAM LUT 才执行：

1. OTP 路径基线 7 色条与白恢复，三次；
2. 冷启动后写入逐字节相同的 RAM LUT；支持读回时必须全量一致；
3. 相同帧、温度、SPI 和相机条件下重复三次；
4. 比较颜色、BUSY、电流、左右一致性和恢复。

无法读出或重建完整基线 LUT 时，G4 不可测试，阶段三停止；不能用“全 `00`/`FF`”或相邻型号
样例代替未修改基线。

### S3-C1：首轮候选

G4 通过后才允许：

1. 每个候选从已验证基线结构派生，保留禁止命令扫描和完整 SHA-256；
2. 首轮仅对已证明成对的完整相位做 `100%→95%→90%→85%` 的同比缩短；
3. 一次只改变一个转换项，不改电压、温度和其它表；
4. 小面积 active pixels 只减少参与像素数，不代表 LUT 本身局部生效；仍按全局 LUT 风险管理；
5. 初始每个会话最多 1 个候选，人工检查恢复后才能提高会话上限；
6. 每个候选独立授权、独立 claim，不自动重试，不在失败后自动写第二套 LUT。

出现 BUSY/电流/温度/左右失步/读回/恢复任一异常时，先正常停止命令；若有硬件危险则继电器
立即断电并锁存 `FAULT_LATCHED`。后续只允许人工检查和原厂基线恢复，不重跑候选。

## 9. 分阶段软件工作包

| 工作包 | 现在能否做 | 实现内容 | 完成定义 |
|---|---|---|---|
| D1 evidence-gap | 是 | 读取现有 matrix/COLOR_LAB/dither 结果，生成已覆盖/待补表 | 确定性报告、0设备I/O |
| D2 plan compiler | 是 | 42 pair、A/B/C、镜像、ROI、帧、预览和动作身份 | unit tests 覆盖重复/遗漏/左右镜像 |
| D3 relay contract/fake | 是 | 状态机、异常注入、事件日志、adapter 接口 | 断连/乱码/超时均停队列 |
| D4 session dry-run | 是 | fake relay + fake MCU + 人工提示 + 原子证据 | 全批次 dry-run 0真实I/O |
| R4 real adapter | 待R0 | 按精确继电器协议实现 | R0–R2 实测及回归通过 |
| R5 power integration | 待R3 | 实测上/掉电、残压和反向供电门 | 无屏测试通过 |
| S2 release | 待R5 | 绑定 panel/firmware/relay/camera 的正式阶段二 release | live_authorized=false，待逐批授权 |
| L2 capture importer | 待L0 | 导入/校验 DSLogic 原始捕获和通道定义 | 已知 SPI fixture 重放一致 |
| S3 loader | 待G3 | 仅允许已证易失 RAM-LUT 命令 | 未过G3时编译/运行均 hard-block |
| S3 candidate engine | 待G4 | 结构化单变量候选和静态约束 | fake-only 反例与边界测试通过 |

## 10. 建议排期

### 现在至继电器到位

- 完成 D1–D4；不连接设备。
- 固定 42 pair 的批次/镜像规则、照片命名和结果 schema。
- 准备继电器信息采集卡，不实现猜测型号的真实串口命令。

### 继电器到位后的第一个半天

- 只做 R0–R2；不接驱动板和面板。
- 若默认态、枚举抖动或失联行为不合格，当天不进入 R3。

### 第二个半天

- 做 R3 驱动板无屏验收、残压和反向供电检查。
- 形成 real adapter identity 和 bench result；仍不刷新面板。

### 第一个阶段二真屏会话

- 只做 S2-0 三轮基线与白恢复。
- 最终继电器 OFF、物理切断确认、屏幕白态观察后安全停机。

### 后续阶段二会话

- 每个会话最多一个 A/B/C 或镜像批次；目标后保留 10 min 观察，再白恢复收尾。
- 六个正式批次完成后统一分析，不在现场临时生成三步序列。

### 逻辑分析仪到位后

- 先 L0 自测，再将 L1 捕获附加到一个已计划的 factory-OTP 基线会话。
- 只有 G3/G4 通过才另排阶段三；否则以协议证据不足正式结项，不做 LUT 写入。

## 11. 每次现场交接的最小消息

### 会话开始前

```text
panel_id=___；
J2/物理切断=OFF；
继电器命令状态=OFF；驱动板输入实测=___ V；
MCU USB identity=___；继电器 USB identity=___；
屏幕状态=___；温度=___°C；电源电压=___ V CV；限流=___ A；
相机/照明配置已锁定；无异响、异味或异常发热；
本次只申请执行批次=___。
```

### 每批结束后

```text
batch_id=___；动作结果=___；BUSY=___ ms；
目标后5s/60s/10min照片=___/___/___；
最高电流=___ A；最高温度=___°C；
白恢复=通过/失败；残影/条纹/边界异常=___；
继电器状态=___；驱动板输入=___ V；是否停止=是/否。
```

## 12. 当前下一步

当前不需要打开 J2、连接继电器触点或等待逻辑分析仪才能继续的软件工作是 D1–D4。
真实继电器 adapter 开工前只缺一组设备身份输入：**继电器精确型号、厂家协议/说明书、触点额定值，
以及到货后只连接 PC 时的 VID/PID/USB serial/默认触点状态**。

阶段二的第一个真屏门是 R0–R3 全部通过后的 S2-0，不是直接开始 42/343 队列。阶段三的第一个门
是 L0/L1/G3，不是试写候选 LUT。
