oceanye/ESP32_C73-MF1750/docs/MF1750_WROOM_B3_R3_PLACEMENT_MIGRATION_AUDIT_2026-08-24.md

# MF1750 WROOM B3 R3 PCB 布局迁移审计

- 日期：2026-08-24
- 审计类型：`REVIEW_ONLY`
- 输入：冻结 B2 PCB、当前 B3 R2 布局候选 PCB、B3 R3 器件冻结与约束台账
- 输出边界：本文档只记录迁移证据、布局建议和 HOLD；未修改 PCB、原理图或生成器

## 1. 结论

1. **B2 与当前 B3 R2 的完整几何一致是事实基线，不是 R3 的“全不变”要求。** B2 的 61 个封装位置/面/角度在当前 R2 PCB 中一致；629 段走线 + 75 个过孔的 704 个铜几何对象也逐项一致。R3 强制冻结的是 J1/FPC、显示高压/电荷泵和面板侧扇出；R3 **允许且必须**改造 J2/J3、`/3V3 -> /EPD_SW_3V3` 语义，以及七根数字网在 J2 侧的接口尾段。
2. **当前 B3 PCB 仅是 `B3-WROOM-POWER-TF-R2-PLACED` 布局候选，不是 R3 可投板版。** 它尚未路由新网络，未与 R3 原理图做 parity，且仍是旧 `U6/U7 SN74LVC125APWR` 候选，而非 R3 冻结的单颗 `U6 SN74CB3Q3245PWR`。
3. **72 × 105 mm 只适合紧凑试排；R3 首选评审包络为 80 × 125 mm。** 扩大版面不改变 B2 坐标，但可同时给 WROOM 天线净空、TF 插卡行程、USB-C/电池/按键边缘操作、手焊返修和新增 H3/H4 留出可审计空间。72 × 105 mm 可保留为对比候选，但不能在天线、插卡和返修门未通过时冻结。
4. **B2 与 B3 的边界应是网表可追溯的电源/数字接口，不是任意铜线搭接。** `TPS22950 -> EPD_SW_3V3 -> B2 TP1/R4/R8 -> EPD_3V3/V_B`；七根 EPD 数字线经单颗 U6 掉电隔离，在本文列出的 J2 尾段锚点重连到面板侧保护铜图。

## 2. 证据基线与坐标约定

坐标单位为 mm，为 KiCad PCB 文件内的板本地坐标；角度是 KiCad 封装角度；`F`/`B` 表示顶面/底面。名义板框以 `Edge.Cuts` 中心线为准，不将 0.05 mm 画线半宽计入成品外形。

| 对象 | 路径/修订 | SHA-256 / 状态 |
|---|---|---|
| 冻结 B2 PCB | `hardware/mf1750_devkitc_b2_pcba_margin/mf1750_devkitc_b2_pcba_margin.kicad_pcb` | `462e127279bacc894eab5e8cc242cd6d26e1d3ee87708ad398f8064b5a5c4238` |
| 当前 B3 PCB | `hardware/mf1750_wroom_b3_power_tf/mf1750_wroom_b3_power_tf.kicad_pcb` | `6da0e247e50ba4ce9ea984d6f0da72d98c1ac31544bf1aecbbb449bf3707e3a7` |
| 当前 B3 原理图 | `hardware/mf1750_wroom_b3_power_tf/mf1750_wroom_b3_power_tf.kicad_sch` | `158e54c1b8e0301860239bd69d837215caf2a9f5d5a34687a32fee922b310bf0`；ERC 0，契约 246/246，176 器件/175 网络/552 引脚节点，B2 继承 655/655 |
| B2 验证 | `verification_manifest.json` / `board_audit.json` / `drc_final.rpt` | ERC 0 错误/0 警告，DRC 0，未连接 0，项目审计 PASS |
| B3 现状说明 | `hardware/mf1750_wroom_b3_power_tf/placement_audit.json` | `PLACED_CANDIDATE_NOT_ROUTED_NOT_SCHEMATIC_PARITY` |
| B3 当前只读 DRC | `hardware/mf1750_wroom_b3_power_tf/drc_current_readonly.rpt` | 49 项违规，0 未连接，0 封装错误；**FAIL** |

`0 未连接` 不能解读为 B3 已路由：当前 PCB 本身尚未捕获 R3 新网表，因此新电源树和新信号根本不在该未连接统计中。

## 3. B2 显示驱动保护核与 R3 接口改造窗口

### 3.1 板框、层叠与不可变边界

- B2 名义板框：`x=0..65.0` × `y=0..60.5`，65.0 × 60.5 mm。
- B3 必须保留 J1/FPC、高压/电荷泵、面板侧扇出、R4/R8 屏端分配、R15/R16 装配状态和本文保护锚点之后的铜图。J2 连通性改造、J3 移除、`/3V3` 网名语义迁移和七根线的 J2 尾段是显式例外，不受“全区哈希必须相等”约束。
- B2 经验证的四层基线：`JLC04161H-7628`、1.6 mm、ENIG 1 µin；L1 F.Cu 1 oz / 0.2104 mm prepreg / L2 In1.Cu 0.5 oz 完整 GND / 1.065 mm core / L3 In2.Cu 0.5 oz 电源 / 0.2104 mm prepreg / L4 B.Cu 1 oz。
- B2 普通通孔过孔为 0.30 mm 孔 / 0.60 mm 盘。这是 B2 已验证基线，不等于 B3 USB 差分阻抗已经获得厂商承认。
- B2 共有 8 个 zone；其中 F/B/In1 的 GND 铜区在 B2 内部包络约为 `x=0.65..64.35, y=0.65..59.85`。R3 可以在 B2 外新建/分段铜区；在 B2 保护核内，zone 的层、净距和电气覆盖必须保持，但比较前应先把 B2 `/3V3` 规范化别名为 R3 `/EPD_SW_3V3`。
- B2 旧 DevKitC `J2` 封装坐标为 `(6,58.5) / 90°`，其几何/Courtyard 大约占 `x=-1.07..68.86, y=32.59..61.55`。R3 保留该物理封装与坐标作 DNP 调试位，但其 7 个面板信号脚必须改到 `MCU_*` 侧，不得再直连面板网。`J3` 在 R3 中必须移除，其两段入口支线列入明确豁免。

### 3.2 必须保留的 B2 器件坐标和朝向

| Ref | X | Y | 角度 | 面/备注 |
|---|---:|---:|---:|---|
| C0 | 4 | 31 | -90° | F |
| C1 | 42 | 24.5 | 0° | F |
| C2 | 23 | 31.5 | 0° | F |
| C3 | 27.5 | 46.5 | 0° | F |
| C4 | 5.5 | 40.5 | 0° | F |
| C5 | 22 | 40.5 | 0° | F |
| C6 | 60 | 31.5 | 90° | F |
| C7 | 18.5 | 17 | -90° | F |
| C8 | 22.5 | 17 | -90° | F |
| C9 | 26.5 | 17 | -90° | F |
| C10 | 30.5 | 17 | -90° | F |
| C11 | 34.5 | 17 | -90° | F |
| C12 | 38.5 | 17 | -90° | F |
| C13 | 6 | 16.5 | -90° | F |
| C14 | 10.5 | 16.5 | -90° | F |
| C15 | 59 | 18.5 | -90° | F |
| C16 | 57.5 | 24 | 0° | F |
| C17 | 53.5 | 24 | 0° | F |
| C18 | 49.5 | 24.5 | 0° | F |
| C19 | 45.5 | 24 | 0° | F |
| C20 | 46.5 | 16.5 | -90° | F |
| C21 | 43 | 16.5 | -90° | F |
| C22 | 34.5 | 31.7 | 180° | F |
| C23 | 13.5 | 46.5 | 0° | F |
| D1 | 17.3 | 31.7 | 180° | F |
| D2 | 11 | 40.5 | 180° | F |
| D3 | 16.5 | 40.5 | 0° | F |
| D4 | 54 | 31.7 | 0° | F |
| H1 | 4 | 6 | 0° | 机械，保留 |
| H2 | 59 | 6 | 0° | 机械，保留 |
| J1 | 31.5 | 7.5 | 180° | FPC，保留出线/Z 包络 |
| J2 | 6 | 58.5 | 90° | 物理几何保留、DNP；指定脚网络必须改为 MCU 侧 |
| J3 | 12 | 4.3 | 180° | **R3 必须移除**；此行仅记录 B2/R2 事实坐标 |
| L1 | 10 | 30 | 0° | F |
| L2 | 46.5 | 30 | 0° | F |
| Q1 | 17 | 27.5 | 90° | F |
| Q2 | 39.5 | 31 | 0° | F |
| R1 | 21 | 27.5 | 0° | F |
| R2 | 14.5 | 16.5 | -90° | F |
| R3 | 57.5 | 27.5 | 0° | F |
| R4 | 4.5 | 46.5 | 0° | F，R3 的 EPD 电源交界点之一 |
| R5 | 27.5 | 31.5 | 90° | F |
| R6 | 19 | 46.5 | 0° | F |
| R7 | 23 | 46.5 | 0° | F |
| R8 | 8.5 | 46.5 | 0° | F，R3 的 EPD 电源交界点之一 |
| R9 | 43 | 21 | -90° | F |
| R10 | 46.5 | 21 | -90° | F |
| R12 | 50.5 | 14.5 | 0° | F |
| R13 | 54.5 | 14.5 | 0° | F |
| R15 | 36.5 | 40.5 | 0° | F，DNP |
| R16 | 40.5 | 40.5 | 0° | F，FIT |
| TP1 | 4.5 | 50.5 | 0° | B |
| TP2 | 8.5 | 50.5 | 0° | B |
| TP3 | 25 | 27.5 | 0° | B |
| TP4 | 29 | 27.5 | 0° | B |
| TP5 | 25 | 43.5 | 0° | B |
| TP6 | 60.5 | 22.5 | 0° | B |
| TP7 | 29.5 | 43.5 | 0° | B |
| TP8 | 36.5 | 54 | 0° | B |
| TP9 | 41.5 | 54 | 0° | B |
| TP10 | 52.5 | 54 | 0° | B |

### 3.3 B2/R2 铜路事实基线

下表是 B2 与当前 R2 完整一致的客观记录，不是 R3 应继续保持全量等值的放行条件。去除 UUID 后，629 段走线 + 75 个过孔的几何/网络/层/线宽规范化 SHA-256，B2 与当前 R2 均为：

`976c03e3bb7e43389d65ad2231199bafbb8960c66daeb74a5d6e5583293f99b8`

| 网络 | 线段 | 过孔 | 总走线长 | 线宽 | 层 | 迁移意义 |
|---|---:|---:|---:|---|---|---|
| `/3V3` | 19 | 5 | 120.832 mm | 0.4/0.5/0.6 | F/B/In2 | B2/R2 事实名；R3 规范化为 `/EPD_SW_3V3` |
| `/EPD_3V3` | 9 | 4 | 38.018 mm | 0.4/0.6 | F/In2 | 面板逻辑供电 |
| `/V_B` | 21 | 6 | 82.541 mm | 0.5/0.8 | F/In2 | 显示高压前级供电 |
| `/SW_H` | 12 | 0 | 25.677 mm | 0.2/0.45 | F | 高压开关回路 |
| `/NEG_PUMP_H` | 4 | 0 | 9.007 mm | 0.2/0.4 | F | 负压泵回路 |
| `/VPH` | 14 | 2 | 34.877 mm | 0.2/0.45 | F/B | 高压泵节点 |
| `/SW_C` | 7 | 0 | 13.159 mm | 0.2/0.4 | F | 电荷泵开关节点 |
| `/VPC` | 18 | 2 | 62.282 mm | 0.2/0.45 | F/B | 电荷泵节点 |
| `/RESEH` | 6 | 2 | 22.179 mm | 0.2/0.4 | F/B | 高压基准回路 |
| `/RESEC` | 10 | 2 | 54.021 mm | 0.2/0.4 | F/B | 电荷泵基准回路 |
| `/CP1N` | 6 | 0 | 22.696 mm | 0.2 | F | 电荷泵飞跨网 |
| `/CP1P` | 7 | 0 | 23.556 mm | 0.2 | F | 电荷泵飞跨网 |
| `/CP2N` | 9 | 0 | 20.634 mm | 0.2 | F | 电荷泵飞跨网 |
| `/CP2P` | 11 | 2 | 25.473 mm | 0.2 | F/B | 电荷泵飞跨网 |
| `/VCP1` | 7 | 0 | 21.262 mm | 0.2 | F | 电荷泵储能网 |
| `/VCP2` | 9 | 2 | 23.834 mm | 0.2 | F/B | 电荷泵储能网 |
| `/RST_N` | 24 | 1 | 81.314 mm | 0.2 | F/B | EPD 控制 |
| `/DC` | 25 | 1 | 85.152 mm | 0.2 | F/B | EPD 控制 |
| `/CSB` | 27 | 2 | 117.103 mm | 0.2 | F/B | EPD 控制 |
| `/CS2` | 7 | 0 | 31.337 mm | 0.2 | F | EPD 控制 |
| `/SCL` | 11 | 3 | 119.930 mm | 0.2 | F/B | EPD 控制 |
| `/SI0` | 18 | 3 | 114.287 mm | 0.2 | F/B | EPD 双向数据，不得当作单向线 |
| `/BUSY_N` | 21 | 2 | 126.422 mm | 0.2 | F/B | EPD 状态 |
| `/SL_CSB` | 28 | 3 | 104.808 mm | 0.2 | F/B | EPD 控制 |
| GND | 103 | 9 | 328.114 mm | 0.2 | F/B | 除 J3 直接入口支线外，与 B2 四层回流一起保护 |

路由原则：新增 TPS63070 开关节点、USB D+/D−、TF SPI 和 WROOM 数字扇出都不得穿过 B2 高压/电荷泵簇，也不得切断 L2 上 B2 已验证的连续回流面。

### 3.4 R3 可程序化保护集与豁免集

自动迁移审计必须以源 B2 PCB SHA-256
`462e127279bacc894eab5e8cc242cd6d26e1d3ee87708ad398f8064b5a5c4238`
为唯一基线。UUID 只用来从这个固定源文件剔除接口尾段；对生成后 R3 应比较规范化几何元组，不要求新文件沿用旧 UUID。

```text
SOURCE_B2_SHA256 = 462e127279bacc894eab5e8cc242cd6d26e1d3ee87708ad398f8064b5a5c4238

# 物理封装坐标/面/角度/封装名必须相同；J2 包含在内。
FOOTPRINT_GEOMETRY_REQUIRED = B2_ALL_REFS - {J3}

# J3 必须从 R3 移除。
FOOTPRINT_REQUIRED_ABSENT = {J3}

# J2 只豁免下列脚的网络属性，不豁免物理几何。
J2_PAD_NET_EXEMPT = {4, 5, 6, 7, 16, 17, 18}

# 比较铜几何前的语义别名。
NET_ALIAS = {/3V3: /EPD_SW_3V3, /GND: GND}

# 源 B2 中允许删除/改造的铜对象；其余旧 track/via 必须作为 R3 子集保留。
TRACK_UUID_EXEMPT = {
  4d1417b9-2610-4ea8-9606-e6195d1b5abf,
  c7ac9ba3-f6f4-46d4-935c-e214f9bccdbc,
  5efd92a2-34d2-494e-8c59-2932a0ddd77d,
  0340befd-a85d-4e52-b8ef-655f1d3f1177,
  928a5728-d641-42f7-b774-6d21012d5bbb,
  afa163df-7a84-4853-b0c1-b422f06590a5,
  32be88ed-7f34-4043-9dce-4fdbcc086e2a,
  062cf581-1873-4721-a329-56c85f3ec102,
  15478d8c-6cc5-453b-85eb-5549480f929b,
  97f80bfc-b49e-4a41-a1d7-24d5ca5f256c,
  40f189e3-83b2-4816-9a92-7f26f31c232e
}
VIA_UUID_EXEMPT = {}
```

J2 必须保留 DNP 封装几何，但指定脚的 R3 网名必须改为：

| J2 pad | B2/R2 网 | R3 必须网 |
|---:|---|---|
| 4 | `/BUSY_N` | `/MCU_BUSY_N` |
| 5 | `/RST_N` | `/MCU_RST_N` |
| 6 | `/DC` | `/MCU_DC` |
| 7 | `/CSB` | `/MCU_CSB` |
| 16 | `/CS2` | `/MCU_CS2` |
| 17 | `/SI0` | `/MCU_SI0` |
| 18 | `/SCL` | `/MCU_SCL` |

下表将豁免 UUID 绑定到源 B2 实际几何，并定义豁免尾段之后的**保护锚点**。R3 必须将每组锚点重连到 U6 同一面板侧通道；如一个网有两个锚点，两者都必须保持同网导通。

| 接口 | 源网 | 豁免 track UUID | 保护锚点（X,Y,层） |
|---|---|---|---|
| J2 pad 4 | `/BUSY_N` | `4d1417b9-2610-4ea8-9606-e6195d1b5abf` | `(17.8336,54.2864,F.Cu)` |
| J2 pad 4 | `/BUSY_N` | `c7ac9ba3-f6f4-46d4-935c-e214f9bccdbc` | `(6.4932,51.3732,B.Cu)` |
| J2 pad 5 | `/RST_N` | `5efd92a2-34d2-494e-8c59-2932a0ddd77d` | `(10.0862,52.4262,B.Cu)` |
| J2 pad 6 | `/DC` | `0340befd-a85d-4e52-b8ef-655f1d3f1177` | `(12.2199,52.0199,B.Cu)` |
| J2 pad 7 | `/CSB` | `928a5728-d641-42f7-b774-6d21012d5bbb` | `(25.74,54.0,B.Cu)` |
| J2 pad 7 | `/CSB` | `afa163df-7a84-4853-b0c1-b422f06590a5` | `(14.3169,51.5769,B.Cu)` |
| J2 pad 16 | `/CS2` | `32be88ed-7f34-4043-9dce-4fdbcc086e2a` | `(45.012,57.588,F.Cu)` |
| J2 pad 17 | `/SI0` | `062cf581-1873-4721-a329-56c85f3ec102` | `(43.2101,55.0701,B.Cu)` |
| J2 pad 18 | `/SCL` | `15478d8c-6cc5-453b-85eb-5549480f929b` | `(43.9517,53.2717,B.Cu)` |
| J3 pad 1 | `/3V3` | `97f80bfc-b49e-4a41-a1d7-24d5ca5f256c` | `(12.0,10.5,In2.Cu)`；J3 移除后不再对外连接 |
| J3 pad 2 | GND | `40f189e3-83b2-4816-9a92-7f26f31c232e` | `(9.0983,4.3,F.Cu)`；J3 移除后不再对外连接 |

电源方面，B2 `/3V3` 的保护铜图在别名为 `/EPD_SW_3V3` 后必须保留；U5 的新输出优先接到现有 `TP1 pad 1 @ (4.5,50.5)`，然后继续经已验证铜图到 R4/R8。如布局人选择另一个现有 `/EPD_SW_3V3` 盘作入口，必须在检查器配置中显式更新，不得用区域级宽泛豁免代替。

比较算法应是“保护源对象集是 R3 的子集”，而不是“B2 与 R3 整板完全相等”：

1. 验证源 B2 SHA；
2. 将 `/3V3` 映射为 `/EPD_SW_3V3`，并将 B2 局部 `/GND` 映射为 R3 全局 `GND`；
3. 从源集中剔除 `J3`、J2 指定脚的 pad-net 属性和 11 个豁免 track UUID；
4. 对剩余源封装和 track/via/zone 生成不含 UUID 的几何元组，要求全部出现在 R3；
5. 单独断言 J3 不存在、J2 七脚网名如上、U6 七个面板侧通道各与对应锚点导通，以及 U5 输出与 `/EPD_SW_3V3` 保护铜图导通；
6. 新增 R3 铜可以存在，但进入 `x=0..65, y=0..60.5` 时只能是到上述明确锚点/J2 MCU 脚/电源入口的接口连线；其他新增铜立即报错并要求人工审批。

## 4. 当前 B3 R2 候选的客观现状

### 4.1 板框与新器件当前位置

- 名义板框：72 × 105 mm，4 层。
- B2 区 `x=0..65, y=0..60.5` 位置不变。
- 新增位置只是视觉/机械候选，未经新网表、电气回路、热或可制造性门。

| Ref | 当前中心/角度 | 当前几何事实 | R3 判定 |
|---|---|---|---|
| U1 WROOM | `(58,81), -90°` | F.Fab 主体约 `x=45.2..70.8, y=71.95..90.05`；嵌入式全铜层禁布区约 `x=64.75..85.75, y=57..105` | 禁布区与当前 GND 铜箔冲突；未冻结 |
| U2 BQ24074 | `(11,65.5), 0°` | Courtyard 约 `x=8.845..13.155, y=63.345..67.655` | 须按 USB/电池电流路径重排 |
| U3 STM6600 | `(20,65.5), 0°` | Courtyard 约 `x=18.575..21.425, y=63.725..67.275` | 与电源键、BQ 相互位置待冻结 |
| U5 TPS22950 | `(35,66), 0°` | Courtyard 约 `x=32.925..37.075, y=64.275..67.725` | 建议移近 B2 R4/R8 交界 |
| U6/U7 125 | `(11.5,77)` / `(25,77)` | 两颗旧候选 | R3 已被单颗 U6 `SN74CB3Q3245PWR` 取代，不可照此路由 |
| J4 microSD | `(30,98.5), 180°` | 主体约 `x=23.955..36.005, y=92.75..108.25`，卡口朝下边缘 | 功能朝向正确，需保留外部插卡包络 |
| J5 USB-C | `(5.2,88), 90°` | Courtyard 约 `x=-0.095..9.375, y=82.655..93.345` | 左边可达性正确，但封装与边距须修正 |
| J6 电池 | `(14,97), 180°` | 当前是竖直候选，与 H3 Courtyard 仅约 0.75 mm | R3 已转为暂定侧插 JST `S3B-PH-KL`；当前封装非权威 |
| H3/H4 | `(4,101)` / `(51,101)` | 当前底边安装孔候选 | 需随板框/外壳重新对称定位 |

### 4.2 当前 DRC 阻断

`drc_current_readonly.rpt` 含 49 项：16 项铜到板边、12 项钻孔范围、8 项文字高度、4 项铜间距、4 项阻焊桥、3 项禁布区和 2 项丝印到板边。关键问题是：

- 3 个 GND 区域进入 WROOM 天线封装自带的全铜层禁布区；
- USB-C 重叠 A/B 脚尚无网络，导致间距/阻焊桥报错；
- USB-C 多个盘仅约 0.43 mm 距板边，低于当前 0.50 mm 规则；
- WROOM 热盘 41 的 0.20 mm 钻孔低于当前 0.30 mm 最小孔规则。

上述任一点未解决时，B3 都不是可提交嘉立创的板。

## 5. R3 建议板框与功能分区

### 5.1 72 × 105 mm 与 80 × 125 mm 对比

| 项目 | 72 × 105 mm 当前候选 | 80 × 125 mm 宽松候选 |
|---|---|---|
| B2 保护核 | 可保留 J1/高压/电荷泵/面板扇出，同时实施接口豁免 | 同左；额外空间不改变 J2/J3 与 U6/U5 的必要迁移语义 |
| WROOM 天线 | 当前禁布框约到 `x=85.75`，与 72 mm 宽板/铺铜冲突；需明确超出板边或板内无铜实现 | 按 `rot=270°, origin≈(52,90)` 的初排，封装天线禁布约 `x=58.75..79.75, y=66..114`，可在板内完整建立规则区 |
| TF 下边插卡 | 与安装孔/电池/手指行程拥挤 | 可独立保留插卡、拔卡和热风返修包络 |
| USB-C/电源键/电池 | 均需边缘资源，当前 J6-H3 已过紧 | 可将接口分离到左/下边，避免操作与线束冲突 |
| 手焊/返修 | QFN/TDFN/电感/屏蔽罩通道紧张 | 有条件满足人工焊接和探测间距 |
| 新增 H3/H4 | 当前不对称，H3 与 J6 间隙不足 | 可在下方新增区对称配置；初始中心可评审 `(5,120)` / `(75,120)` |

**R3 建议：先用 80 × 125 mm 完成电气、RF、连接器可达性和手焊冻结，不在尚未闭环前压缩回 72 × 105 mm。** H3/H4 的建议坐标只是 80 × 125 mm 的机械起点，必须以外壳、螺柱、TF 卡和连接器实物包络二次审批。H1/H2/J1 仍保留 B2 坐标不动。

### 5.2 建议功能分区

| 分区 | 建议包络/位置 | 器件 | 不可妥协的路由原则 |
|---|---|---|---|
| A. B2 保护显示核 | `x=0..65, y=0..60.5` | J1/FPC、高压/电荷泵、面板扇出、保护 TP/锚点 | 除第 3.4 节程序化豁免外，不移件、不改层/线宽/过孔/几何；J3 必须移除，J2 七脚必须迁到 MCU 侧，`/3V3` 必须映射为 `/EPD_SW_3V3` |
| B. EPD 电源/数字交界 | 紧贴 B2 下边界，约 `y=61..72` | U5 TPS22950、U6 SN74CB3Q3245、Q3、/OE 上拉/下拉、去耦 | U5 优先经 TP1 接入保护电源铜图；U6 面板侧逐网重连第 3.4 节锚点，MCU 侧连 WROOM 与 J2 DNP 脚；七线同时掉电隔离，SI0/SDA 保留双向能力 |
| C. PowerPath | 左/中部新增区，USB-C 与电池入口之间 | U2 BQ24074、U3 STM6600、电源键、J6 | VBUS-BQ 和 BAT-BQ 短/宽；STM 的按键/保持网远离 TPS63070 SW；接口侧向可达 |
| D. 3.3 V 开关电源岛 | 中部新增区，不贴天线/USB/EPD 高压区 | U4 TPS63070、XFL4020 1.5 µH、VIN/VOUT 电容、FB | VIN-U4-SW-L-VOUT-GND 最小环路；SW 铜面积仅满足数据手册；FB 取样远离 SW/电感；就近多过孔回 L2 GND |
| E. USB-C 与差分通道 | 左边缘约 J5 当前高度，向 WROOM 直达 | J5、ESD、CC Rd、22 Ω | D+/D− 等长并行、90 Ω ±10%，L2 连续 GND；不跨分割/孔缝；必须换层时成对过孔且旁边加 GND 回流过孔 |
| F. TF 卡 | 下边缘，卡口向外、卡片从下边向板内插入 | J4、SPI 串阻/上拉、去耦 | SPI 短且共用连续 GND 参考；不穿天线禁布；留足卡片插拔、手指和屏蔽罩返修包络 |
| G. WROOM/RF | 右边/下方新增区 | U1、EN/BOOT 维修点、去耦 | 天线优先伸出基板边缘；否则按 Espressif 要求建立全层无铜/无走线/无器件净空，并进行整机 RF 实测 |
| H. 边缘人机/机械 | 左/下边，避开 TF 口与天线 | SW1 电源、SW2/SW3 用户键、J6、H3/H4 | 按键推杆和插头出板方向在 F.Fab/Edge.Cuts 画实际操作包络，不只看 Courtyard |

## 6. 专项审计要求

### 6.1 ESP32-S3-WROOM-1 天线

Espressif 官方 PCB 布局指南要求模组天线尽量伸出基板边缘；无法伸出时，天线周边至少 15 mm 不应有铜、走线或器件，并需经过整机吞吐/距离验证。本项目执行门如下：

- 天线禁布必须同时禁止 F.Cu/In1.Cu/In2.Cu/B.Cu 铜箔、走线、过孔、焊盘和器件；重铺后重新 DRC，不能用排除掩盖。
- 不得用覆盖整板的矩形 GND zone 轮廓穿过 WROOM 封装天线 keepout；否则即使期望填充被自动挖空，KiCad 仍会对 zone 对象报 `items_not_allowed`。最终 F.Cu/In1.Cu/In2.Cu/B.Cu 铜区必须在右侧建立明确缺口，或拆成与 keepout 边界一致的分段多边形，再重铺和 DRC。
- 禁止电池、FPC、屏蔽罩、螺钉/铜柱、外壳金属化层和线束进入天线三维净空。
- 80 × 125 mm 候选中，`U1≈(52,90), rot=270°` 是一个可进入摆放/外壳联合评审的起点，不是冻结坐标。如采用天线越边方案，还需将模组信号盘全部留在板内，并检查拼板边条、铣刀和 SMT 支撑。

### 6.2 TF 卡下边向外

- 当前 J4 `(30,98.5), 180°` 的卡口朝下边缘，功能朝向可保留。
- 在 80 × 125 mm 版本中应将 J4 放到最终下边缘，卡座触点在板内，卡片/指甲/屏蔽罩在板外的全行程不与 H3/H4、J6、SW2/SW3 冲突。
- 需用实物确认插卡方向、卡检测开关常态极性和焊接盘视野；只看顶视封装不足以放行。

### 6.3 USB-C、电源键、电池接口

- USB-C 应固定在外壳可达边缘；当前左边方向可作为起点，但必须先解决重复脚网络、阻焊桥和 0.43/0.50 mm 边距冲突。
- SW1 电源键靠近 STM6600 功能区，但以推杆在外壳孔内的真实行程冻结；SW2/SW3 与 SW1 留出手指识别间距。
- J6 必须侧向可插拔，避开 USB-C 线缆、按键推杆、H3/H4 螺柱和 TF 卡行程。电池红/黑/温度线顺、板端 MPN 和配套线束尚未解除 HOLD。

### 6.4 BQ24074 / STM6600 / TPS63070 / TPS22950

- **BQ24074**：VBUS 去耦、BAT 去耦、PowerPath 节点和热盘过孔围绕 U2 就近布置；USB 入口大电流不与 D+/D− 共用细颈回流。
- **STM6600**：放在 U2 与电源键之间；`EN_SYS` 进 TPS63070 EN 要短，但不贴 TPS63070 SW/电感。
- **TPS63070**：U4、XFL4020-152MEC、输入 bulk `C31-C33`、输出 bulk `C34-C37`、FB 分压必须按 TI 布局顺序形成一个紧凑岛。`C46=10 µF/0603` 必须尽量贴近 VIN-GND，`C47=10 µF/0603` 必须尽量贴近 VOUT-GND；`R29=10 kΩ` 串接 VIN 到 PS/SYNC。不为“手焊间距”拉长开关热环路；手焊空间留在岛外。
- **TPS22950**：贴近 B2 `R4/R8` 交界，`IN/GND/CIN`、`OUT/COUT`、`RILIM`均就近；`EPD_SW_3V3` 到 B2 的高电流路径短/宽，`FLT/ON` 远离开关节点。
- PowerPath 区、TPS63070 岛和 B2 高压泵区之间应靠功能分区和连续 GND 回流隔离，不用切碎 L2 GND 的方式“隔离”。

### 6.5 U6 掉电隔离与 B2 数字边界

- R3 仅装单颗 `SN74CB3Q3245PWR`；当前 PCB 中的两颗 `SN74LVC125APWR` 不应继续路由。
- U6 `VCC=EPD_3V3`，`/OE` 用上拉确保掉电/启动默认关断，再由 Q3 拉低使能；Q3 和上拉/去耦贴 U6 布置。
- 七路对应 `MCU_RST_N/RST_N`、`MCU_DC/DC`、`MCU_CSB/CSB`、`MCU_CS2/CS2`、`MCU_SCL/SCL`、`MCU_SI0/SI0`、`MCU_BUSY_N/BUSY_N`。`SI0` 已确认为双向，必须经双向 bus switch，不得回退到单向 125。
- U6 放在第 3.4 节面板侧保护锚点与 WROOM 之间；J2 指定脚只接 `MCU_*` 侧，J3 不装且不留连接器封装。EPD 侧支线不应绕经 TPS63070 SW 岛或 USB 差分通道。

## 7. 手焊、返修与装配间距

以下是本项目的 R3 建议目标，不是元器件厂商或嘉立创的自动放行声明：

- 普通 0603/小 IC Courtyard 之间目标至少 1.0 mm；QFN/TDFN/TSSOP 返修侧优选 1.5 mm。
- TPS63070/电感热风区外围留约 2.0 mm 工具通道；但 U4-电感-电容的热环路仍按数据手册最紧凑。
- USB-C、J6、TF 卡座、侧按键和安装孔周边目标至少 3.0 mm 工具/手指空间，另加各自的插拔/线缆/卡片/推杆包络。
- 底面尽量不放器件，保持 L2 连续 GND；仅在能明确返流、机械和装配面的前提下放底面测试点/必需小件。
- 每个连接器必须同时审查 F.Fab 本体、Courtyard、配对件、线缆/卡片行程和 Z 高度，不能只审焊盘。

## 8. 建议的 R3 布局实施顺序

1. 在 80 × 125 mm 候选上以 B2 SHA 构建第 3.4 节的“保护子集 + 显式豁免”检查器：保留除 J3 外的 B2 封装几何，仅豁免 J2 七脚网名和 11 个接口 track UUID，并要求所有 75 个旧过孔继续出现。
2. 先放板边件：TF 下边朝外、USB-C、J6、SW1/SW2/SW3、H3/H4；用外壳/线束/卡片实体包络锁定。
3. 放 WROOM 并首先锁定天线全层禁布和三维金属净空；然后锁定 USB D+/D− 直达通道。
4. 放 BQ24074/STM6600，锁定 USB/电池 PowerPath；再放 TPS63070 完整热环路岛。
5. 在 B2 边界放 TPS22950 与单颗 U6/Q3，以 U5→TP1、U6 面板侧→保护锚点、U6 MCU 侧→WROOM/J2 DNP 七脚的方式完成迁移；移除 J3 及其两段豁免支线。
6. 路由优先级：TPS63070/BQ 热回路 → USB D+/D− → EPD 受控电源 → U6 七线 → TF SPI → 低速控制。
7. 重铺四层后执行 schematic-to-PCB parity、ERC、DRC、零未连接、天线禁布、USB 阻抗、连接器边距和封装渲染门。
8. 最后才评估能否从 80 × 125 mm 压缩；压缩不得改变 B2 冻结坐标或破坏上述功能通道。

## 9. 未解除 HOLD

1. **R3 原理图/PCB parity 与接口迁移 HOLD**：当前 B3 PCB 不包含已冻结的完整 R3 电源树和单颗 U6 架构；J2 七脚还未迁到 MCU 侧，J3 还未移除，`/3V3 -> /EPD_SW_3V3` 还未实施，U4/按键也未按 R3 完整同步。
2. **WROOM RF/机械 HOLD**：天线超出板边还是板内净空尚未冻结；外壳、电池、FPC、螺柱和拼板支撑未做三维验证。
3. **板框 HOLD**：72 × 105 mm 当前候选过紧；80 × 125 mm 是本审计建议的 R3 宽松起点，仍需外壳确认。
4. **USB-C HOLD**：重复 A/B 脚网络、阻焊桥、铜到板边与 90 Ω ±10% 差分阻抗均未闭环。当前层叠没有“已控阻”证据。
5. **WROOM 热盘孔径 HOLD**：封装 0.20 mm 钻孔与当前 0.30 mm 板规则冲突；需根据 Espressif 推荐、嘉立创当次工艺和钢网/填孔方案明确决策。
6. **J6 电池接口 HOLD**：暂定 `JST S3B-PH-KL / C20089271`，但板端与线端 MPN、针脚线序、锁扣方向、线束和电池保护均未确认；当前 PCB J6 不可直接沿用。
7. **按键/外壳 HOLD**：Alps 器件电气封装已有本地核对工作，但 SW1/SW2/SW3 在外壳上的最终位置与推杆行程未冻结。
8. **TPS63070 版图 HOLD**：R29/C46/C47 原理图合同已按 TI Rev.B §11.1 关闭；但 C46/C47 相对 U4 VIN/VOUT/GND 的紧贴位置、RNM0015A 封装、XFL4020 电感、热盘和热环路仍未在重新同步的完整 R3 PCB 中经 DRC/渲染验证。
9. **TF 机械 HOLD**：真实卡座、卡片、指甲、外壳开口和 card-detect 常态逻辑未做实物复核。
10. **B2 旧机械 HOLD 延续**：J1/FPC 出线与整机外壳首件仍需实物评审。J3 已定义为移除，不再保留侧插线束 HOLD；J2 量产 DNP 时不需要插座 Z 包络放行，但若仍要支持可选 DevKitC 调试装配，则须单独恢复其孔径/Z 包络审查。

## 10. 放行条件

只有同时满足以下条件，才可将后续 PCB 标记为 R3 路由/制造候选：

- 第 3.4 节保护子集比较 PASS：除 J3 外的 B2 封装几何保留，11 个豁免 track 外的旧铜几何全部保留，75 个旧过孔保留，`/3V3` 按别名与 `/EPD_SW_3V3` 比较；704 铜对象整体 SHA 只作 B2/R2 事实证据，**不再要求 R3 相等**；
- J3 已移除，J2 物理几何保留且七脚均为规定 `MCU_*` 网，U6 面板侧对应锚点导通，U5 输出与 `/EPD_SW_3V3` 保护铜图导通；
- R3 原理图与 PCB 网表 parity 零差异；
- ERC/DRC/未连接全部为零，且未用排除隐藏天线、USB、孔径或边距问题；
- TPS63070、BQ24074、TPS22950 的官方布局检查表逐项通过；
- WROOM 天线禁布的四铜层视觉审查和整机金属包络通过；
- USB-C、TF、J6、SW1/SW2/SW3、H3/H4、J1/FPC 通过 2D/3D 机械可达性复核；
- 以最终嘉立创层叠重新计算/设定 USB 90 Ω ±10% 走线，并完成订单页在线设置复核。

## 11. 权威来源与本地证据

- Espressif [ESP32-S3 Hardware Design Guidelines: PCB Layout Design](https://docs.espressif.com/projects/esp-hardware-design-guidelines/en/latest/esp32s3/pcb-layout-design.html)：四层建议、L2 完整 GND、模组天线越边/净空、USB 差分布线原则。
- Espressif [ESP32-S3-WROOM-1/1U Datasheet](https://www.espressif.com/sites/default/files/documentation/esp32-s3-wroom-1_wroom-1u_datasheet_en.pdf)：模组尺寸、推荐陆地图和天线区。
- TI [TPS63070 Datasheet](https://www.ti.com/lit/ds/symlink/tps63070.pdf)：RNM 封装、功率级布局和开关热环路。
- TI [TPS22950-Q1 Datasheet](https://www.ti.com/lit/ds/symlink/tps22950-q1.pdf)：IN/OUT/ILIM/热盘布局。
- TI [SN74CB3Q3245 Datasheet](https://www.ti.com/lit/ds/symlink/sn74cb3q3245.pdf)：PW/TSSOP-20 引脚和 Ioff 掉电隔离能力。
- 本地 R3 器件冻结：`docs/MF1750_WROOM_B3_COMPONENT_FREEZE_2026-08-24.md`。
- 本地 R3 约束台账：`docs/MF1750_WROOM_B3_R3_CONSTRAINT_LEDGER_2026-08-24.md`。
- B2 审计证据：`hardware/mf1750_devkitc_b2_pcba_margin/verification_manifest.json`、`board_audit.json`、`drc_final.rpt`。
- B3 现状证据：`hardware/mf1750_wroom_b3_power_tf/placement_audit.json`、`drc_current_readonly.rpt`、`preview/placement_top.png`、`preview/placement_bottom.png`。

---

**最终判定：** B2/R2 的 61 封装和 704 铜对象完全一致，是迁移起点的有力证据，但不是 R3 全量冻结门。R3 不可变核是 J1/FPC、高压/电荷泵、面板侧扇出和豁免尾段之后的保护铜图；J2 七脚迁到 MCU 侧、J3 移除、`/3V3 -> /EPD_SW_3V3` 以及 U6/U5 锚点重连是必做改造。当前 B3 R2 PCB 仅能用于摆放参考；R3 应从 80 × 125 mm 四层宽松包络开始布局，闭环保护子集、R3 parity、WROOM 天线、USB 90 Ω、电源热环路、TF/连接器/按键机械包络和所有 DRC HOLD 后，再评估尺寸压缩与嘉立创首板交付。
