oceanye/ESP32_C73-MF1750/docs/REV_B_MINI_L1_L2_DOWNSIZING_ASSESSMENT_2026-08-05.md

# Rev B-mini：L1/L2 与相关功率器件小型化初步评估

文档日期：2026-08-05

结论状态：只读评估已记录；候选料未冻结；未开始 Rev B 原理图或 PCB 设计

适用对象：MF-1750 Rev A1 高压驱动及后续 Rev B-mini

评估源码基线：`3dfd477`

Hardware tested in this assessment: `NO`

ESP32、TF 卡、共用 3.3 V 和整板电源架构的主记录见
[`H1_REV_B_MINI_COMPONENT_ASSESSMENT_2026-08-05.md`](H1_REV_B_MINI_COMPONENT_ASSESSMENT_2026-08-05.md)。
本文件作为 L1/L2 和相关功率器件的详细附录。

## 1. 决策摘要

L1、L2 具备明显缩小的技术可能。面板参考电路只要求二者为
`15 µH; 2 A`，没有指定 7 mm 封装；当前 Rev A1 使用的
`SMMS0650-150M` 为 `7.1 × 6.6 mm` 级封装，存在缩小空间。

当前推荐边界为：

- Rev B-mini 第一轮优先评估高性能 5030 级、`15 µH`、磁屏蔽电感；
- `4 × 4 mm` 级只作为取得 L1/L2 峰值和 RMS 电流后的面积优先实验方案；
- 不通过降低到 `10 µH` 换取尺寸；
- L1 与 L2 分别按各自最坏波形评估，不因 Rev A1 共用一个料号而假定应力相同；
- 当前结论不是生产替换批准，也不授权修改冻结的 Rev A1 BOM、Gerber 或 PCB；
- 不建议用重叠“万能双封装”牺牲开关环路，候选应采用独立 PCB 变体验证。

正式候选顺序：

1. Würth `7843845030150`：第一候选；
2. Coilcraft `XGL5030-153MEC`：强二供和共同首轮样品；
3. Coilcraft `XGL4040-153MEC`：面积优先实验；
4. Würth `74438356150`：超薄激进实验，不作为当前定版料。

## 2. 当前硬件直接证据

### 2.1 当前器件与封装

Rev A1 生产 BOM 中 L1、L2 均为：

```text
SXN SMMS0650-150M
15 µH / 3.1 A
LCSC C149585
```

证据：

- [`BOM_mf1750_revA1_Q1FIX.csv`](../hardware/mf1750_production_v1/production/BOM_mf1750_revA1_Q1FIX.csv)；
- [`SXN_SMMS0650_7.1x6.6mm.kicad_mod`](../hardware/mf1750_production_v1/MF1750_Production.pretty/SXN_SMMS0650_7.1x6.6mm.kicad_mod)。

当前 footprint 的 Fab 本体为 `7.10 × 6.60 mm`，courtyard 约
`8.90 × 7.30 mm`。仓库没有 SXN 官方规格书，因此下列项目仍未由一手资料确认：

- `3.1 A` 是按温升定义的 Irms，还是按某个降感百分比定义的 Isat；
- DCR 最大值和热态 DCR；
- 10%、20%、30% 降感对应的饱和电流；
- 精确高度、SRF、工作电压和开关频率下的磁芯损耗。

第三方采购元数据可作为样品比较线索，但不得代替正式料号承认书。

### 2.2 面板参考要求

[MF-1750 规格书第 10 页](<../参考资料/MF-1750..1).pdf>)把 L1、L2
统一列为：

```text
15 µH; 2 A
```

该资料没有给出封装、DCR、Isat/Irms 定义、容差或开关频率。因此可以推出
“7 mm 封装不是已知硬要求”，但不能推出“任意标有 2 A 的 15 µH 电感都等效”。

### 2.3 L1、L2 的作用不同

当前拓扑见 [`generate_mf1750_production_v1.py`](../hardware/generate_mf1750_production_v1.py)：

- L1 位于 `V_B → L1 → SW_H`，同时参与 VPH/PREVGH 正高压和 PREVGL
  负压泵的建立；
- L2 位于 SW_C/RESEC 支路，服务独立 VPC 负压泵；
- R1=`0.20 Ω`、R3=`0.22 Ω` 是两条支路的电流检测/控制路径。

所以 L1 暂按更保守方案处理；L2 可能更适合先做小封装 A/B 样，但必须由实测
波形证明。最终也允许两者使用不同尺寸和料号。

### 2.4 当前实测缺口

现有整屏测试只记录 3.3 V/1 A 限流电源保持 CV、L1/L2 温度正常或无明显升温，
见 [`REV_A1_R16_CASCADE_FULLFRAME_TEST_2026-08-04.md`](REV_A1_R16_CASCADE_FULLFRAME_TEST_2026-08-04.md)。

当前没有：

- L1、L2 各自的峰值电流；
- 每个刷新阶段的 RMS 电流；
- 定量最高温度和温升；
- SW_H/SW_C 开关频率、占空比、过冲和振铃；
- VPH、PREVGL、VPC 的定量建立、纹波和释放波形。

输入电源显示 1 A 以下不能证明电感脉冲峰值低于 1 A。

## 3. 官方候选料比较

下表只使用候选厂商官方规格；数值均需结合温度和实际 PCB 降额。

| 等级 | 精确料号 | 本体尺寸 | DCR typ/max | Isat 定义 | 热电流定义 | 结论 |
|---|---|---:|---:|---:|---:|---|
| A1 | [Würth WE-MXGA `7843845030150`](https://www.we-online.com/components/products/datasheet/7843845030150.pdf) | 5.4 × 5.4 × 3.1 mm | 64.5/74.4 mΩ | 1.9 A@降感10%；4.3 A@30% | 4.5 A@ΔT40 K | 第一候选；80 V、磁屏蔽、AEC-Q200 |
| A2 | [Coilcraft `XGL5030-153MEC`](https://www.coilcraft.com/getmedia/e64ac115-95f2-45c7-b798-1b3769b91583/xgl5030.pdf) | 5.48 × 5.28 × 3.1 mm | 68.8/77.1 mΩ | 1.7/2.7/3.6 A@降感10/20/30% | 3.4/4.5 A@ΔT20/40℃ | 强二供；80 V、屏蔽、AEC-Q200 |
| B | [Coilcraft `XGL4040-153MEC`](https://www.coilcraft.com/getmedia/21a95fb2-d27c-4ef3-a232-0b0b8777d20e/xgl4040.pdf) | 约 4.0 × 4.0 × 4.1 mm | 74.5/82.2 mΩ | 1.2/1.9/2.5 A@降感10/20/30% | 2.7/3.6 A@ΔT20/40℃ | 平面面积优先实验；峰流接近 2 A 时可能降感明显 |
| B2 | [Bourns `SRP5030HMT-150M`](https://www.bourns.com/docs/product-datasheets/SRP5030HMT.pdf) | 约 5.6 × 5.2 × 2.8 mm | 90/108 mΩ | 2.6 A typ@降感30% | 4.1 A typ@ΔT40℃ | 低高度条件二供；公开表未给工作电压，使用前需厂商确认 |
| C | [Würth WE-MAPI `74438356150`](https://www.we-online.com/components/products/datasheet/74438356150.pdf) | 4.1 × 4.1 × 2.1 mm | 200/230 mΩ | 1.35 A@降感10%；2.85 A@30% | 2.1 A@ΔT40 K | 超薄实验；DCR 高，仅在测流后评估 |

注意：

- 不同厂商的“额定电流”可能分别由温升、10%/20%/30% 降感定义，禁止只比较
  一个电流数字；
- Isat 必须按瞬时峰值校核，刷新时间短不能消除磁饱和风险；
- Irms 数据高度依赖厂商测试铜皮、环境和散热，必须在 Rev B 实板复验；
- `74438356150` 当前存在 PCN，若后续采用，应按采购日期重新下载生效版本；
- 在缺少 SXN 官方规格书时，不能宣称任何候选已经与当前料完全等效。

## 4. 面积与体积收益

仅按本体平面计算：

```text
当前每颗：7.1 × 6.6 = 46.86 mm²
当前两颗：93.72 mm²

5.4 × 5.4 两颗：58.32 mm²，减少约 37.8%
4.0 × 4.0 两颗：32.00 mm²，减少约 65.9%
4.1 × 4.1 两颗：33.62 mm²，减少约 64.1%
```

若当前器件实测高度约为 5 mm，则 5030 候选包络体积约减少 60%，
XGL4040 约减少 72%，4020 约减少 85%。这些是几何估算，不包含焊盘、courtyard、
磁场净空和开关环路布线。

现板为 80 × 75 mm，两个电感本体只占整板约 1.56%；在 Rev B-mini 中仍有收益，
但仅替换电感不会自动得到小型 PCB，必须同步重新布局其他功率器件和测试点。

## 5. 相关器件的小型化优先级

Rev A1 有 13 颗 1210 电容：11 颗 `10 µF/25 V` 和 2 颗
`0.47 µF/50 V`。按 `3.2 × 2.5 mm` 本体估算总面积约 `104 mm²`，已经大于
两颗当前电感的 `93.72 mm²`。证据见
[`REV_A1_1210_PAD_AUDIT.md`](REV_A1_1210_PAD_AUDIT.md)。

### 5.1 可优先评估

- C23：位于 3.3 V 的 V_B 输入，当前为 `10 µF/25 V/1210`；优先寻找满足
  有效容量、纹波和温度要求的 0805 候选；
- 逻辑上拉和绑带电阻：可从 0603 评估到 0402，但面积收益小且返修难度增加；
- 非量产调试点：可改为底面 pogo pad 或缩小测试盘，但首轮 Rev B 仍应保留
  高压、电流和电源关键测点。

### 5.2 有条件评估

- C14/C15：`0.47 µF/50 V/1210` 可筛选 0805，但必须核对实际偏压下有效容量；
- D1-D4：SOD-123 可筛选 SOD-323/DFN，但必须核对实际反向峰值、浪涌、VF、
  漏电和温升；
- R1/R3：1206 电流检测电阻可筛选 0805，但必须满足脉冲功率、温漂、精度和
  Kelvin/低寄生布局；
- Q2：SOT-23 可筛选 2 × 2 mm DFN；必须保持极性、VDS/VGS、RDS(on)、脉冲
  电流和热性能；
- Q1 已为 SC-70，继续缩小的面积收益较低。

### 5.3 当前不得直接缩小

- C2/C4/C5/C6：VPH、PREVGL、VPC 与飞跨电容；
- C7-C12：VSH/VSH_LV/VSH_LV2/VSL/VSL_LV/VSL_LV2 轨电容。

上述电容必须先得到对应电源轨直流值、过冲、纹波和最低有效电容量。高容 MLCC
封装越小，直流偏压导致的容量衰减通常越严重；不能只按标称容量和耐压替换。

## 6. 定版前的测量方法

不能只用 R1/R3 阻值推导控制器限流：

```text
Itrip,L1 ≈ VRESEH_trip / 0.20 Ω
Itrip,L2 ≈ VRESEC_trip / 0.22 Ω
```

SPD1657B 的比较器门限、消隐时间、限流方式和开关频率未知，所以公式中的
`Vtrip` 不能猜测。R1/R3 的 `0.2 W` 额定也不是开关峰值电流上限。

现板至少补测：

1. 用差分探头测 R1 两端，取得 L1 在 Q1 导通阶段的电流斜坡和峰值；
2. L1 关断后的二极管电流不经过 R1，完整 Irms 应使用电流探头或专用串联
   四端 shunt；
3. 测 R3 两端并同步 SW_C，确认 L2 的完整电流波形；
4. 同步记录 SW_H/SW_C 的频率、导通时间、`di/dt`、过冲和振铃；
5. 覆盖冷启动、PON、DRF 各阶段、POF、六色纯色、最坏转换和连续刷新；
6. 记录 VPH、PREVGL、VPC 的建立、纹波、跌落、释放以及电感热像。

## 7. 候选准入门槛

第一轮工程门槛建议为：

```text
L0 = 15 µH ±20%
Isat（20%降感、最高工作温度）≥ 1.25 × 实测最坏 Ipk
Irms（最高温、实际铜皮/机壳降额后）≥ 1.25 × 实测最坏阶段 Irms
工作电压 ≥ 1.25 × 实测端间峰值及振铃
屏蔽、软饱和结构优先
SRF 明显高于实测开关频率
```

DCR 比较边界：

- 最大值不高于当前第三方元数据约 85 mΩ：优先；
- 85-110 mΩ：条件接受，必须完成轨值、效率和热验证；
- 明显高于 110 mΩ：只作为低 RMS 电流实验，不进入首轮生产 BOM。

候选实板还必须同时满足：

- 无明显饱和拐点或电流失控；
- VPH、PREVGL、VPC 与 Rev A1 基线一致且无异常纹波/建立延迟；
- BUSY、刷新时间、输入电流和显示结果不劣于基线；
- 连续刷新后温升、噪声和 EMI 可接受；
- POF 后高压正常释放。

## 8. 推荐样板组合

### Rev B-mini A：低风险首轮

```text
L1 = Würth 7843845030150
L2 = Würth 7843845030150
二供 = Coilcraft XGL5030-153MEC
```

目的：在约 38% 电感平面面积缩减下，优先保持低 DCR、热能力和饱和裕量。

### Rev B-mini B：面积优先实验

```text
L1 = 5030 级候选
L2 = Coilcraft XGL4040-153MEC
```

前提：L2 实测峰值/RMS 和最高温度满足第 7 节门槛。

### Rev B-mini C：超薄研究样

```text
L1/L2 候选 = Würth 74438356150
```

仅在实测证明峰值和 RMS 足够低时进入 A/B；其较高 DCR 不适合作为当前默认方案。

## 9. 后续决策门禁

在进入原理图和 PCB 设计前仍需：

- 完成 H0 Rev A1 archive/hash；硬件 tag 继续需要用户明确授权；
- 取得 L1/L2 定量波形和温升；
- 测量高压轨和 1210 电容实际偏压；
- 用户确认目标 PCB 长宽、总厚度、是否允许双面 SMT/4 层；
- ESP32 当前初步基线为 WROOM-1-N8R8；用户仍需确认生产模组、是否做
  XIAO Plus 工程样、天线形式和机械位置；
- TF 卡槽、独立 SPI、EPD 3.3 V load switch 与总电源路径进入 H2 输入；
- 完成 ESP32、TF 写卡、EPD 刷新及三者叠加的 3.3 V 电流/跌落实测；
- 用户确认电池、USB-C、TF 卡口和机械位置；
- 核对候选料可采购性、厂商规格版本、JLC 装配类型及生命周期。

在这些门禁完成前，本文件只用于 H1 候选收敛，不构成 H2 设计启动或采购授权。
