oceanye/ESP32_C73-MF1750/docs/REV_A1_1210_PAD_AUDIT.md

# Rev A1：1210 电容焊盘复核

日期：2026-07-13  
涉及位号：C7、C8、C9、C10、C11、C12、C14、C15。

## 结论

没有选错料号或封装，不构成生产阻断项，不建议因此撤单。这 8 颗均为
标准 1210 / 3225 Metric MLCC，PCB 焊盘与器件尺寸及厂家推荐 land pattern
匹配。“器件宽、焊盘窄”的观感来自陶瓷本体覆盖两个端头焊盘之间区域；
MLCC 只需要两端金属化端头落在焊盘上，焊盘不应覆盖整个陶瓷本体。

## 料号

| 位号 | LCSC/JLC | 器件 | 规格 |
|---|---|---|---|
| C7–C12 | C2909422 | Walsin 1210B106K250CT | 10uF、25V、X7R、1210 |
| C14/C15 | C309505 | Yageo CC1210KKX7R9BB474 | 0.47uF、50V、X7R、1210 |

JLC 与 LCSC 均把两个料号标为 1210；本地 BOM 使用的封装为
`Capacitor_SMD:C_1210_3225Metric`。

## PCB 实际尺寸

- 单个焊盘：1.15 × 2.70mm。
- 焊盘中心距：2.95mm。
- 内间隙：1.80mm。
- 总铜跨度：4.10mm。
- PCB F.Fab 本体：3.20 × 2.50mm。
- 名义 toe 外伸：每端约 0.45mm。
- 横向焊盘宽度：2.70mm，大于 2.50mm 名义器件宽度。

Yageo 对 CC1210 推荐的回流焊尺寸为：总跨度 A=4.0±0.25mm、内间隙
B=2.0±0.25mm、焊盘长度 C=1.0±0.25mm、焊盘宽度 D=2.7±0.25mm。
本板 A=4.10、B=1.80、C=1.15、D=2.70，全部处于推荐范围。

## 嘉立创预览判断

C7–C12、C14、C15 的两个焊盘中心均沿板面上下方向排列，因此器件的
3.2mm 长轴也必须上下排列：

- 若预览中的器件长轴为竖向，并跨接上下两个焊盘：可以接受提示继续。
- 若预览中的器件长轴为横向，与两个焊盘连线垂直：这是旋转错误，应让
  嘉立创把这些位号旋转 90°，不应通过更换料号解决。

收板后仍按常规检查两端焊锡润湿、器件是否翘起或偏移，但本地尺寸审计
没有发现增加虚焊概率的 land-pattern 问题。
