oceanye/ESP32_C73-MF1750/参考资料/E6_73_sample code_V1.2_20250116/E6_73_sample code_V1.2_20250116/Version_Descriptions.txt

V1 20231027
V1.1 20231030 => Fix typo
V1.2 20250116 --> add VDD cut sequence at each display function
