oceanye/ESP32_C73-MF1750/hardware/mf1750_production_v1/production/mf1750_production_v1_schematic.pdf

1 | 2 | 3 | 4 | 5 | 6 | 7 | 8 | 9 | 10 | 11

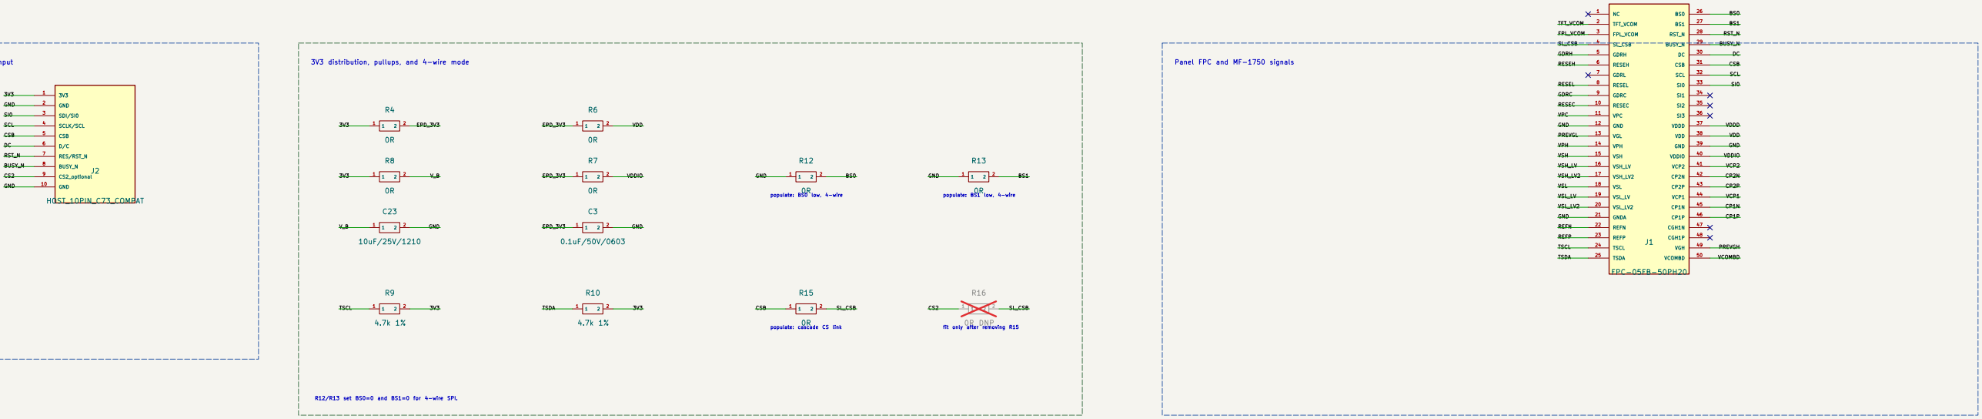
[picture p3: figure]
GND 2; SDI/SI0 3; SCLK/SCL 4; CSB 5; RES/RST_N 7; BUSY_N 8; CS2_optional 9; GND 10; J2 HOST_10PIN_C73_COMPAT; TFT_VCOM; FPL_VCOM; SL_CSB; GDRH; RESEH; GDRL 7; RESEL 8; GDRC; RESEC; VPC; GND; VGL 13; VPH; VSH; VSH_LV 16; VSH_LV2; VSL 18; VSL_LV 19; VSL_LV2; GNDA 21; REFN; REFP; TSCL 24; TSDA 25; 27 RST_N; 28 BUSY_N; 30 CSB; 31 SCL; VDDD; VDD; 38 GND; VDDIO; VCP2; VCP1; 46 CGH1N; 47 CGH1P; VGH; VCOMBD; FPC-05FB-50PH20; 0R DNP; VSL_LV EPD_3V3; TSDA; RST_N; BUSY_N; VCP2 CP2N; PREVGH; TSCL; EPD_3V3; CSB; RESEL; PREVGL VPH; SCL CSB; VSH_LV; VSL CS2; SCL 3V3; populate: BS0 low, 4-wire; populate: BS1 low, 4-wire; fit only after removing R15
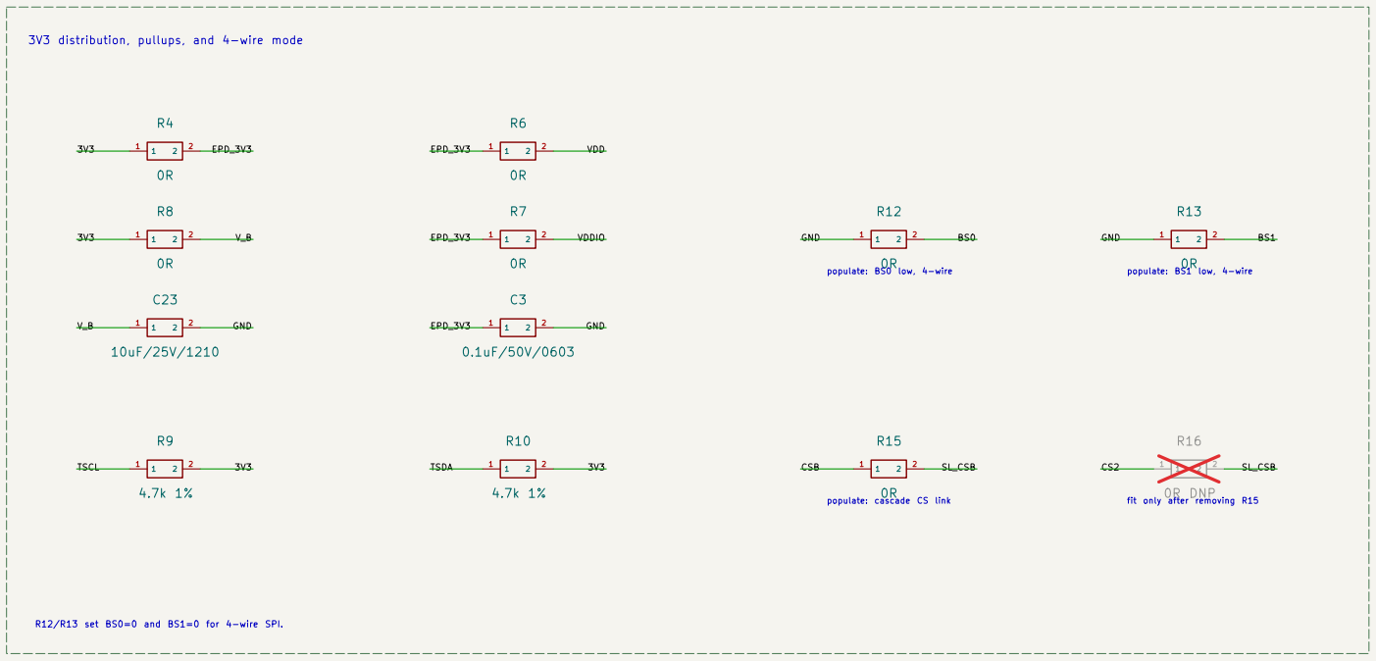
[picture p4: figure]

AB

C

D

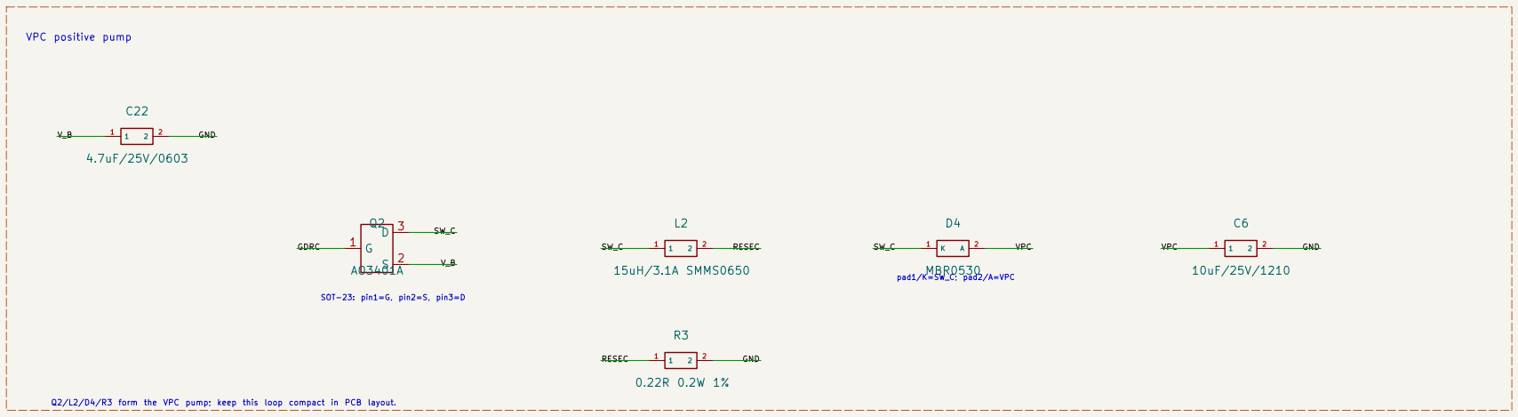
[picture p5: figure]
15uH/3.1A SMMS0650; 2 D4 MBR0530; RESEC; GND; VPC; GDRC; pad1/K=SW_C; pad2/A=VPC; VPC positive pump

E

## FGH

AB

C

D

E

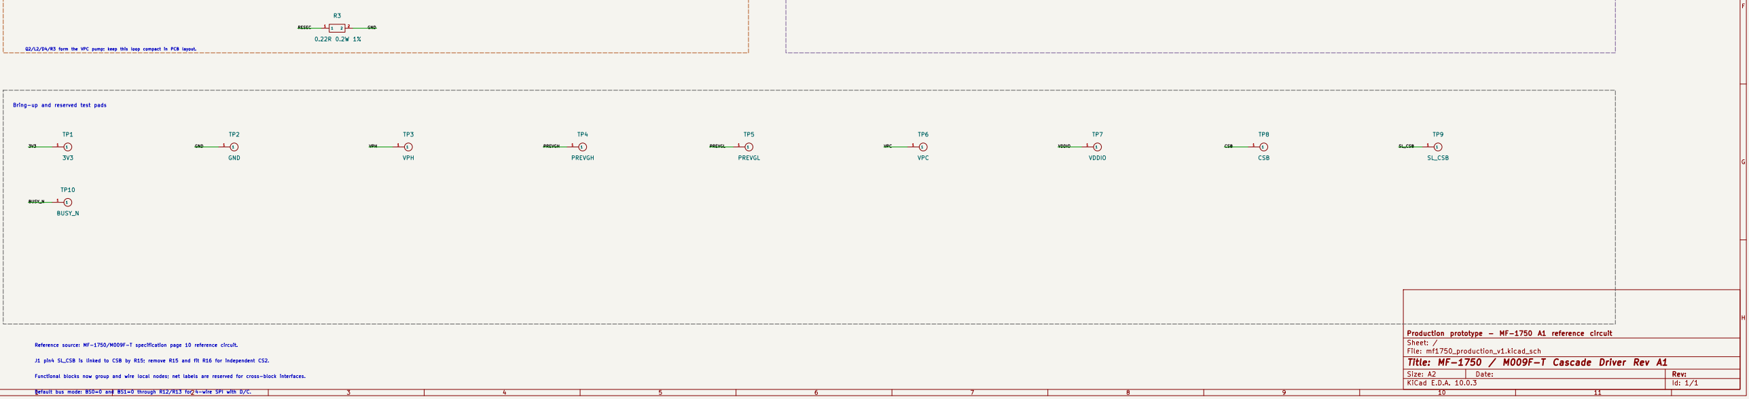
[picture p6: figure]
FGH Date:; KiCad E.D.A. 10.0.3; Size: A2; Rev:; File: mf1750_production_v1.kicad_sch; Sheet: /; 1 TP8 CSB; 1 TP10 BUSY_N; 1 TP2 GND; VPH; 1 TP4 PREVGH; 1 TP5 PREVGL; VPC; VDDIO; SL_CSB; PREVGH; PREVGL; CSB; GND; BUSY_N

# Title: MF-1750 / M009F-T Cascade Driver Rev A1

# Production prototype - MF-1750 A1 reference circuit

1

1
2

2 C21

## 1uF/50V/0805

1

1
2

2 C16

## 1uF/50V/0805

1

1
2

2 C14

## 0.47uF/50V/1210

1

1
2

2 R2

0R

1

1
2

2 C10

## 10uF/25V/1210

1

1
2

2 C20

## 1uF/50V/0805

1

1
2

2 C8

## 10uF/25V/1210

1

1
2

2 C12

## 10uF/25V/1210

1

1
2

2 C9

## 10uF/25V/1210

1

1
2

2 C13

## 4.7uF/10V/0805

1

1
2

2 C7

## 10uF/25V/1210

1

1
2

2 C11

## 10uF/25V/1210

1

1
2

2 C1

## 2.2uF/25V/0603

1

1
2

2 C19

## 1uF/50V/0805

1

1
2

2 C18

## 1uF/50V/0805

1

1
2

2 C17

## 1uF/50V/0805

1

1
2

2 C15

## 0.47uF/50V/1210

VDDD

GND

RESEL

GND

VSH_LV2

GND

VSL

VSL_LV2 | REFN | GND
GND | REFP
TFT_VCOM | GND
FPL_VCOM | GND
VSH | GND

GND

VSH_LV | GND
VSL_LV | GND
GND | VCP2 | GND | CP2N | CP2P | VCP1 | GND
CP1N | CP1P | VCOMBD | GND

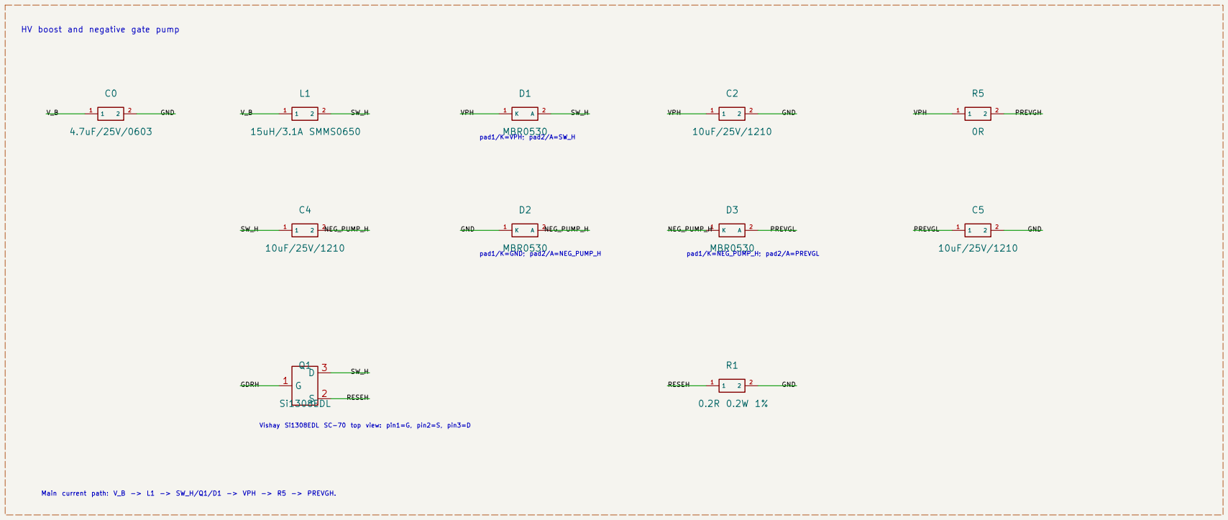
[picture p7: figure]
2 D3 MBR0530; 2 D2 MBR0530; Si1308EDL; 2 D1 MBR0530; 15uH/3.1A SMMS0650; GND; PREVGL V_B; PREVGL; NEG_PUMP_H; VPH; GND NEG_PUMP_H; RESEH; GDRH; PREVGH; pad1/K=NEG_PUMP_H; pad2/A=PREVGL pad1/K=VPH; pad2/A=SW_H

Main current path: V_B -> L1 -> SW_H/Q1/D1 -> VPH -> R5 -> PREVGH. SOT-23: pin1=G, pin2=S, pin3=D

J1 pin4 SL_CSB is linked to CSB by R15; remove R15 and fit R16 for independent CS2. Functional blocks now group and wire local nodes; net labels are reserved for cross-block interfaces. Default bus mode: BS0=0 and BS1=0 through R12/R13 for 4-wire SPI with D/C. Diode polarity is assigned in BOM notes; match footprint pin A/K to those notes before PCB layout. Reserved FPC pins are routed only to isolated single test pads; pin1 NC is explicitly no-connect. Footprints and voltage ratings are assigned for the Rev A production prototype. Default firmware uses one CS with R15 fitted; independent CS2 is an optional bring-up configuration. Reference source: MF-1750/M009F-T specification page 10 reference circuit.

### MCU / SPI control input

Q2/L2/D4/R3 form the VPC pump; keep this loop compact in PCB layout.

Panel-side caps, references, and flying capacitors

Vishay Si1308EDL SC-70 top view: pin1=G, pin2=S, pin3=D Bring-up and reserved test pads

3V3 distribution, pullups, and 4-wire mode | Panel FPC and MF-1750 signals HV boost and negative gate pump
pad1/K=GND; pad2/A=NEG_PUMP_H R12/R13 set BS0=0 and BS1=0 for 4-wire SPI. | populate: cascade CS link
