oceanye/ESP32_C73-MF1750/hardware/mf1750_devkitc_compact/mf1750_fpc_pinmap.csv

pin | name | net | note
1 | NC |  | Per I/O and mechanical pin tables; page-10 VPP label is not used
2 | TFT_VCOM | TFT_VCOM
3 | FPL_VCOM | FPL_VCOM
4 | SL_CSB | SL_CSB | Slave controller select; default linked to CSB through R15
5 | GDRH | GDRH
6 | RESEH | RESEH
7 | GDRL |  | Reserved
8 | RESEL | RESEL
9 | GDRC | GDRC
10 | RESEC | RESEC
11 | VPC | VPC
12 | GND | GND
13 | VGL | PREVGL
14 | VPH | VPH
15 | VSH | VSH
16 | VSH_LV | VSH_LV
17 | VSH_LV2 | VSH_LV2
18 | VSL | VSL
19 | VSL_LV | VSL_LV
20 | VSL_LV2 | VSL_LV2
21 | GNDA | GND
22 | REFN | REFN
23 | REFP | REFP
24 | TSCL | TSCL
25 | TSDA | TSDA
26 | BS0 | BS0
27 | BS1 | BS1
28 | RST_N | RST_N
29 | BUSY_N | BUSY_N
30 | DC | DC
31 | CSB | CSB
32 | SCL | SCL
33 | SI0 | SI0
34 | SI1 |  | Reserved in 4-wire SPI
35 | SI2 |  | Reserved in 4-wire SPI
36 | SI3 |  | Reserved in 4-wire SPI
37 | VDDD | VDDD
38 | VDD | VDD
39 | GND | GND
40 | VDDIO | VDDIO
41 | VCP2 | VCP2
42 | CP2N | CP2N
43 | CP2P | CP2P
44 | VCP1 | VCP1
45 | CP1N | CP1N
46 | CP1P | CP1P
47 | CGH1N |  | Reserved
48 | CGH1P |  | Reserved
49 | VGH | PREVGH
50 | VCOMBD | VCOMBD
