oceanye/ESP32_C73-MF1750/docs/G1_SPECTRA6_GAMUT_MAPPING_HANDOFF_2026-08-05.md

# G1 Spectra 6 抖动前色域映射与照片优化 Handoff（2026-08-05）

状态：`READY FOR REMOTE AI / SOFTWARE-ONLY / HARDWARE CALIBRATION BLOCKED`

> 本工作包的目标不是再增加一种抖动算法，而是在现有 C2 六色量化之前加入
> 可审计、可复现、由面板 profile 驱动的亮度与色域映射。没有合格的实测
> artifact 时，可以完成代码、schema、实验预览和离线测试，但不得声称颜色已经
> 实屏校准，也不得解锁正式整屏上传。

## 0. 工作包元数据

```text
Work package ID: G1
Authoring baseline: local main 0dfdbd7
Execution baseline: 以集成负责人提供的、包含本 Handoff 的精确 commit 为准
Suggested branch: feature/spectra6-gamut-mapping
Primary execution environment: host/server; no hardware required
Hardware tested: NO
Target panel contract: 1024x600, 4bpp, 307200 bytes
Legal physical codes: 0=black, 1=white, 2=yellow, 3=red, 5=blue, 6=green
Canonical colour engine: host/color_pipeline
Formal-colour blocker: controlled D65/2deg panel and mixture measurements
```

远程 AI 开始工作时必须先记录：

```powershell
git rev-parse HEAD
git status --short --branch
```

若当前提交不包含本文件，或工作区存在会与本工作包重叠的未知修改，应停止并向
集成负责人报告，不得自行换一个旧基线继续实现。未跟踪的 `.test-output/` 属于
现有工作区内容，不得读取、删除、清理或提交。

## 1. 背景与结论

用户提供的文章[《只靠抖动是不够的》](https://www.einkframe.com/2025/12/11/spectra-6-gamut-mapping-zh/)
提出了正确的工程顺序：先将源图映射到 Spectra 6 实际可表现的亮度和综合色域，
再把连续目标颜色转成六种物理像素的空间分布。只更换 Floyd–Steinberg、Atkinson、
Stucki 或 JJN，主要改变纹理和误差传播，不能单独解决过暗、过曝、肤色偏差、
绿色层次断裂或饱和区域细节丢失。

该文章只能作为技术方向，不能作为规格书、测量数据或可复现算法来源。它没有公开：

- 面板六色 XYZ/Lab 或光谱反射率；
- 照明、观察者、测量几何、面板批次和温度；
- 色域边界、黑白点、映射函数、LUT 或优化目标；
- “绿＋黄”等混色比例的求解方法；
- 抖动参数、测试集、真屏 RAW、Delta E 结果或显著性数据。

因此不得从文章插图反推坐标，不得复制一个固定“绿＋黄”规则，也不得把 ISFR
宣传效果写成项目已经验证的结论。ICC 同样指出，照片向较小输出色域映射时通常
需要感知渲染，并且对比度、细节、色相和饱和度之间不存在唯一最优取舍：

- [ICC profile 与 rendering intent 说明](https://www.color.org/iccprofile.xalter)；
- [ICC.1:2022](https://www.color.org/specifications/ICC.1-2022-05.pdf)；
- [E Ink Spectra 6 官方发布说明](https://www.eink.com/news/detail/E-Ink-Launches-E-Ink-Spectra-6-a-Revolutionary-New-Color-ePaper-for-Paper-Sign-Replacement)。

## 2. 当前仓库事实

### 2.1 已有能力

- `host/color_pipeline/color.py` 已实现 IEC sRGB 传递函数、线性 RGB、D65 XYZ、
  D65/2° Lab 和 CIEDE2000；
- `host/color_pipeline/pipeline.py` 已有最近色、serpentine Floyd–Steinberg、
  Atkinson、Bayer 8x8 和确定性 hashed threshold；
- C2 已有透明像素线性光白底合成、白色保护、边缘保护、文本模式、规范帧打包、
  预览 PNG、颜色使用率、输入/帧 hash 和确定性报告；
- `host/color_pipeline/palette.py` 的 palette schema v2 已绑定物理色码、D65/2°、
  measurement ID、artifact SHA256 和 canonical hash；
- `host/application/pipeline.py` 已经对未校准 palette、正式上传用途、报告身份和
  frame hash 执行 fail-closed 校验；
- 主机 Web/API、离线预览和设备适配层已经存在；
- 当前使用场景是低频刷新照片相框，复杂图片处理应优先放在 host/server，
  ESP32-S3 只接收确定性最终帧并缓存，不为本工作包升级 ESP32-P4。

### 2.2 当前关键缺口

1. `host/color_pipeline/palettes/reference_srgb_v1.json` 明确是
   `calibrated=false`、`calibration=null` 的数学 sRGB 锚点，不是 MF-1750
   真屏测量；
2. 当前主机路径把规范化图像直接送入最近色/误差扩散，没有独立的 pre-dither
   tone/gamut mapping；
3. 当前报告没有 gamut profile、rendering intent、映射算法版本、映射强度、
   out-of-gamut 比例、亮度/色度压缩量和 mapped-raster 身份；
4. `src/main.cpp` 的设备内嵌网页仍硬编码另一套近似 RGB palette、RGB 欧氏距离和
   固定 gamma/饱和度处理，与主机 Lab/CIEDE2000 管线并不等价；
5. 当前 ordered 模式用最近两色的距离比例作概率，这不是六色面积混合权重求解；
6. hashed threshold 明确不是 blue noise；
7. 浏览器规范化路径不能可靠保留原图 ICC/宽色域 provenance，部分 host fallback
   缩放质量也不适合作为正式照片路径；
8. 当前预览是代码色的显示器模拟，不是环境光下真屏的物理复现。

## 3. 必须区分的五层概念

实现者不得把以下概念混为一谈：

1. **Palette calibration**：测量六个物理纯色色块，得到带条件和 provenance 的
   XYZ/Lab；
2. **Gamut characterization**：测量典型双色/多色面积混合及图案，建立实际可达
   综合色点集或模型；
3. **Gamut mapping**：将源图连续颜色和亮度压缩到目标模型内；
4. **Halftoning/dithering**：把映射后的连续目标实现为六种物理像素的空间分布；
5. **Soft proof**：在普通显示器上模拟最终代码流的观感，只能作为近似预览。

六个纯色色点可以支持一个 `experimental linear-XYZ convex model`，但不能据此
宣称已经掌握真实空间混色色域。Lab、Delta E 或 CIE 1931 `xy` 中的几何距离也
不能直接当作物理混色比例。

## 4. 本工作包目标

高级 AI 应完成所有不依赖真屏测量的软件工作，而不是只提交调研报告：

1. 设计并实现独立、可关闭的 pre-dither gamut mapping 层；
2. 定义严格的 gamut profile/schema、provenance、canonical hash 和授权门禁；
3. 以 `host/color_pipeline` 为唯一 canonical colour engine；
4. 支持至少三种版本化 rendering preset；
5. 保持旧 C2 行为可选择且 byte-for-byte 回归稳定；
6. 把新映射身份纳入 application artifact、报告和正式用途校验；
7. 在 host Web UI 提供原图、映射后连续预览、最终六色预览的对照；
8. 生成未来实测所需的离线纯色/混色色卡和 manifest，但不调用设备；
9. 提供单元、性质、golden、集成、消融和性能测试；
10. 输出完整的设计决策、已知限制和未来硬件标定输入格式。

## 5. 授权范围与永久保护边界

### 5.1 允许修改

在确有需要且保持职责清晰时，可修改或新增：

```text
host/color_pipeline/
host/application/
app/
web/
tests/
tools/                         # 仅离线色卡/测量 artifact 工具
docs/
README.md
```

### 5.2 默认禁止修改或执行

- 不修改 `src/`，尤其不得把第三套 gamut/palette 算法复制到 `src/main.cpp`；
- 不修改 `hardware/`，特别是 `hardware/mf1750_production_v1/production/`；
- 不改变 GPIO、R15/R16、CS1/CS2、色码、左右映射、扫描方向或 nibble packing；
- 不修改 SPD1657B LUT、波形、电压、时钟或 BUSY 门禁；
- 不刷写 COM8，不访问设备 `/api/frame`，不触发任何真屏刷新；
- 不下载网络照片，不调用相册服务，不加入非确定性的在线推理依赖；
- 不直接提交或推送 `main`，不创建硬件 tag；
- 不清理用户已有未跟踪文件或无关 dirty worktree；
- 不把软件 CI、预览 PNG 或模拟 Delta E 写成 `Hardware tested: YES`。

如实现必须修改 `src/`、设备协议、正式上传授权模型的基本语义或引入强制第三方
运行时依赖，应先停下，在 Handoff 中提出独立设计变更请求，不能自行扩大范围。

## 6. 目标架构

```text
原始文件 + embedded ICC/EXIF
            ↓
可信解码、方向修正、source-profile 记录
            ↓
高质量裁剪/旋转/缩放到 1024x600
            ↓
规范 working raster（显式 sRGB/linear-light 合同）
            ↓
黑白点与亮度范围映射
            ↓
pre-dither gamut mapping + rendering intent
            ↓
连续 mapped target + canonical identity
            ↓
六色面积权重/候选选择
            ↓
确定性 halftoning/dithering
            ↓
合法色码 → 307200-byte 4bpp frame
            ↓
从最终 code stream 反渲染 preview + 完整 report
```

核心库继续接受已经规范化的 `RasterImage`，不得让颜色核心隐式依赖浏览器。
原始文件 ICC/EXIF 的读取应位于 application/decode adapter；核心不强制依赖 Pillow
或 LittleCMS。若环境不能可靠转换 embedded ICC，必须明确 fail closed 或记录由
调用者显式授权的 sRGB assumption，不能静默丢弃 profile 后声称颜色可复现。

## 7. Gamut profile 合同

应新增独立于 palette schema v2 的 gamut profile。它引用 palette 的 canonical
SHA256，不复制或重新定义六个物理色码。具体 JSON 形状可在 ADR 中确定，但至少要
严格包含：

- schema version、profile ID、profile version、pipeline compatibility；
- underlying palette ID 和 canonical SHA256；
- model kind，例如 `linear_xyz_convex_v1`、`measured_point_cloud_v1`；
- characterization level，例如 `reference`、`measured_primaries`、
  `measured_mixtures`；
- illuminant、observer、measurement geometry、backing、instrument；
- panel model、panel ID/batch、firmware commit、waveform version；
- temperature、humidity和测量日期；缺失值必须显式为 null，不得猜测；
- measurement ID、原始 artifact SHA256 和数据单位；
- pure-colour/mixture sample 引用、空间 mask ID、面积比例；
- rendering presets 的版本化参数；
- canonical serialization scope 和 canonical SHA256；
- 信任说明：hash 只是审计指纹，不是签名或 trust store。

严格要求：

- 未知字段、错误类型、NaN、inf、越界值、重复样本、非法比例、hash 不符全部拒绝；
- `reference-srgb-v1` 永远不得被改成 calibrated；
- 示例 profile 必须命名并标记为 `synthetic/uncalibrated/experimental`；
- profile 的正式资格必须由 provenance 和既有 palette 门禁推导，不能靠一个容易
  篡改的 `formal=true` 布尔值获得；
- 启用 mapping 的正式用途必须同时具备合格的 calibrated palette 和对应的
  characterized gamut profile；panel/batch、palette hash、firmware/waveform、
  温度区间及所使用的 halftone pattern 必须与测量 artifact 匹配；
- 新门禁只能附加在现有 calibrated palette、frame、hash 和 authorization 门禁之上，
  不能替换或削弱它们；
- 缺少 mixture measurement 时，模型必须在报告中明确标为 approximation。

## 8. 算法要求
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
