oceanye/ESP32_C73-MF1750/hardware/mf1750_devkitc_b2_pcba_margin/preview/final_bottom.png

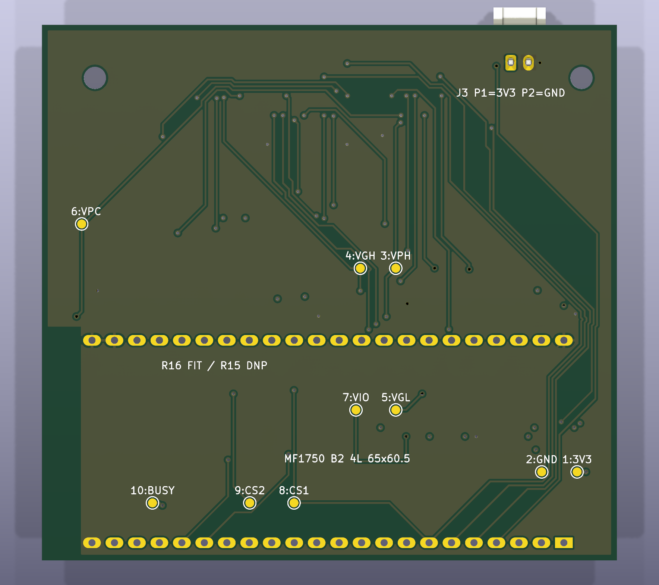
hardware/mf1750_devkitc_b2_pcba_margin/preview/final_bottom.png
