oceanye/ESP32_C73-MF1750/hardware/mf1750_devkitc_compact/preview/working_bottom.png

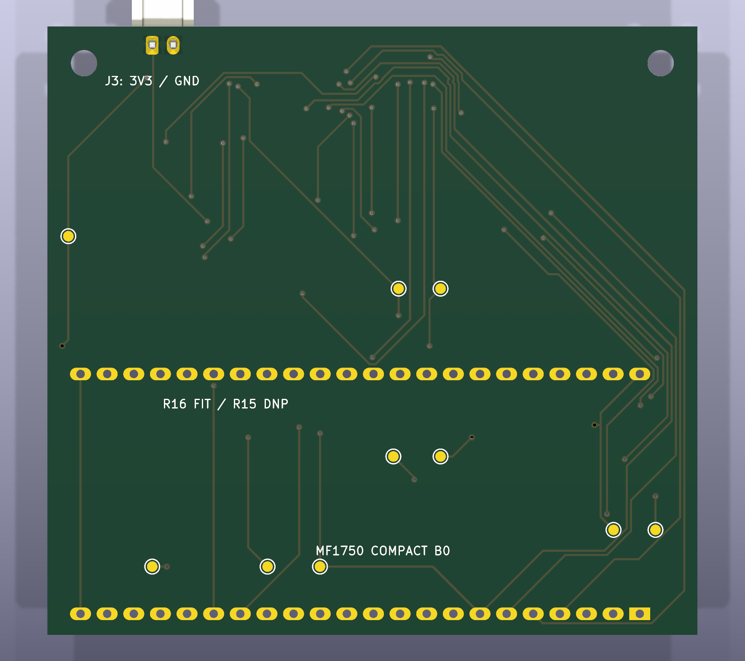
hardware/mf1750_devkitc_compact/preview/working_bottom.png
