oceanye/ESP32_C73-MF1750/hardware/mf1750_page5_fpc_detail.png

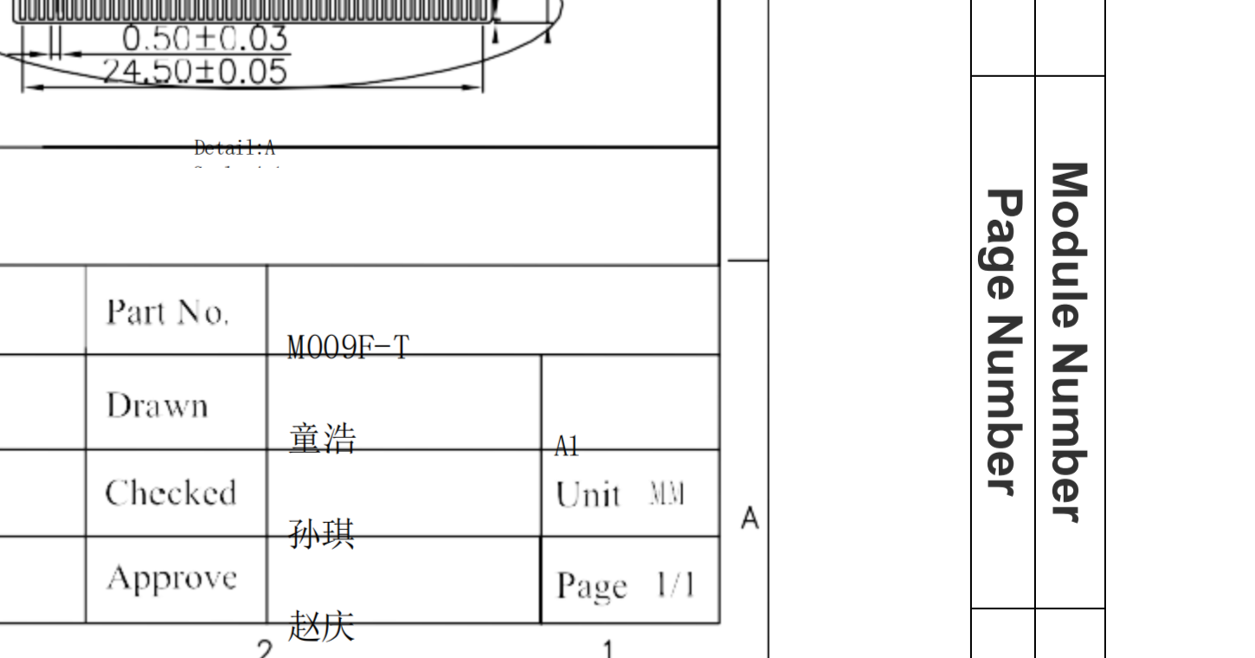
hardware/mf1750_page5_fpc_detail.png
