oceanye/ESP32_C73-MF1750/hardware/mf1750_page5_pin_table.png

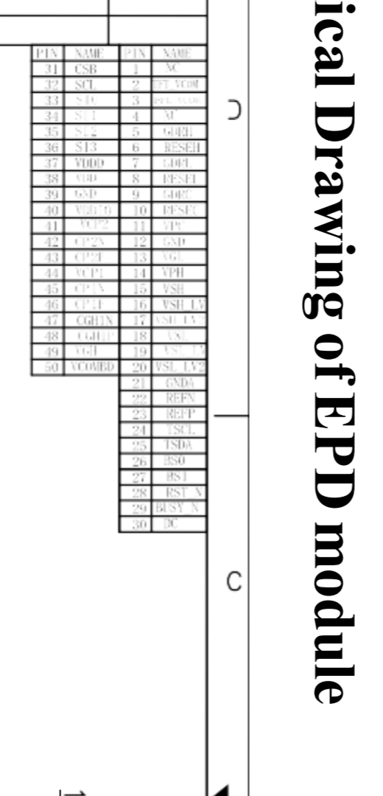
hardware/mf1750_page5_pin_table.png
