oceanye/ESP32_C73-MF1750/hardware/mf1750_production_v1/production/mf1750_production_v1_top.png

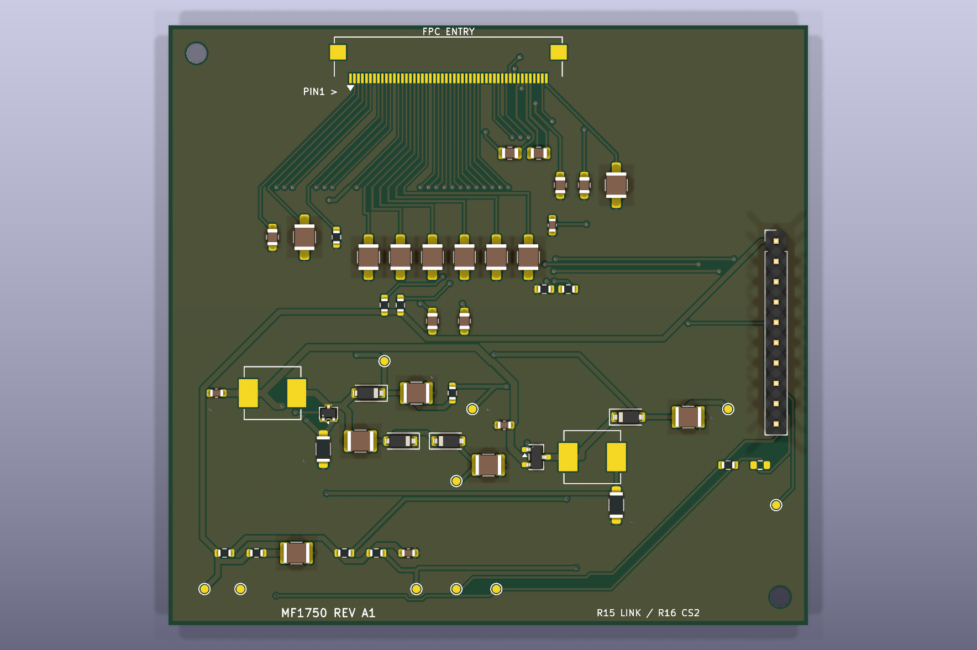
hardware/mf1750_production_v1/production/mf1750_production_v1_top.png
