oceanye/ESP32_C73-MF1750/参考资料/2路控制继电器Type-c/串口软件相关设置.png

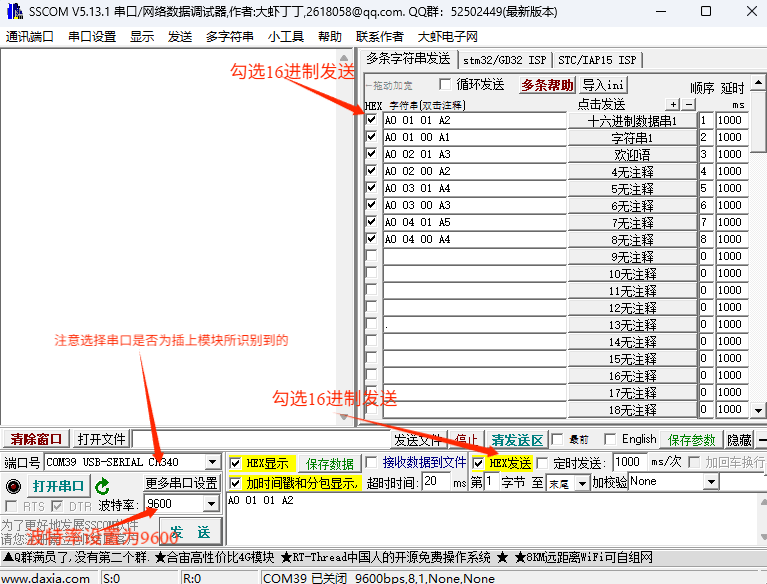
参考资料/2路控制继电器Type-c/串口软件相关设置.png
