oceanye/ESP32_C73-MF1750/参考资料/2路控制继电器Type-c/继电器接法说明1.png

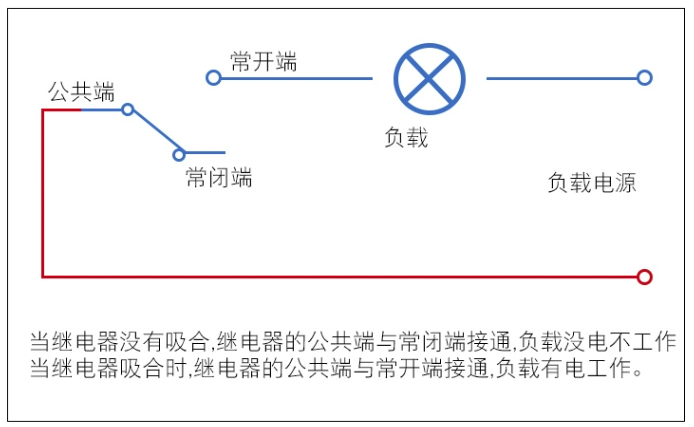
参考资料/2路控制继电器Type-c/继电器接法说明1.png
