oceanye/ESP32_C73-MF1750/参考资料/DESPI-C73-SCH-20251014_01.png

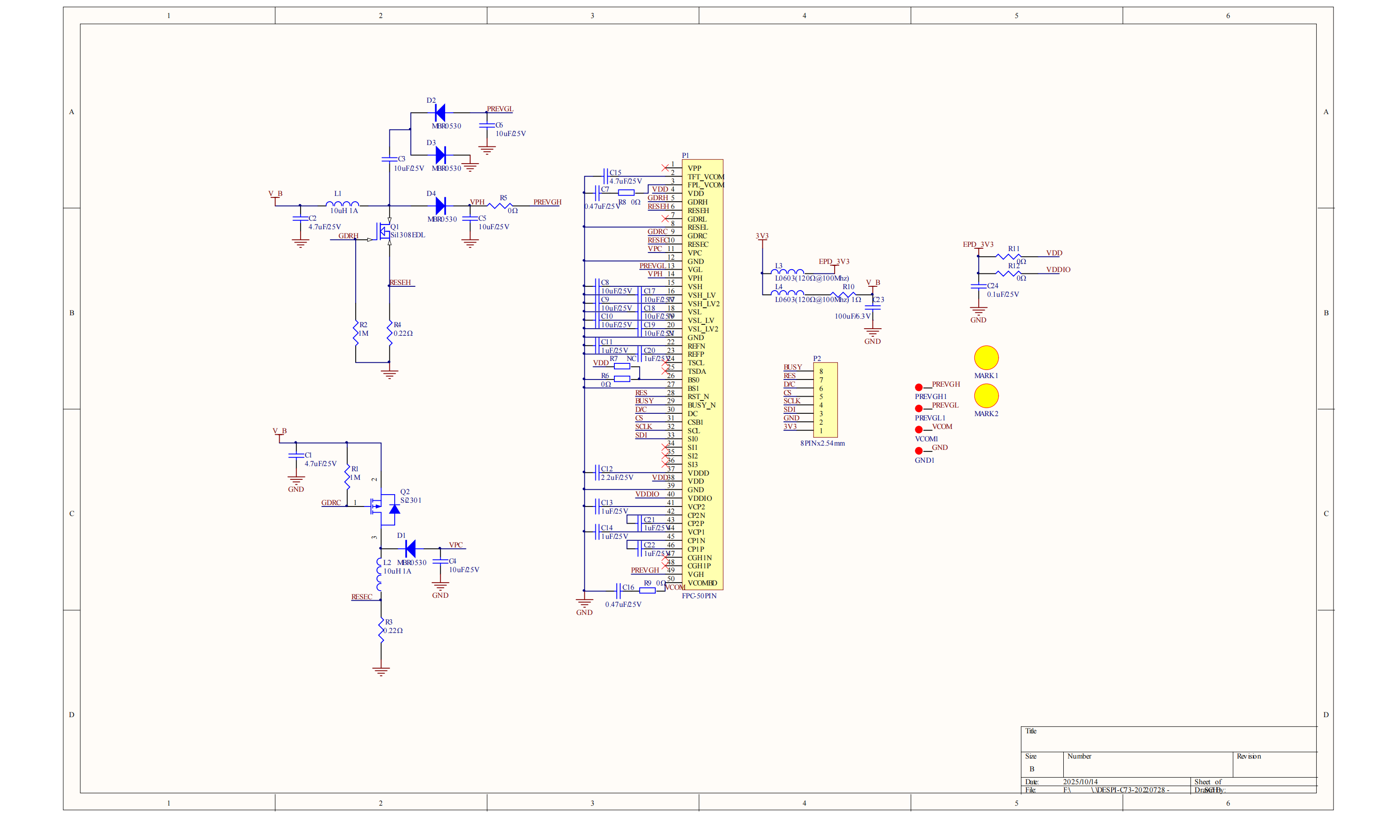
参考资料/DESPI-C73-SCH-20251014_01.png
