oceanye/ESP32_C73-MF1750/参考资料/MF-1750..1)_22.png

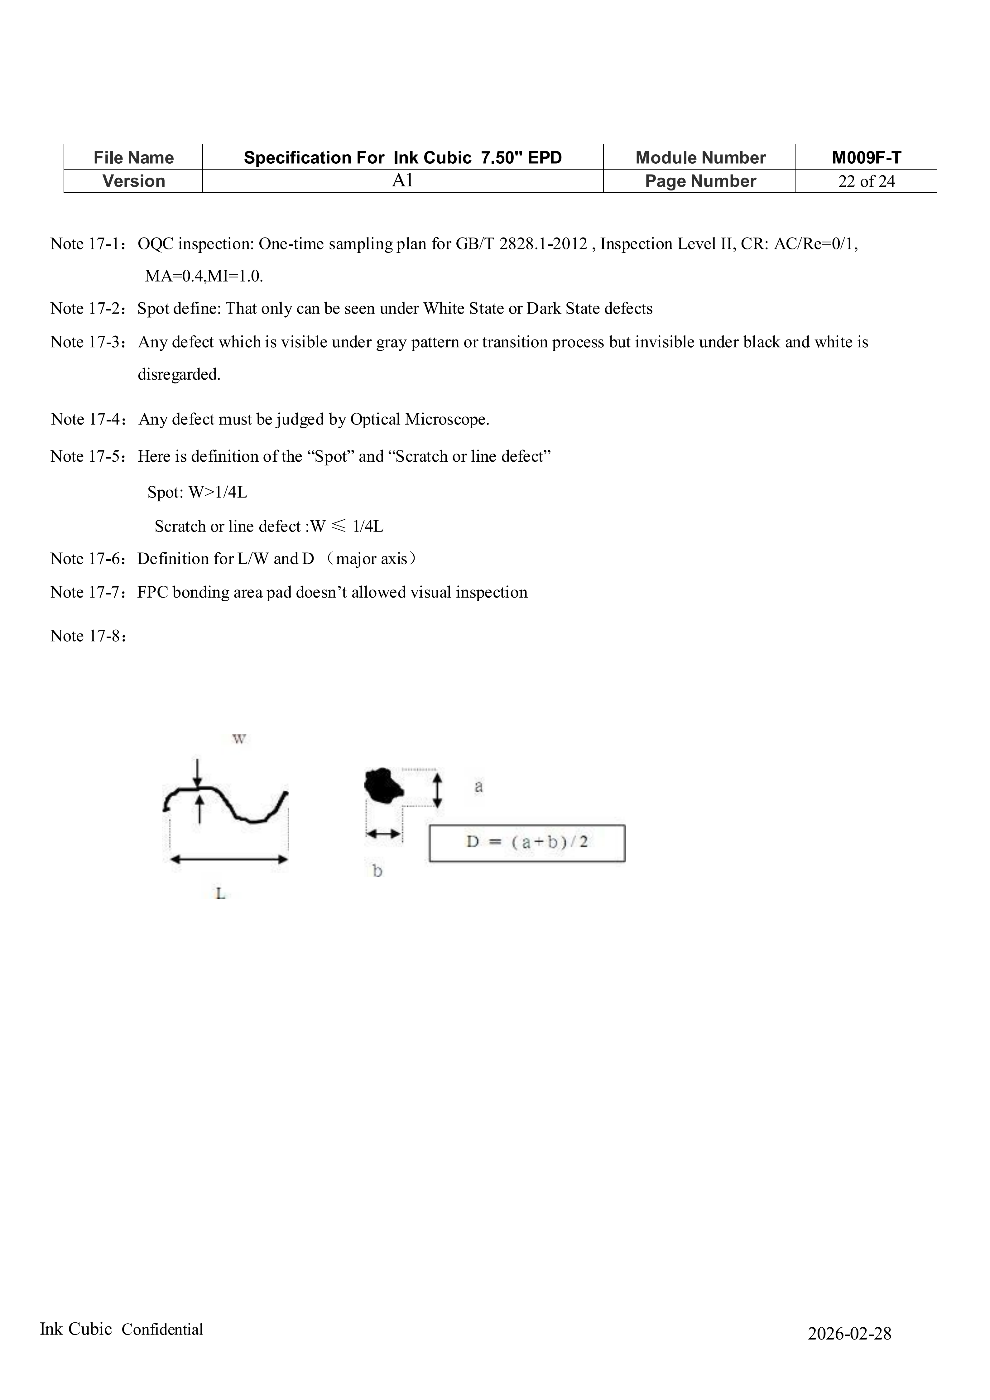
参考资料/MF-1750..1)_22.png
