oceanye/ESP32_C73-MF1750/hardware/mf1750_devkitc_b2_jlcpcb/support/ORDER_CHECKLIST.md

# Upload/order checklist

- [ ] Upload only the Gerber ZIP, BOM CSV, and CPL CSV in `upload/`.
- [ ] Confirm 65 x 60.5 mm, 4 layers, 1.6 mm, JLC04161H-7628, outer 1 oz / inner 0.5 oz.
- [ ] Confirm ENIG 1U, green mask, white silkscreen, PTH/NPTH separation.
- [ ] Confirm L2=GND and L3=power; do not accept an inferred Gerber-job stackup.
- [ ] Confirm all 46 SMT refs and 16 LCSC lines; R16 FIT, R15 absent.
- [ ] Review J1, D1-D4, Q1/Q2 orientation, pin 1, side, and rotation.
- [ ] Recheck live stock, substitutions, CAM/DFM, paste, and production files.
- [ ] Preserve mechanical first-article holds for J1/FPC, J3, J2, antenna, and enclosure.
