oceanye/ESP32_C73-MF1750/hardware/mf1750_devkitc_compact_b1/bom_reference.csv

Designator | Value | Footprint | LCSC Part # | Manufacturer | MPN | DNP | Note
J1 | 50pin 0.5mm dual-contact FPC | MF1750_Production:XUNPU_FPC-05FB-50PH20_1x50_P0.5mm_DualContact | C2856838 | XUNPU | FPC-05FB-50PH20 | No | Official JLC footprint; pin1 left in assembled-board top view
J2 | ESP32-S3-DevKitC-1-N16R8 socket | MF1750_Compact:ESP32-S3-DevKitC-1_Socket |  | Espressif | ESP32-S3-DevKitC-1-N16R8 + 2x 1x22 stacking female socket | Manual | Exact N16R8; 22.86 mm rows; installed board spacing >=11 mm; manual/DNP from SMT
J3 | EPD 3V3 INPUT | Connector_JST:JST_PH_S2B-PH-K_1x02_P2.00mm_Horizontal |  | JST | S2B-PH-K + PHR-2 housing + wire-gauge-matched PH crimp contacts | Manual | Hand-fit keyed horizontal input; pin1=3V3, pin2=GND
C0 | 4.7uF/25V/0603 | Capacitor_SMD:C_0603_1608Metric | C69335 | SAMSUNG | CL10A475KA8NQNC | No
L1 | 15uH/3.1A SMMS0650 | MF1750_Production:SXN_SMMS0650_7.1x6.6mm | C149585 | SXN | SMMS0650-150M | No
D1 | MBR0530 | Diode_SMD:D_SOD-123 | C77336 | JSCJ | MBR0530 | No | pad1/K=VPH; pad2/A=SW_H
C2 | 10uF/25V/1210 | Capacitor_SMD:C_1210_3225Metric | C2909422 | Walsin | 1210B106K250CT | No
R5 | 0R | Resistor_SMD:R_0603_1608Metric | C21189 | UNI-ROYAL | 0603WAF0000T5E | No
C4 | 10uF/25V/1210 | Capacitor_SMD:C_1210_3225Metric | C2909422 | Walsin | 1210B106K250CT | No
D2 | MBR0530 | Diode_SMD:D_SOD-123 | C77336 | JSCJ | MBR0530 | No | pad1/K=GND; pad2/A=NEG_PUMP_H
D3 | MBR0530 | Diode_SMD:D_SOD-123 | C77336 | JSCJ | MBR0530 | No | pad1/K=NEG_PUMP_H; pad2/A=PREVGL
C5 | 10uF/25V/1210 | Capacitor_SMD:C_1210_3225Metric | C2909422 | Walsin | 1210B106K250CT | No
R1 | 0.2R 0.2W 1% | Resistor_SMD:R_1206_3216Metric | C2907350 | FOJAN | FRL1206FR200TS | No
C22 | 4.7uF/25V/0603 | Capacitor_SMD:C_0603_1608Metric | C69335 | SAMSUNG | CL10A475KA8NQNC | No
L2 | 15uH/3.1A SMMS0650 | MF1750_Production:SXN_SMMS0650_7.1x6.6mm | C149585 | SXN | SMMS0650-150M | No
D4 | MBR0530 | Diode_SMD:D_SOD-123 | C77336 | JSCJ | MBR0530 | No | pad1/K=SW_C; pad2/A=VPC
C6 | 10uF/25V/1210 | Capacitor_SMD:C_1210_3225Metric | C2909422 | Walsin | 1210B106K250CT | No
R3 | 0.22R 0.2W 1% | Resistor_SMD:R_1206_3216Metric | C3017221 | VO | SCR1206FR220 | No
R4 | 0R | Resistor_SMD:R_0603_1608Metric | C21189 | UNI-ROYAL | 0603WAF0000T5E | No | FIT; J3 external EPD 3V3 to EPD_3V3
R8 | 0R | Resistor_SMD:R_0603_1608Metric | C21189 | UNI-ROYAL | 0603WAF0000T5E | No | FIT; J3 external EPD 3V3 to V_B
C23 | 10uF/25V/1210 | Capacitor_SMD:C_1210_3225Metric | C2909422 | Walsin | 1210B106K250CT | No
R6 | 0R | Resistor_SMD:R_0603_1608Metric | C21189 | UNI-ROYAL | 0603WAF0000T5E | No
R7 | 0R | Resistor_SMD:R_0603_1608Metric | C21189 | UNI-ROYAL | 0603WAF0000T5E | No
C3 | 0.1uF/50V/0603 | Capacitor_SMD:C_0603_1608Metric | C14663 | YAGEO | CC0603KRX7R9BB104 | No
R9 | 4.7k 1% | Resistor_SMD:R_0603_1608Metric | C23162 | UNI-ROYAL | 0603WAF4701T5E | No
R10 | 4.7k 1% | Resistor_SMD:R_0603_1608Metric | C23162 | UNI-ROYAL | 0603WAF4701T5E | No
R12 | 0R | Resistor_SMD:R_0603_1608Metric | C21189 | UNI-ROYAL | 0603WAF0000T5E | No | populate: BS0 low, 4-wire
R13 | 0R | Resistor_SMD:R_0603_1608Metric | C21189 | UNI-ROYAL | 0603WAF0000T5E | No | populate: BS1 low, 4-wire
C13 | 4.7uF/10V/0805 | Capacitor_SMD:C_0805_2012Metric | C87998 | SAMSUNG | CL21B475KPFNNNE | No
C14 | 0.47uF/50V/1210 | Capacitor_SMD:C_1210_3225Metric | C309505 | YAGEO | CC1210KKX7R9BB474 | No
R2 | 0R | Resistor_SMD:R_0603_1608Metric | C21189 | UNI-ROYAL | 0603WAF0000T5E | No
C7 | 10uF/25V/1210 | Capacitor_SMD:C_1210_3225Metric | C2909422 | Walsin | 1210B106K250CT | No
C8 | 10uF/25V/1210 | Capacitor_SMD:C_1210_3225Metric | C2909422 | Walsin | 1210B106K250CT | No
C9 | 10uF/25V/1210 | Capacitor_SMD:C_1210_3225Metric | C2909422 | Walsin | 1210B106K250CT | No
C10 | 10uF/25V/1210 | Capacitor_SMD:C_1210_3225Metric | C2909422 | Walsin | 1210B106K250CT | No
C11 | 10uF/25V/1210 | Capacitor_SMD:C_1210_3225Metric | C2909422 | Walsin | 1210B106K250CT | No
C12 | 10uF/25V/1210 | Capacitor_SMD:C_1210_3225Metric | C2909422 | Walsin | 1210B106K250CT | No
C21 | 1uF/50V/0805 | Capacitor_SMD:C_0805_2012Metric | C28323 | SAMSUNG | CL21B105KBFNNNE | No
C20 | 1uF/50V/0805 | Capacitor_SMD:C_0805_2012Metric | C28323 | SAMSUNG | CL21B105KBFNNNE | No
C1 | 2.2uF/25V/0603 | Capacitor_SMD:C_0603_1608Metric | C415535 | Murata | GRM188Z71E225KE43D | No
C19 | 1uF/50V/0805 | Capacitor_SMD:C_0805_2012Metric | C28323 | SAMSUNG | CL21B105KBFNNNE | No
C18 | 1uF/50V/0805 | Capacitor_SMD:C_0805_2012Metric | C28323 | SAMSUNG | CL21B105KBFNNNE | No
C17 | 1uF/50V/0805 | Capacitor_SMD:C_0805_2012Metric | C28323 | SAMSUNG | CL21B105KBFNNNE | No
C16 | 1uF/50V/0805 | Capacitor_SMD:C_0805_2012Metric | C28323 | SAMSUNG | CL21B105KBFNNNE | No
C15 | 0.47uF/50V/1210 | Capacitor_SMD:C_1210_3225Metric | C309505 | YAGEO | CC1210KKX7R9BB474 | No
R15 | 0R DNP | Resistor_SMD:R_0603_1608Metric | C21189 | UNI-ROYAL | 0603WAF0000T5E | Yes | DNP; do not fit with R16
R16 | 0R | Resistor_SMD:R_0603_1608Metric | C21189 | UNI-ROYAL | 0603WAF0000T5E | No | FIT; verified independent CS2 to SL_CSB
Q1 | Si1308EDL | Package_TO_SOT_SMD:SOT-323_SC-70 | C3289597 | Vishay | SI1308EDL-T1-BE3 | No | Vishay Si1308EDL SC-70 top view: pin1=G, pin2=S, pin3=D; reference-selected part, RDS(on) is a controlled A1 numerical deviation
Q2 | AO3401A | Package_TO_SOT_SMD:SOT-23-3 | C15127 | AOS | AO3401A | No | SOT-23: pin1=G, pin2=S, pin3=D
TP1 | 3V3 | TestPoint:TestPoint_Pad_D1.0mm |  |  |  | Manual | Bottom-side measurement pad only; never use as the panel supply connector
TP2 | GND | TestPoint:TestPoint_Pad_D1.0mm |  |  |  | Manual | Bottom-side measurement pad only; never use as the panel supply connector
TP3 | VPH | TestPoint:TestPoint_Pad_D1.0mm |  |  |  | Manual | test pad only
TP4 | PREVGH | TestPoint:TestPoint_Pad_D1.0mm |  |  |  | Manual | test pad only
TP5 | PREVGL | TestPoint:TestPoint_Pad_D1.0mm |  |  |  | Manual | test pad only
TP6 | VPC | TestPoint:TestPoint_Pad_D1.0mm |  |  |  | Manual | test pad only
TP7 | VDDIO | TestPoint:TestPoint_Pad_D1.0mm |  |  |  | Manual | test pad only
TP8 | CSB | TestPoint:TestPoint_Pad_D1.0mm |  |  |  | Manual | test pad only
TP9 | SL_CSB | TestPoint:TestPoint_Pad_D1.0mm |  |  |  | Manual | test pad only
TP10 | BUSY_N | TestPoint:TestPoint_Pad_D1.0mm |  |  |  | Manual | test pad only
H1,H2 | M2.5 NPTH | MountingHole:MountingHole_2.5mm |  |  |  | Manual | mechanical
