oceanye/ESP32_C73-MF1750/hardware/mf1750_devkitc_b1_jlcpcb/support/DNP_LIST.csv

Designator | Value | Reason | Paste aperture
R15 | 0R DNP | DNP; R16 is the verified fitted CS2-to-SL_CSB strap; never fit both | removed from fabrication variant
