oceanye/ESP32_C73-MF1750/hardware/mf1750_devkitc_b1_build_evidence/initial_top.png

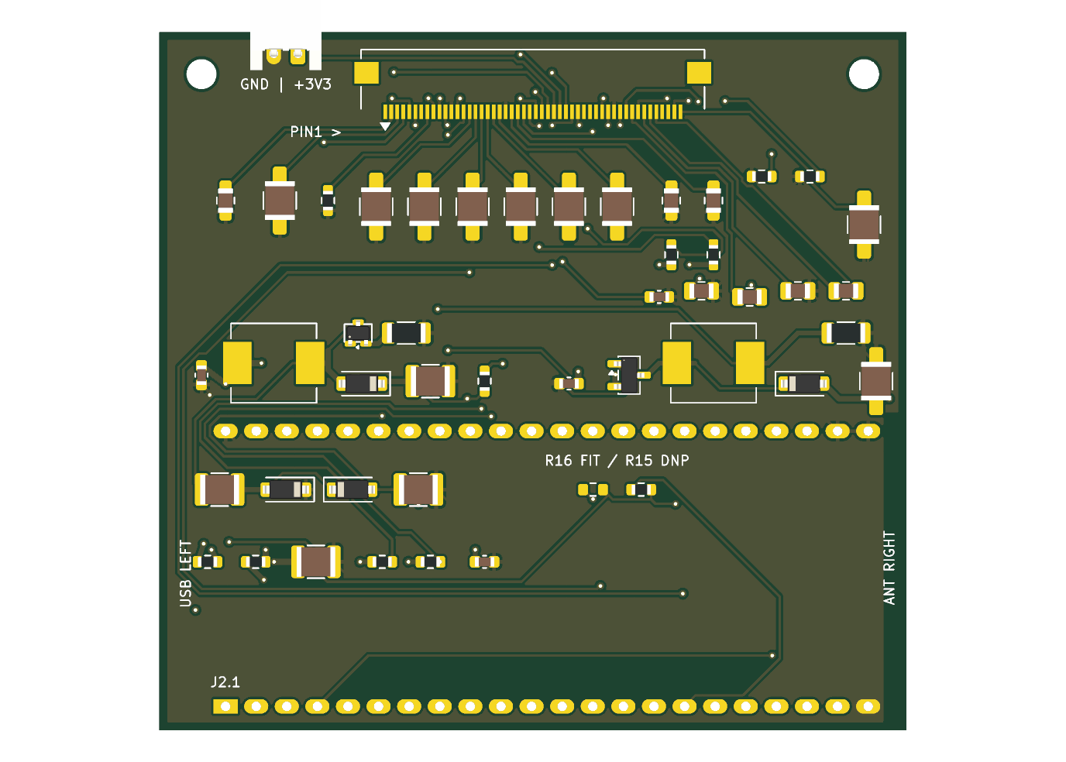
hardware/mf1750_devkitc_b1_build_evidence/initial_top.png
