oceanye/ESP32_C73-MF1750/hardware/mf1750_devkitc_b2_jlcpcb/support/assembly_top.png

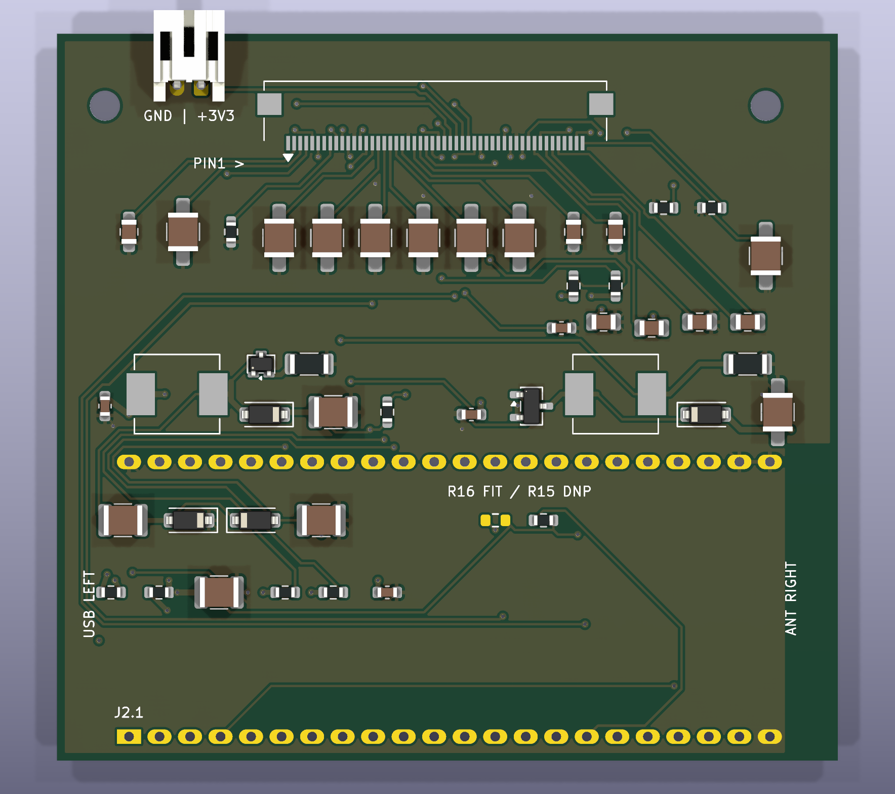
hardware/mf1750_devkitc_b2_jlcpcb/support/assembly_top.png
