oceanye/ESP32_C73-MF1750/tests/fixtures/README.md

# Generated regression fixtures

The three canonical 307200-byte fixtures are generated deterministically by
`host.epd_frame.generate_fixture`; raw binaries are intentionally not committed.
Their frozen full-frame and per-controller FNV-1a hashes are tested in
`tests/test_frame_contract.py` against the values in the Rev A1 handoff plan.
