oceanye/ESP32_C73-MF1750/hardware/c73_full_mf1750_adapted_kicad/c73_full_mf1750_adapted_schematic.pdf

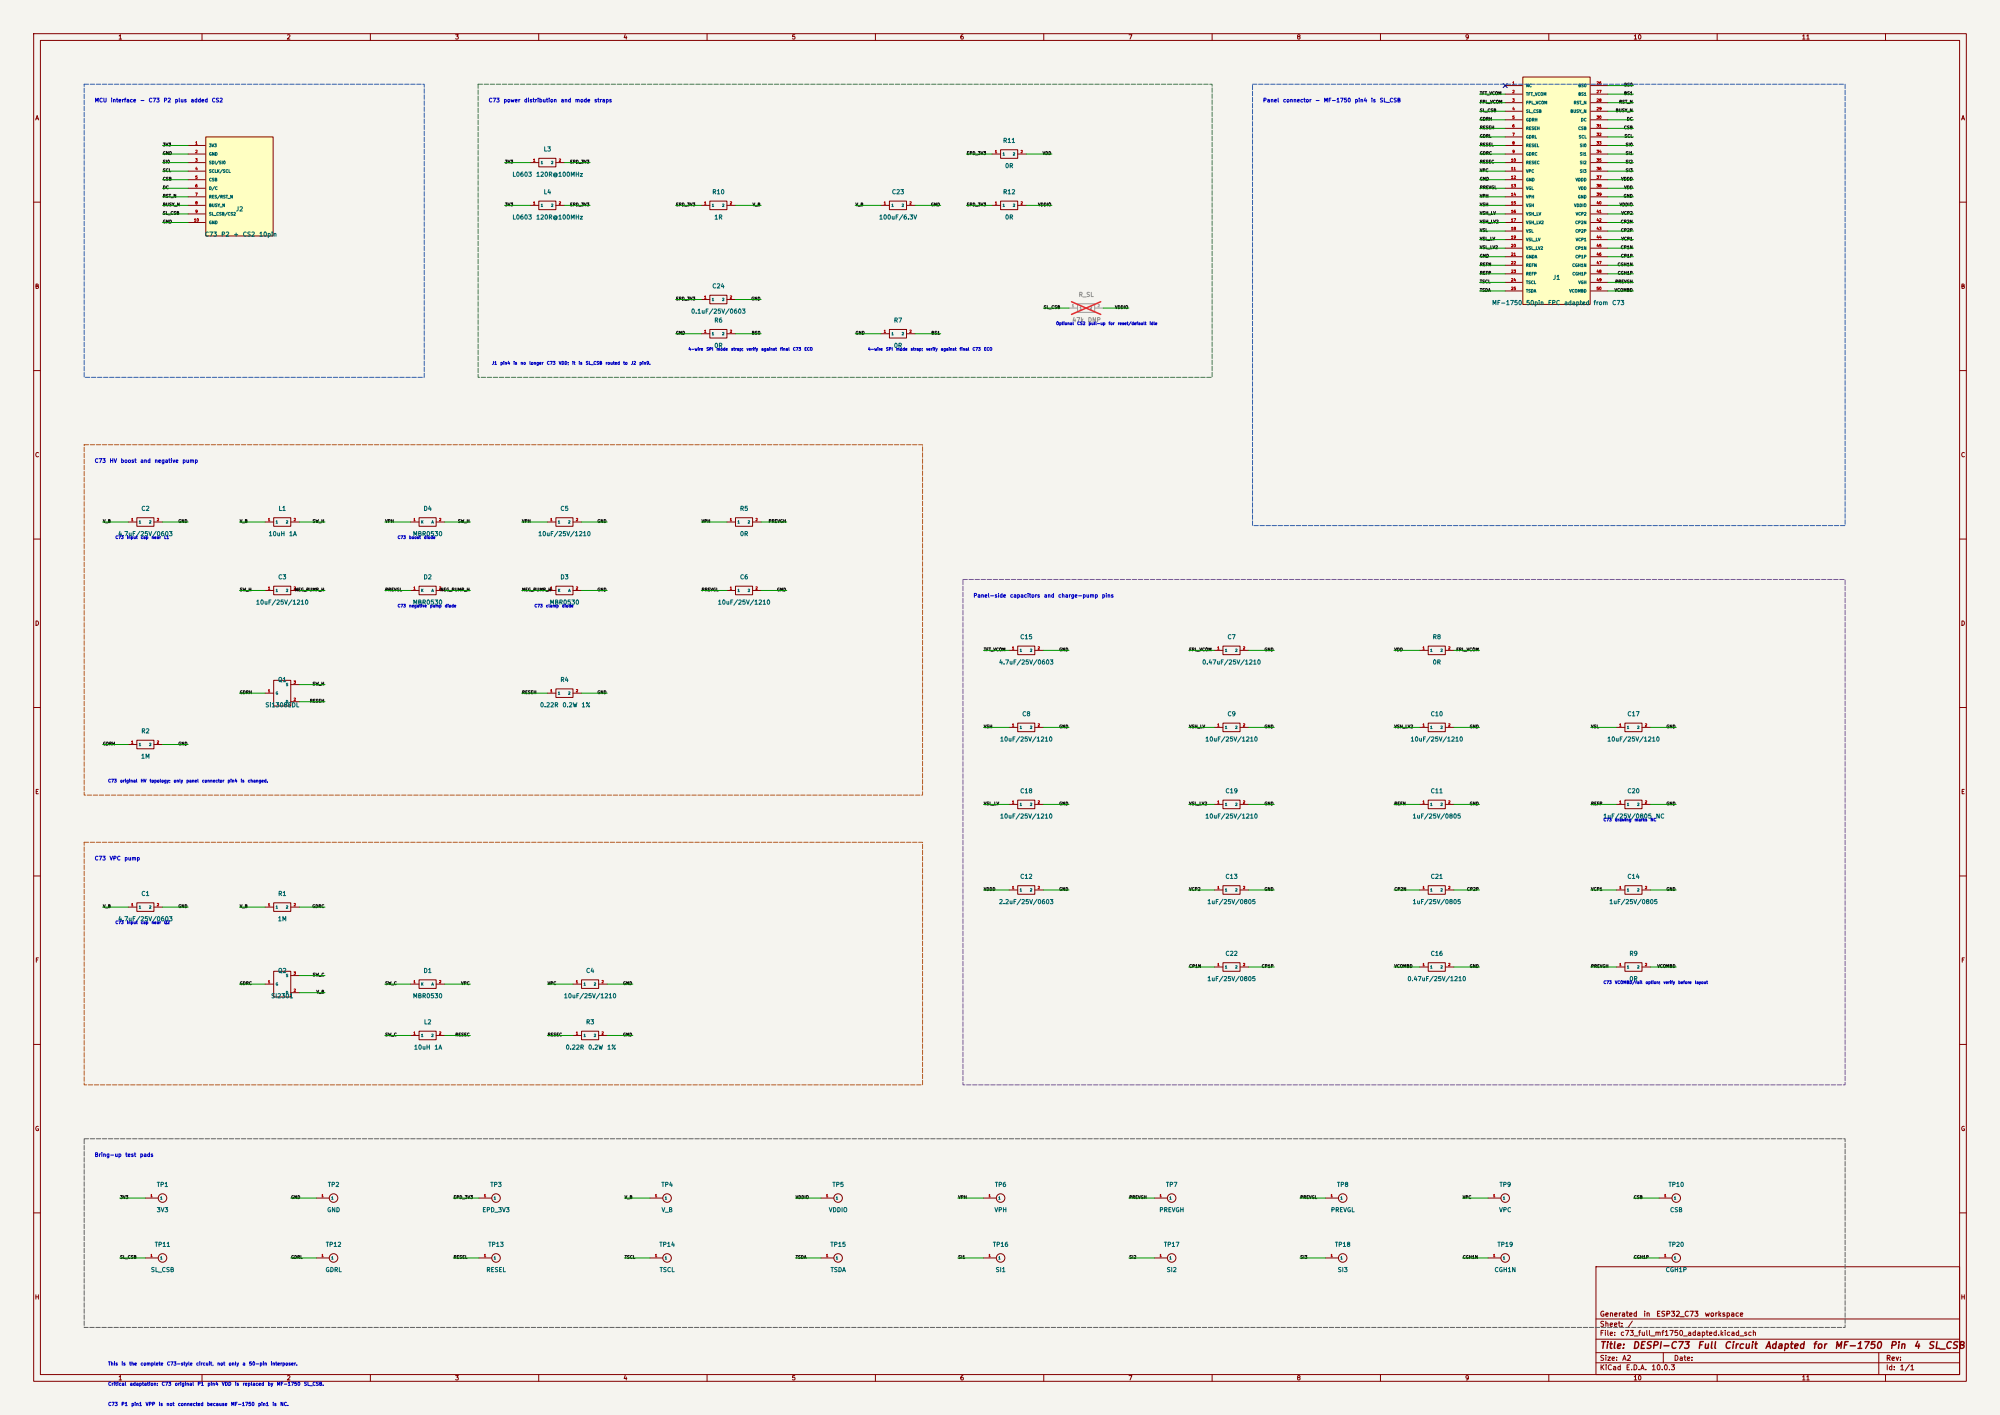
[picture p57: page 1]

MCU interface - C73 P2 plus added CS2

J1 pin4 is no longer C73 VDD; it is SL_CSB routed to J2 pin9. C73 power distribution and mode straps

Panel connector - MF-1750 pin4 is SL_CSB

Optional CS2 pull-up for reset/default idle 4-wire SPI mode strap; verify against final C73 ECO

4-wire SPI mode strap; verify against final C73 ECO Panel-side capacitors and charge-pump pins C73 HV boost and negative pump

C73 VCOMBD/rail option; verify before layout C73 drawing marks NC

Bring-up test pads

Generated in ESP32_C73 workspace
Sheet: /

File: c73_full_mf1750_adapted.kicad_sch
Title: DESPI-C73 Full Circuit Adapted for MF-1750 Pin 4 SL_CSB

Size: A2 | Rev:
KiCad E.D.A. 10.0.3 | Id: 1/1

This is the complete C73-style circuit, not only a 50-pin interposer. Critical adaptation: C73 original P1 pin4 VDD is replaced by MF-1750 SL_CSB. C73 P1 pin1 VPP is not connected because MF-1750 pin1 is NC. Subsystem boxes are intentional: interface, power, HV pump, VPC pump, panel caps, test pads. Before layout, verify J1 contact side, pin-1 direction, diode polarity, and BS0/BS1 straps.
