oceanye/ESP32_C73-MF1750/hardware/mf1750_full_driver_kicad/mf1750_full_driver_schematic.pdf

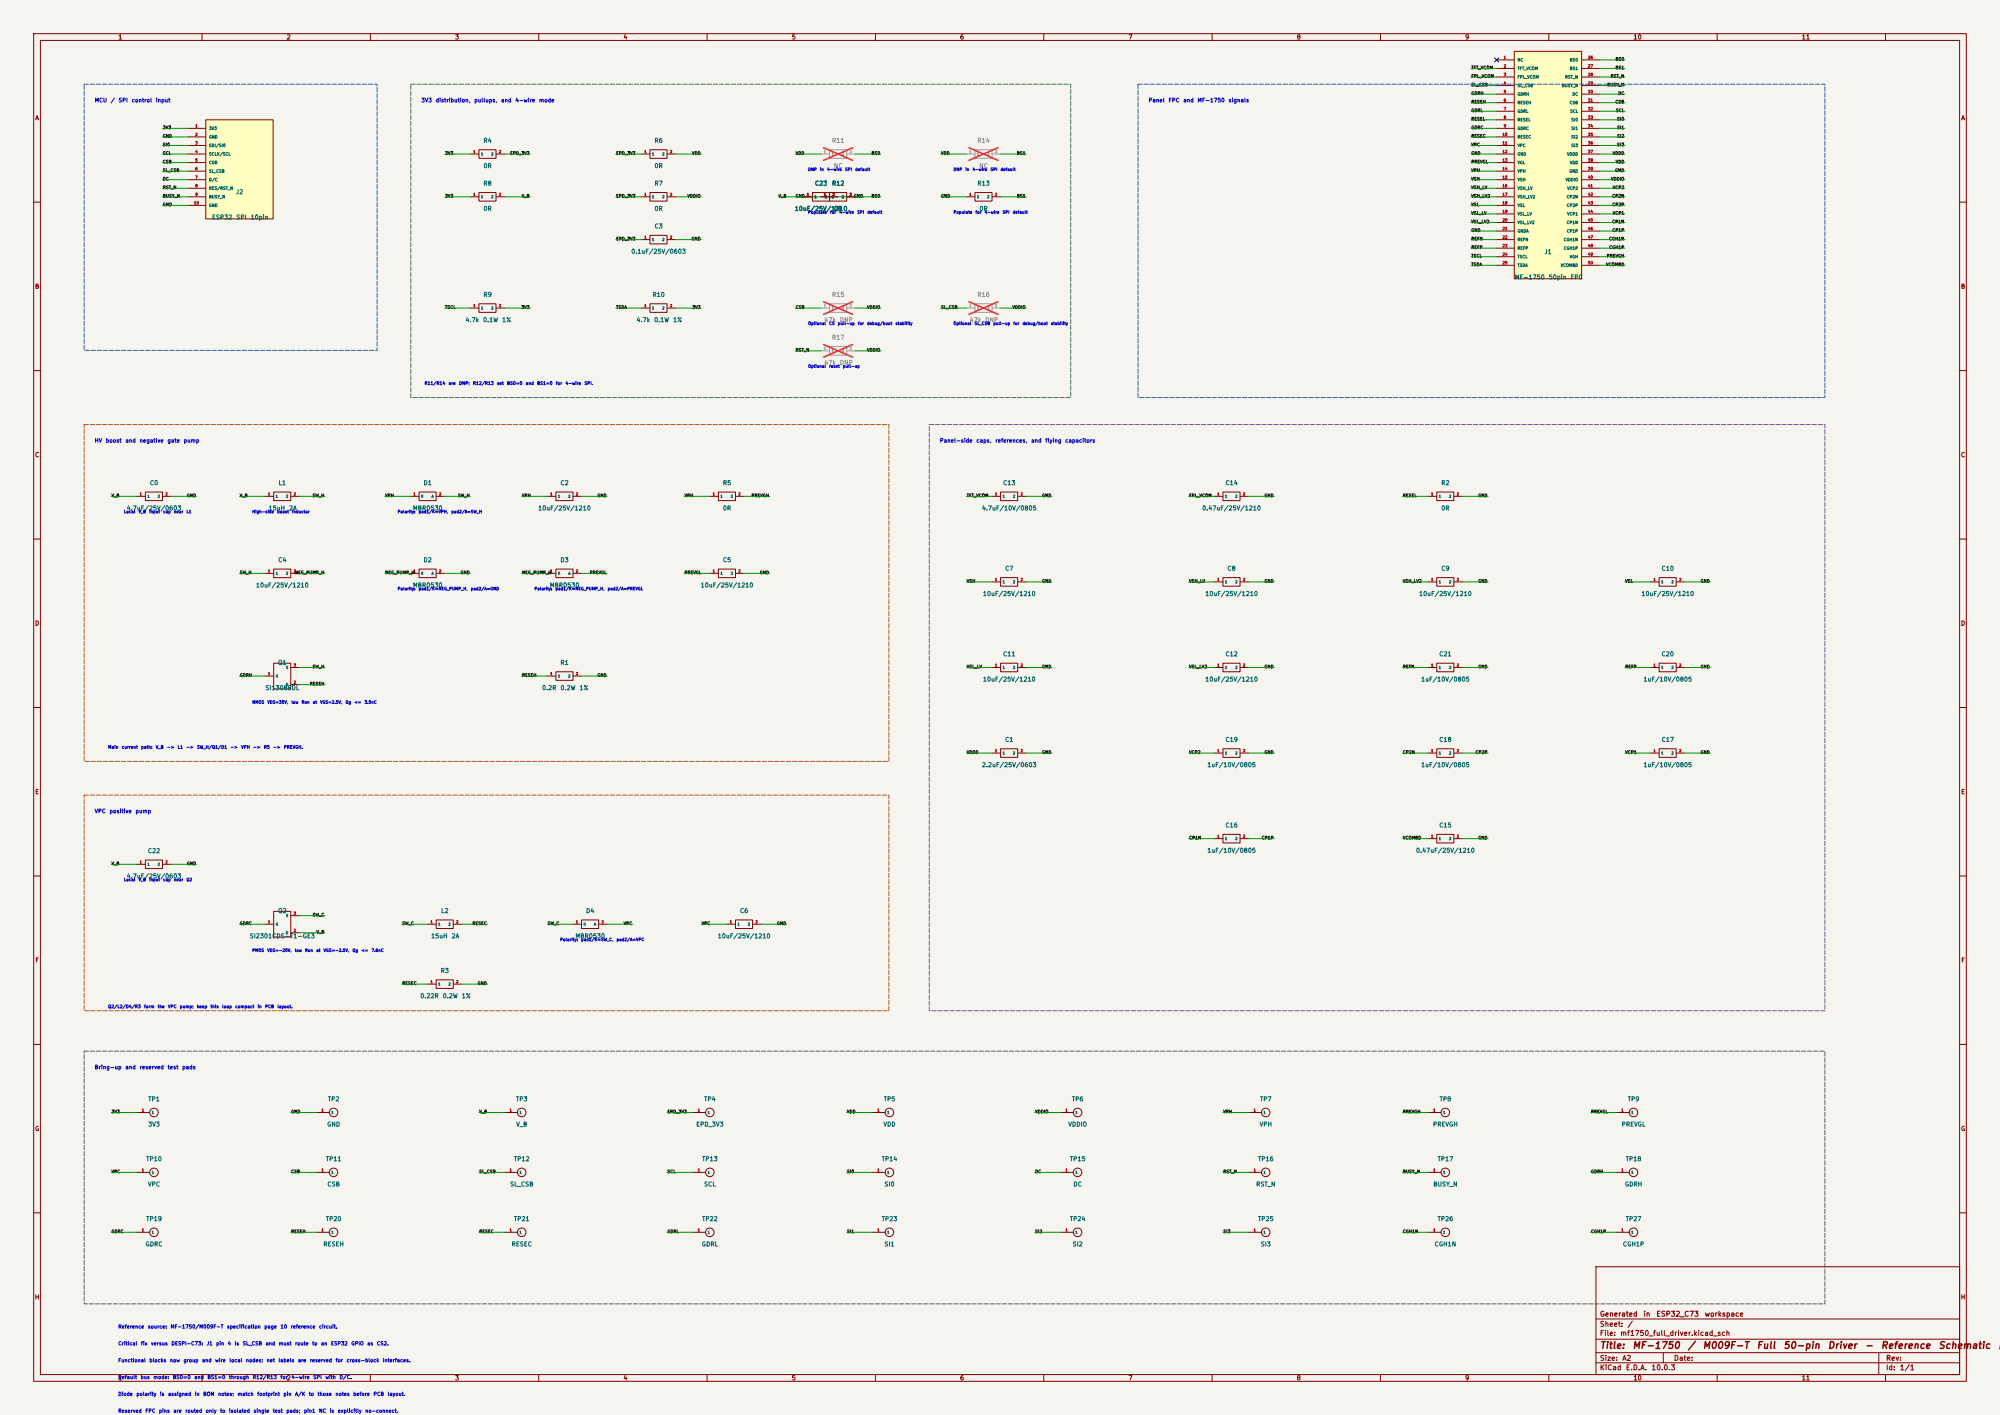
[picture p58: page 1]

DNP in 4-wire SPI default

Optional reset pull-up Populate for 4-wire SPI default High-side boost inductor HV boost and negative gate pump

Local V_B input cap near L1

Reference source: MF-1750/M009F-T specification page 10 reference circuit. Bring-up and reserved test pads

Generated in ESP32_C73 workspace
Sheet: /
File: mf1750_full_driver.kicad_sch
Title: MF-1750 / M009F-T Full 50-pin Driver - Reference Schematic Draft

Size: A2 | Rev:
KiCad E.D.A. 10.0.3 | Id: 1/1

Functional blocks now group and wire local nodes; net labels are reserved for cross-block interfaces. Diode polarity is assigned in BOM notes; match footprint pin A/K to those notes before PCB layout.
