oceanye/ESP32_C73-MF1750/hardware/mf1750_devkitc_b1_jlcpcb/support/schematic.pdf

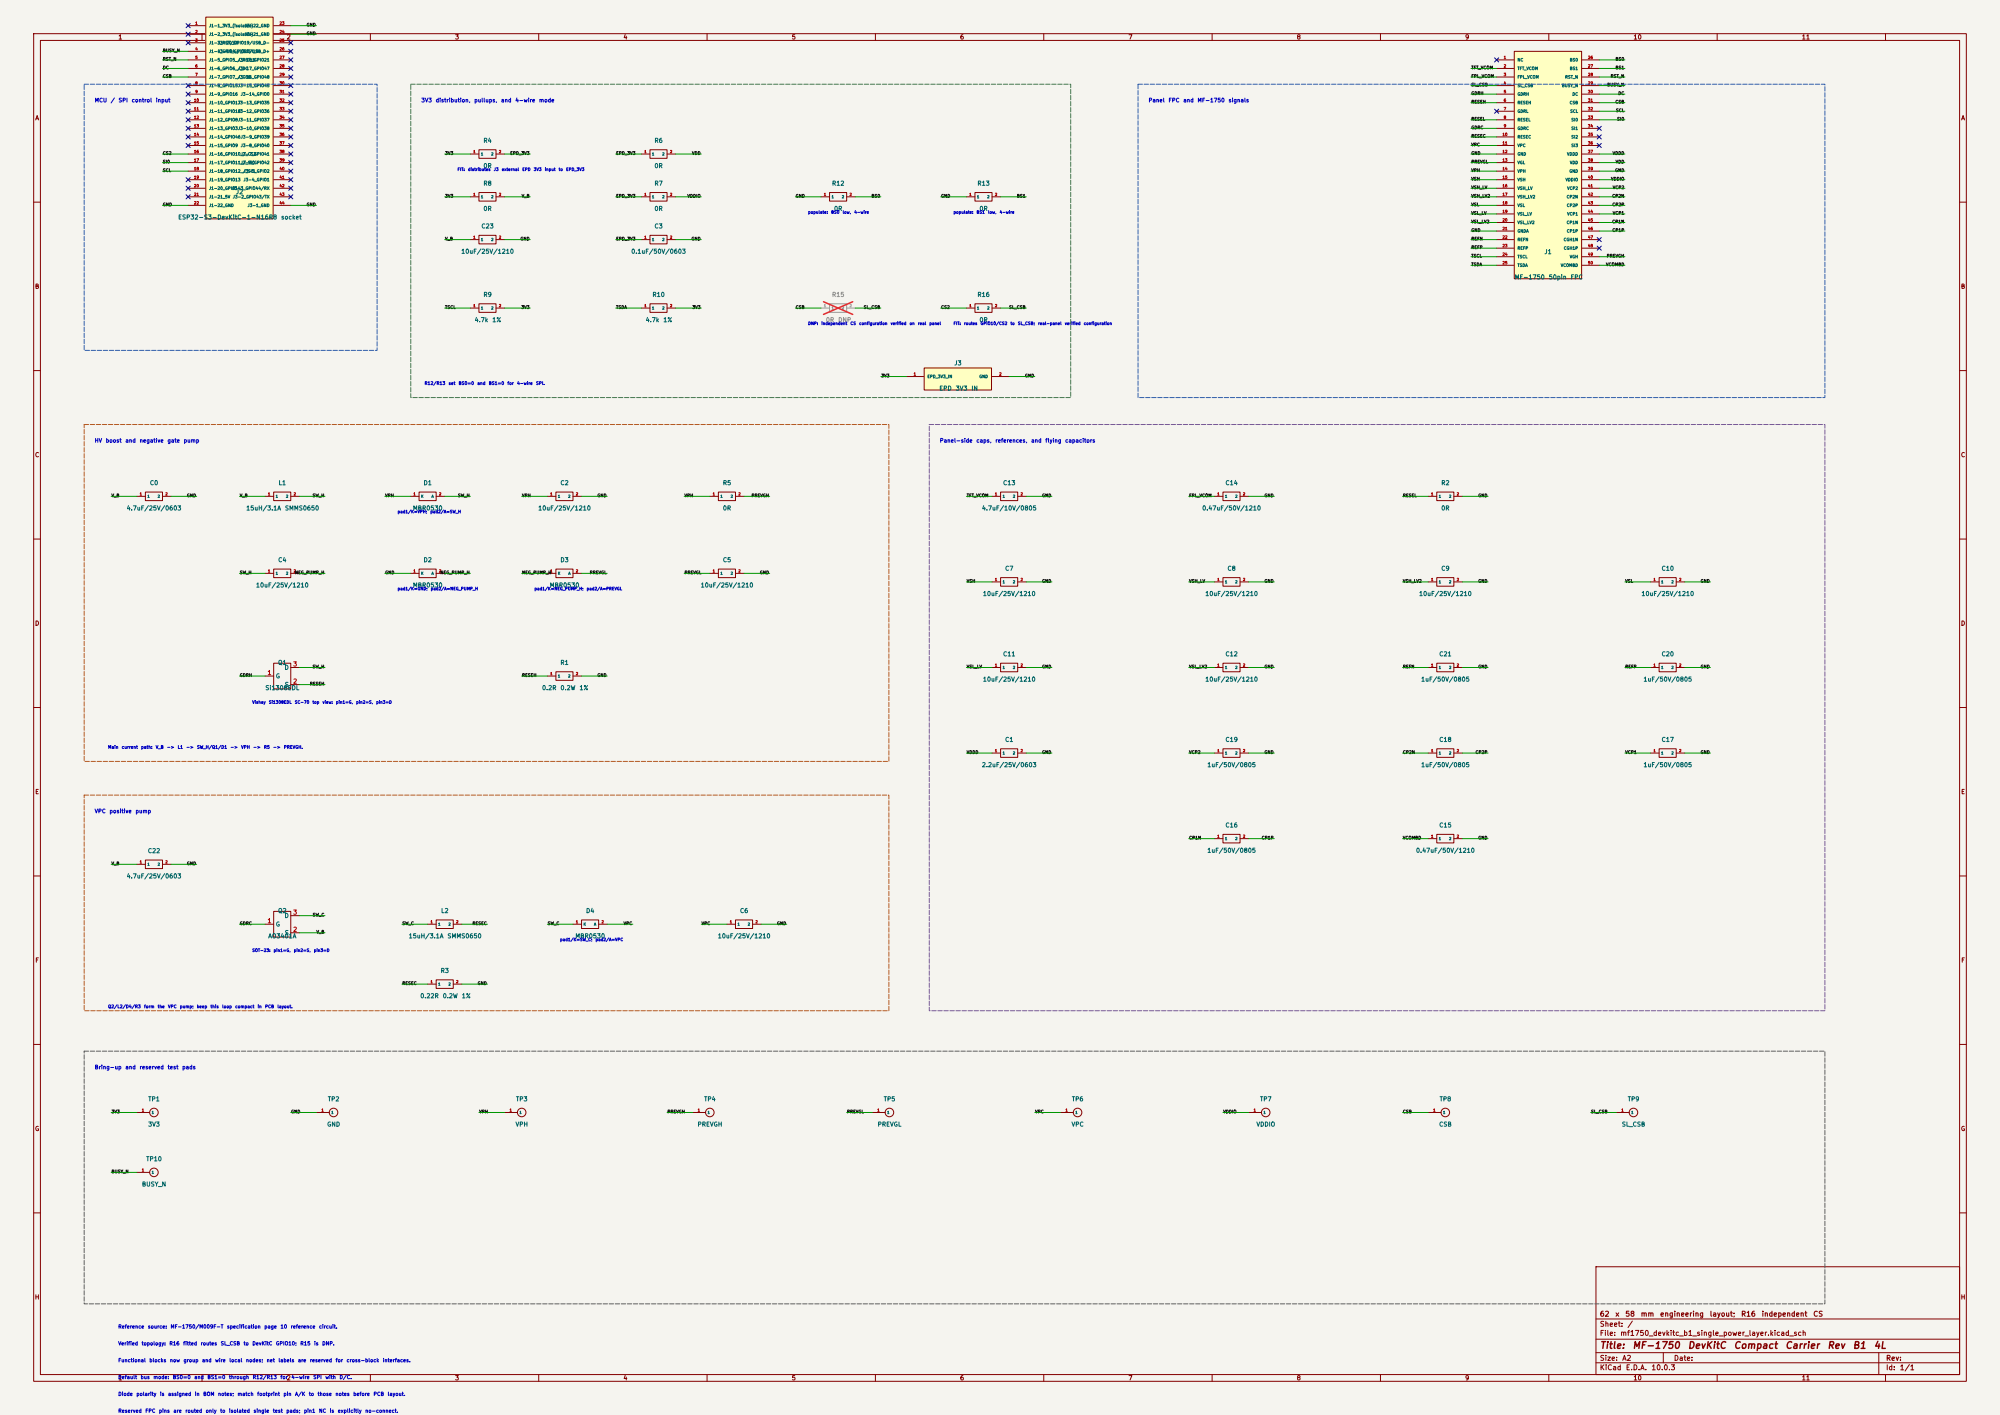
[picture p59: page 1]

Panel FPC and MF-1750 signals

FIT: distributes J3 external EPD 3V3 input to EPD_3V3

DNP: independent CS configuration verified on real panel pad1/K=GND; pad2/A=NEG_PUMP_H

FIT: routes GPIO10/CS2 to SL_CSB; real-panel verified configuration

Panel-side caps, references, and flying capacitors

Vishay Si1308EDL SC-70 top view: pin1=G, pin2=S, pin3=D

Main current path: V_B -> L1 -> SW_H/Q1/D1 -> VPH -> R5 -> PREVGH.

Bring-up and reserved test pads Q2/L2/D4/R3 form the VPC pump; keep this loop compact in PCB layout.

62 x 58 mm engineering layout; R16 independent CS
Sheet: /
File: mf1750_devkitc_b1_single_power_layer.kicad_sch
Title: MF-1750 DevKitC Compact Carrier Rev B1 4L

Verified topology: R16 fitted routes SL_CSB to DevKitC GPIO10; R15 is DNP. Functional blocks now group and wire local nodes; net labels are reserved for cross-block interfaces. Default bus mode: BS0=0 and BS1=0 through R12/R13 for 4-wire SPI with D/C. Diode polarity is assigned in BOM notes; match footprint pin A/K to those notes before PCB layout. Reserved FPC pins are routed only to isolated single test pads; pin1 NC is explicitly no-connect. Footprints are intentionally mostly blank; assign real packages and ratings in KiCad before layout. GPIO7 drives CSB and GPIO10 independently drives SL_CSB; never fit R15 and R16 together. Reference source: MF-1750/M009F-T specification page 10 reference circuit.

Size: A2 | Rev:
KiCad E.D.A. 10.0.3 | Id: 1/1
