oceanye/ESP32_C73-MF1750/参考资料/55-00300-04736-N-InkCubic_ E2802_cascade 电子纸E6转接板.pdf

# BACD

6

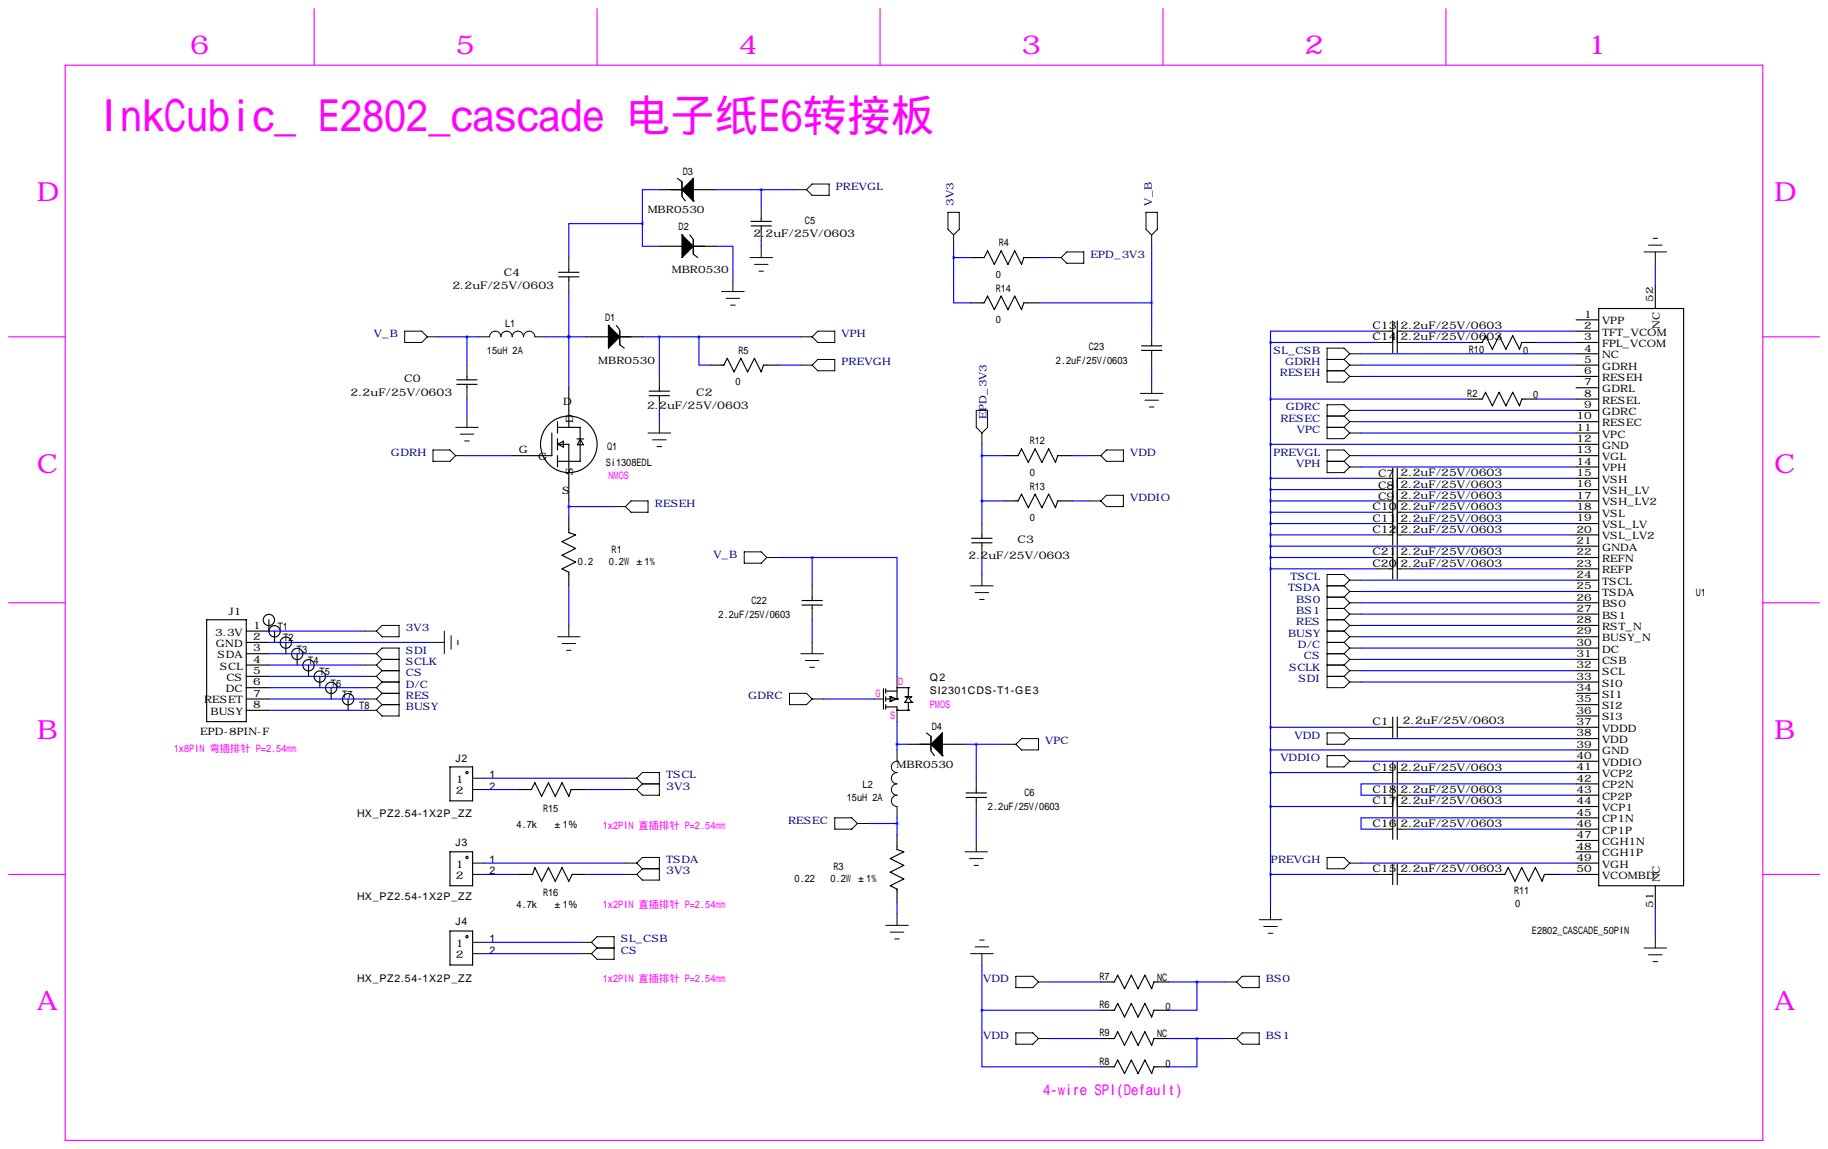
[picture p60: page 1]

C8 | 2.2uF/25V/0603 | VSH 16
C9 | 2.2uF/25V/0603 | VSH_LV 17
C10 | 2.2uF/25V/0603 | VSH_LV2 18
C11 | 2.2uF/25V/0603 | VSL 19
C12 | 2.2uF/25V/0603 | VSL_LV 20

C21 | 2.2uF/25V/0603
C20 | 2.2uF/25V/0603 | REFN 23

TSDA BS0 BS1 RES BUSY D/C CS SCLK SDI | | REFP 24

PREVGH | | VCP1 45
