oceanye/ESP32_C73-MF1750/hardware/mf1750_devkitc_b1_jlcpcb/support/assembly_bottom_mirrored.pdf

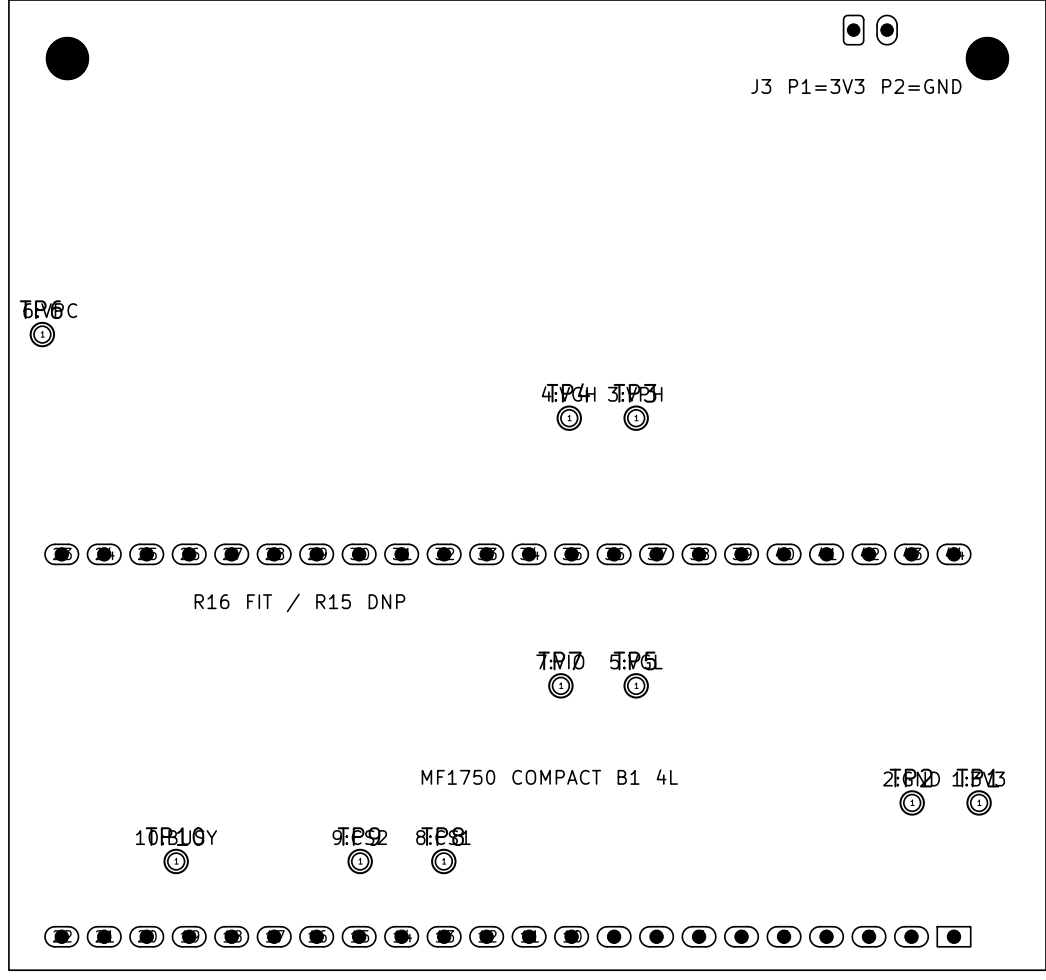
[picture p61: page 1]
