oceanye/ESP32_C73-MF1750/hardware/mf1750_devkitc_b1_jlcpcb/support/assembly_top.pdf

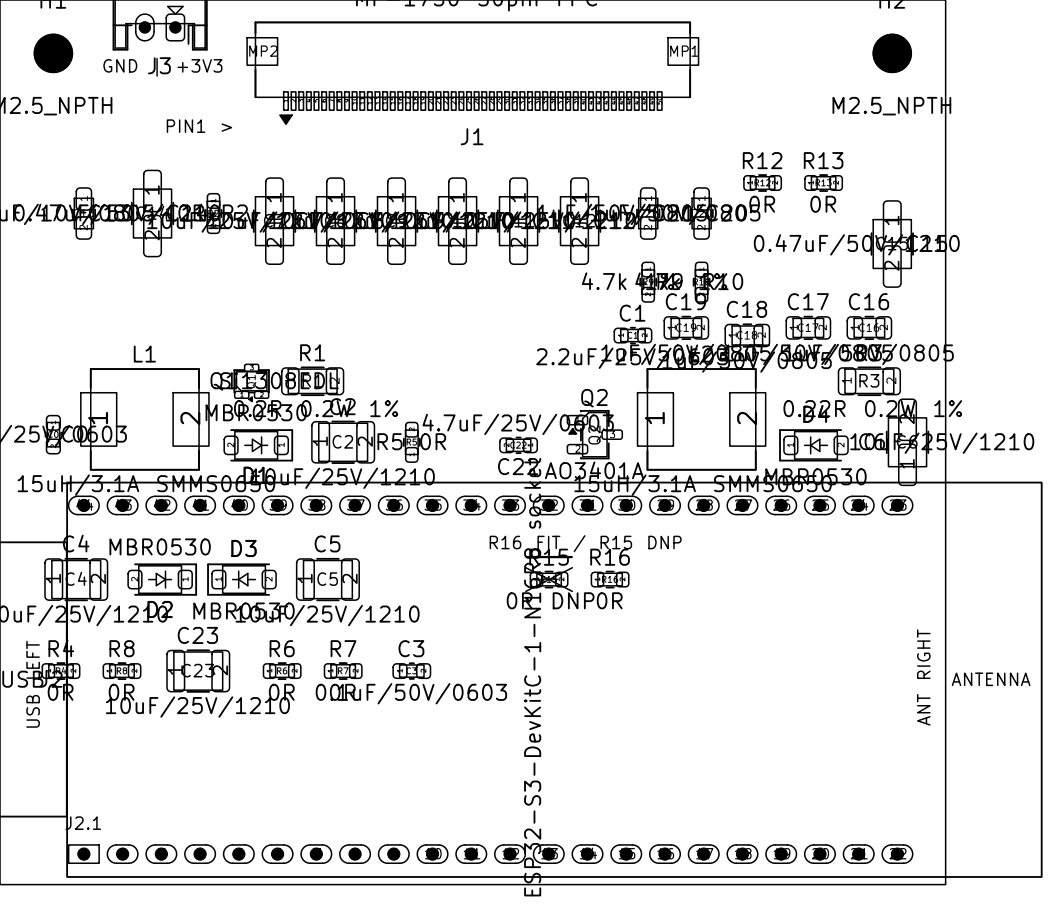
[picture p62: page 1]
