oceanye/ESP32_C73-MF1750/hardware/mf1750_devkitc_b2_jlcpcb/support/assembly_bottom_mirrored.pdf

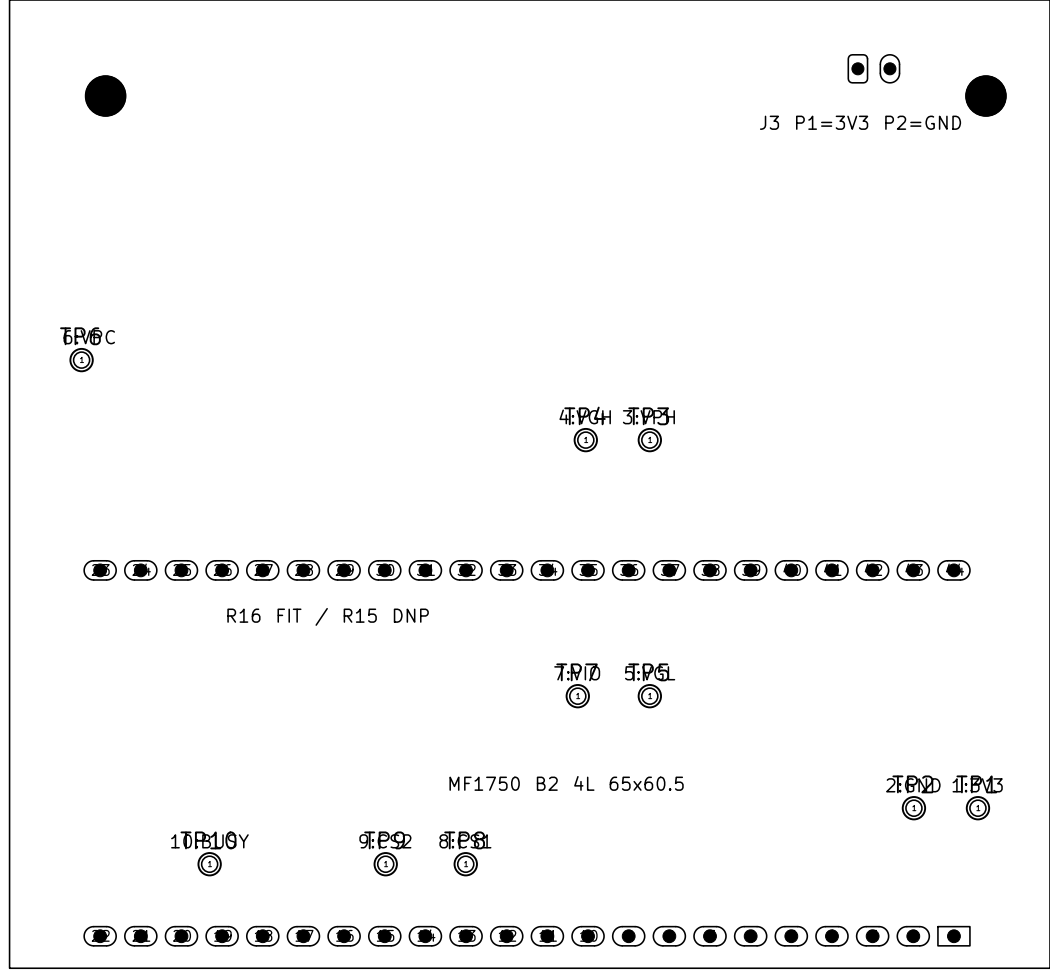
[picture p63: page 1]
