oceanye/ESP32_C73-MF1750/(list of files, drawings)

Other design files:
hardware/mf1750_devkitc_compact/freerouting_seed.dsn
hardware/mf1750_devkitc_compact/resume_seed.dsn
hardware/mf1750_full_driver_kicad/Autorouter_mf1750_jlc_simplified_2026-6-12.dsn
hardware/mf1750_full_driver_kicad/Autorouter_mf1750_jlc_simplified_2026-6-12_autorouted.dsn
hardware/mf1750_production_v1/diag_a.dsn
hardware/mf1750_production_v1/freerouting_seed.dsn
