oceanye/ESP32_C73-MF1750/hardware/mf1750_devkitc_b2_pcba_margin/mf1750_devkitc_b2_pcba_margin.kicad_pcb

## KiCad design hardware/mf1750_devkitc_b2_pcba_margin/mf1750_devkitc_b2_pcba_margin.kicad_pcb (2026-10-10)

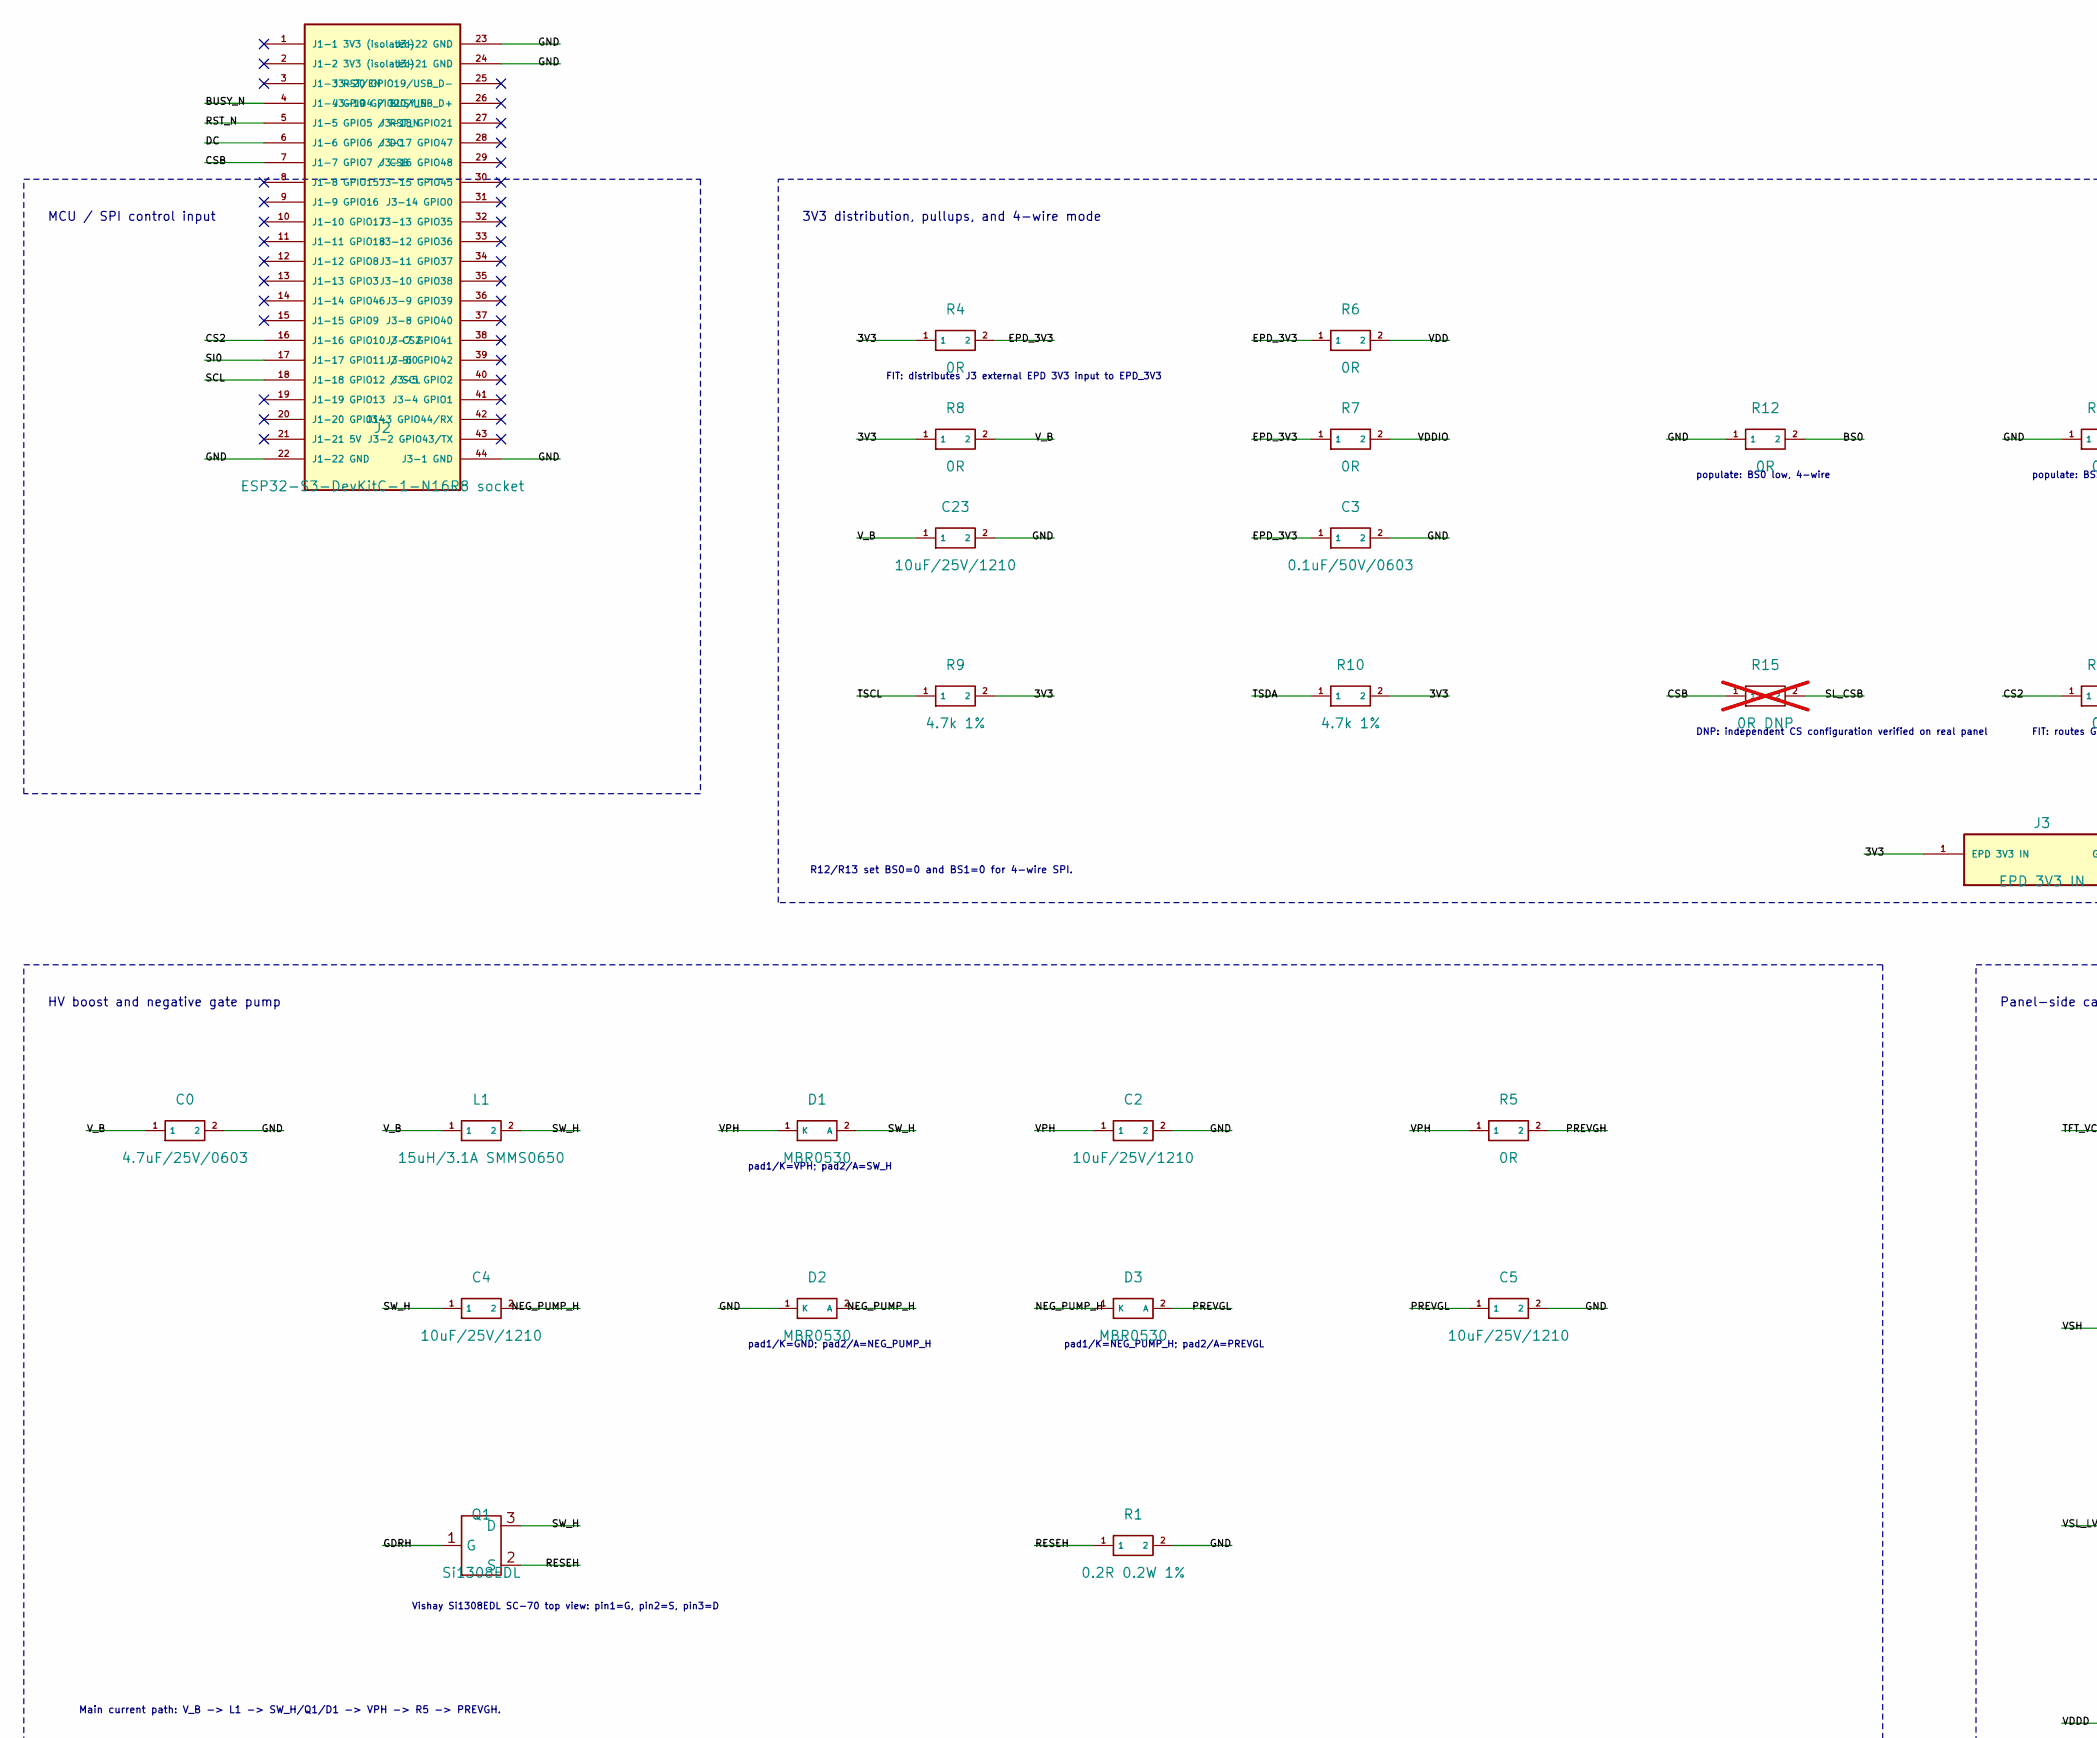
[picture p66: schematic mf1750_devkitc_b2_pcba_margin.kicad_sch, MF-1750 DevKitC Compact Carrier Rev B2 PCBA Edge Margin, part in row 1, column 1]

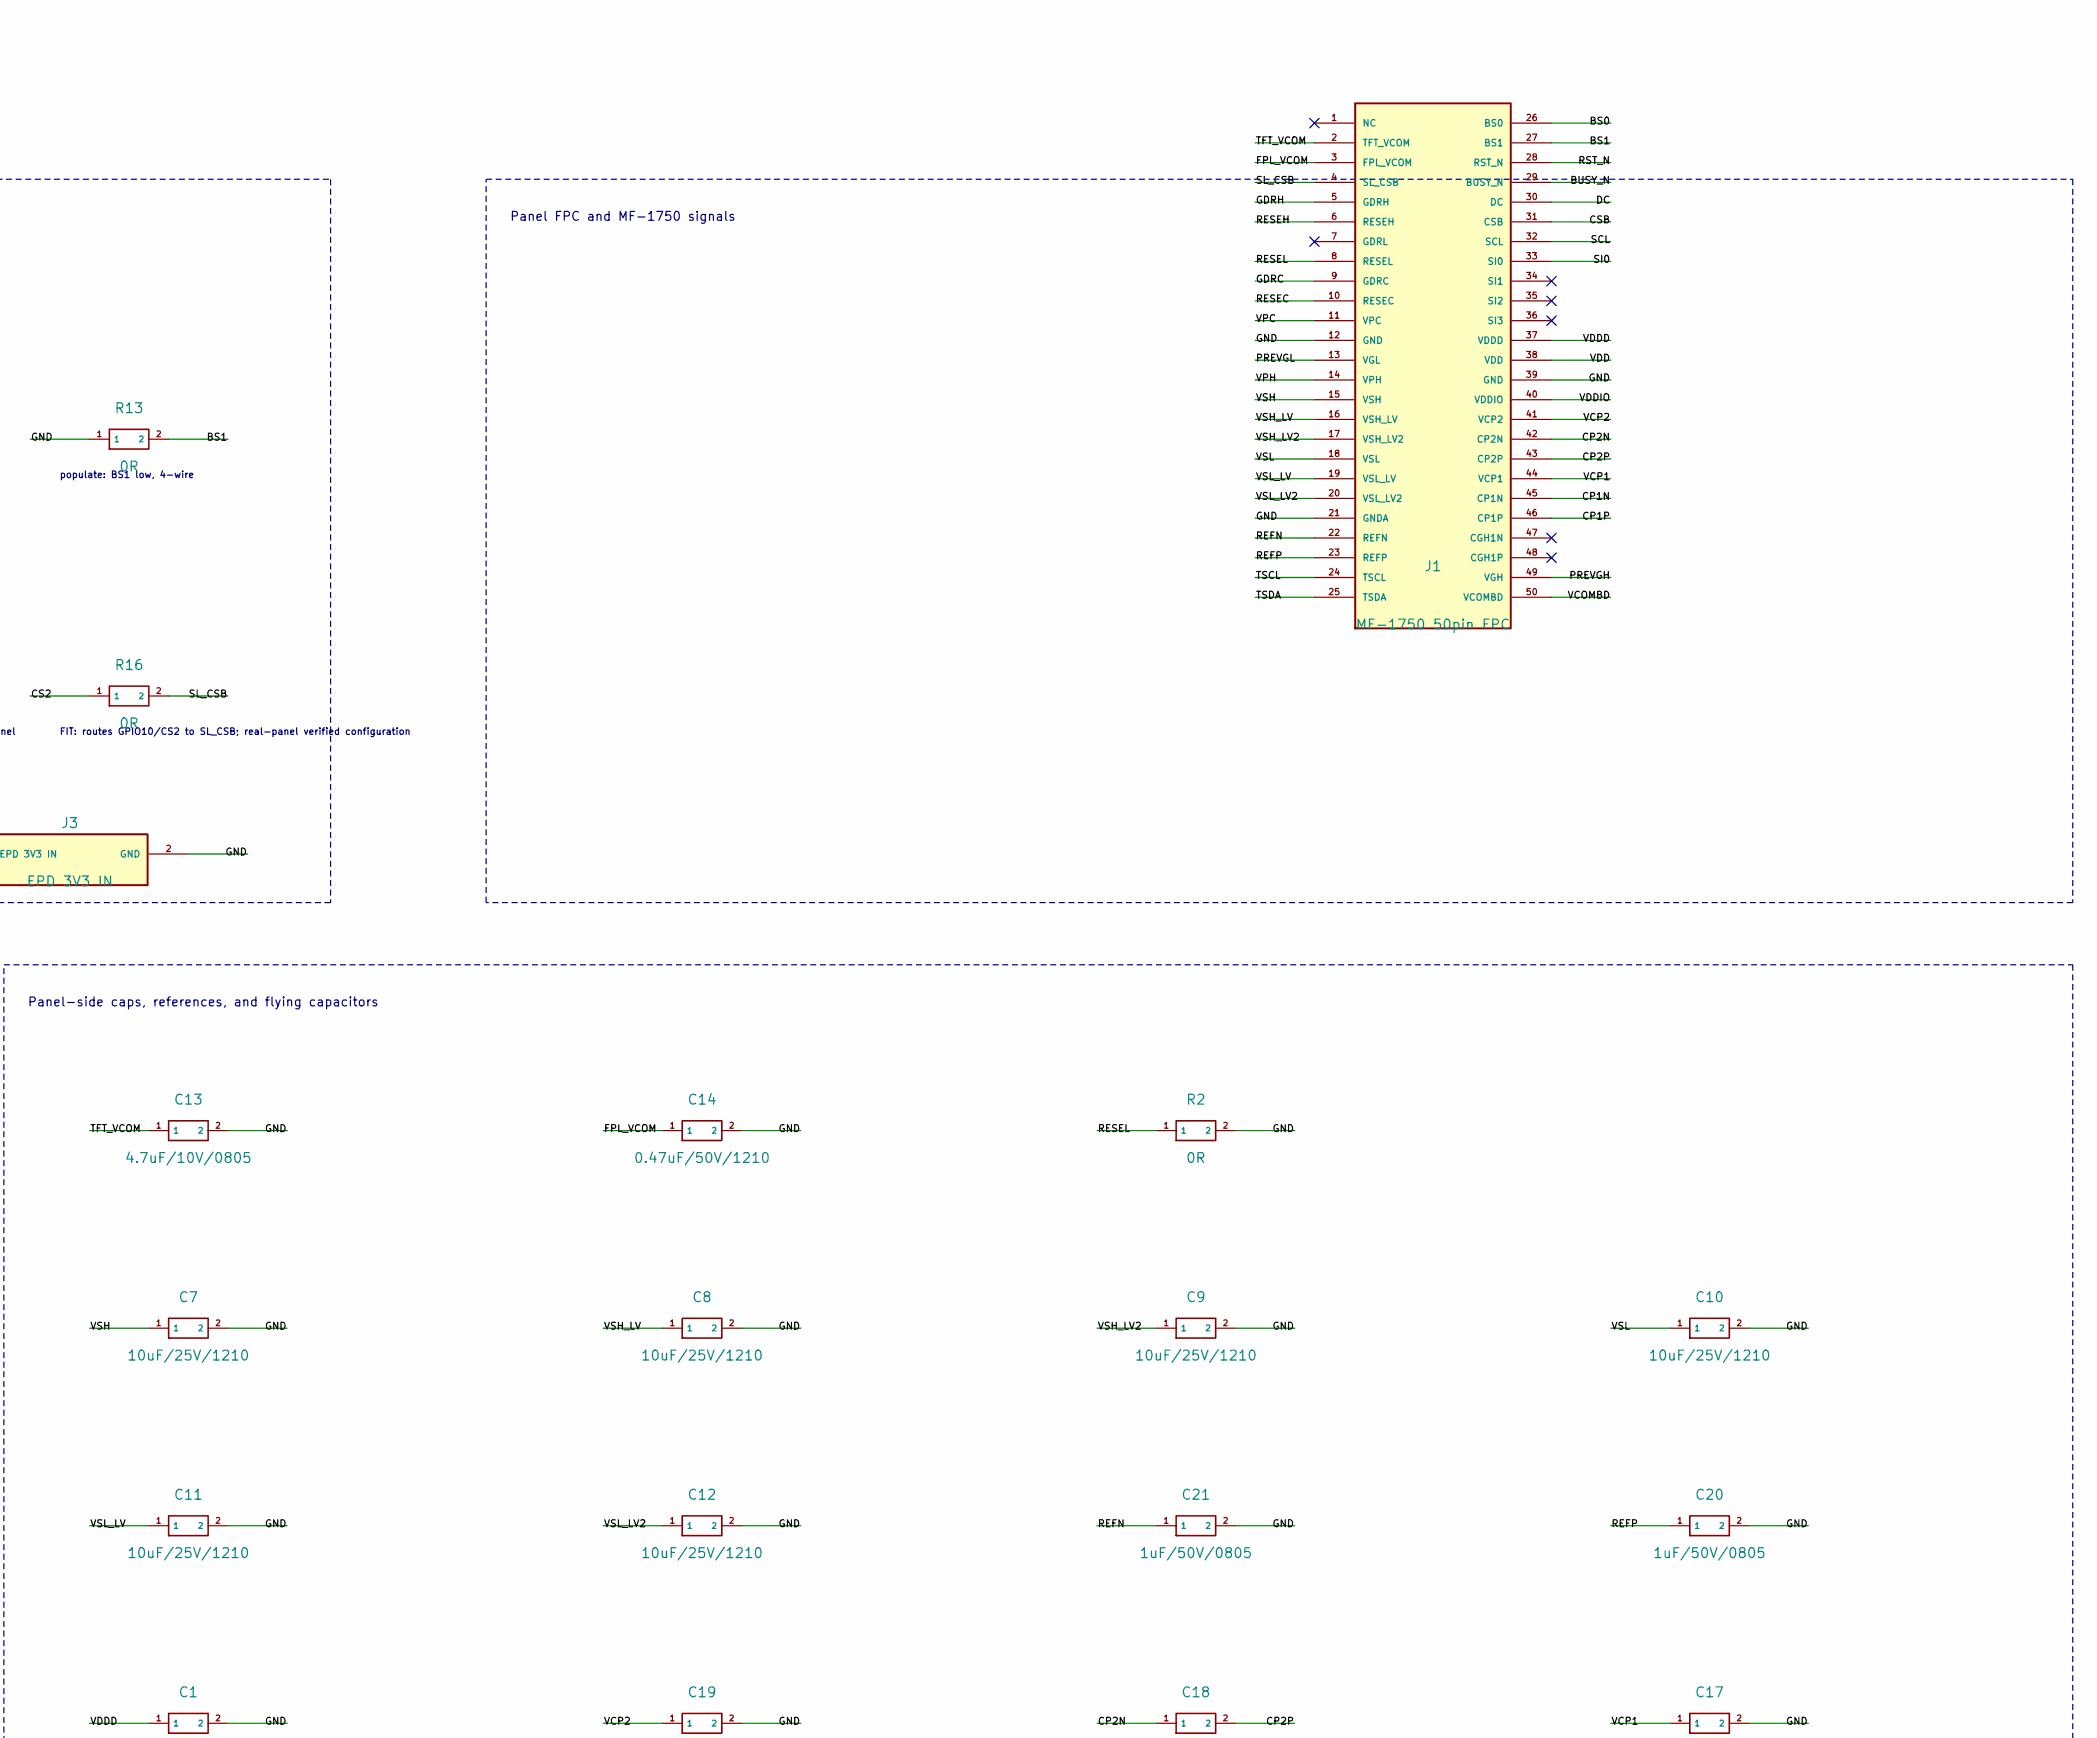
[picture p67: schematic mf1750_devkitc_b2_pcba_margin.kicad_sch, MF-1750 DevKitC Compact Carrier Rev B2 PCBA Edge Margin, part in row 1, column 2]

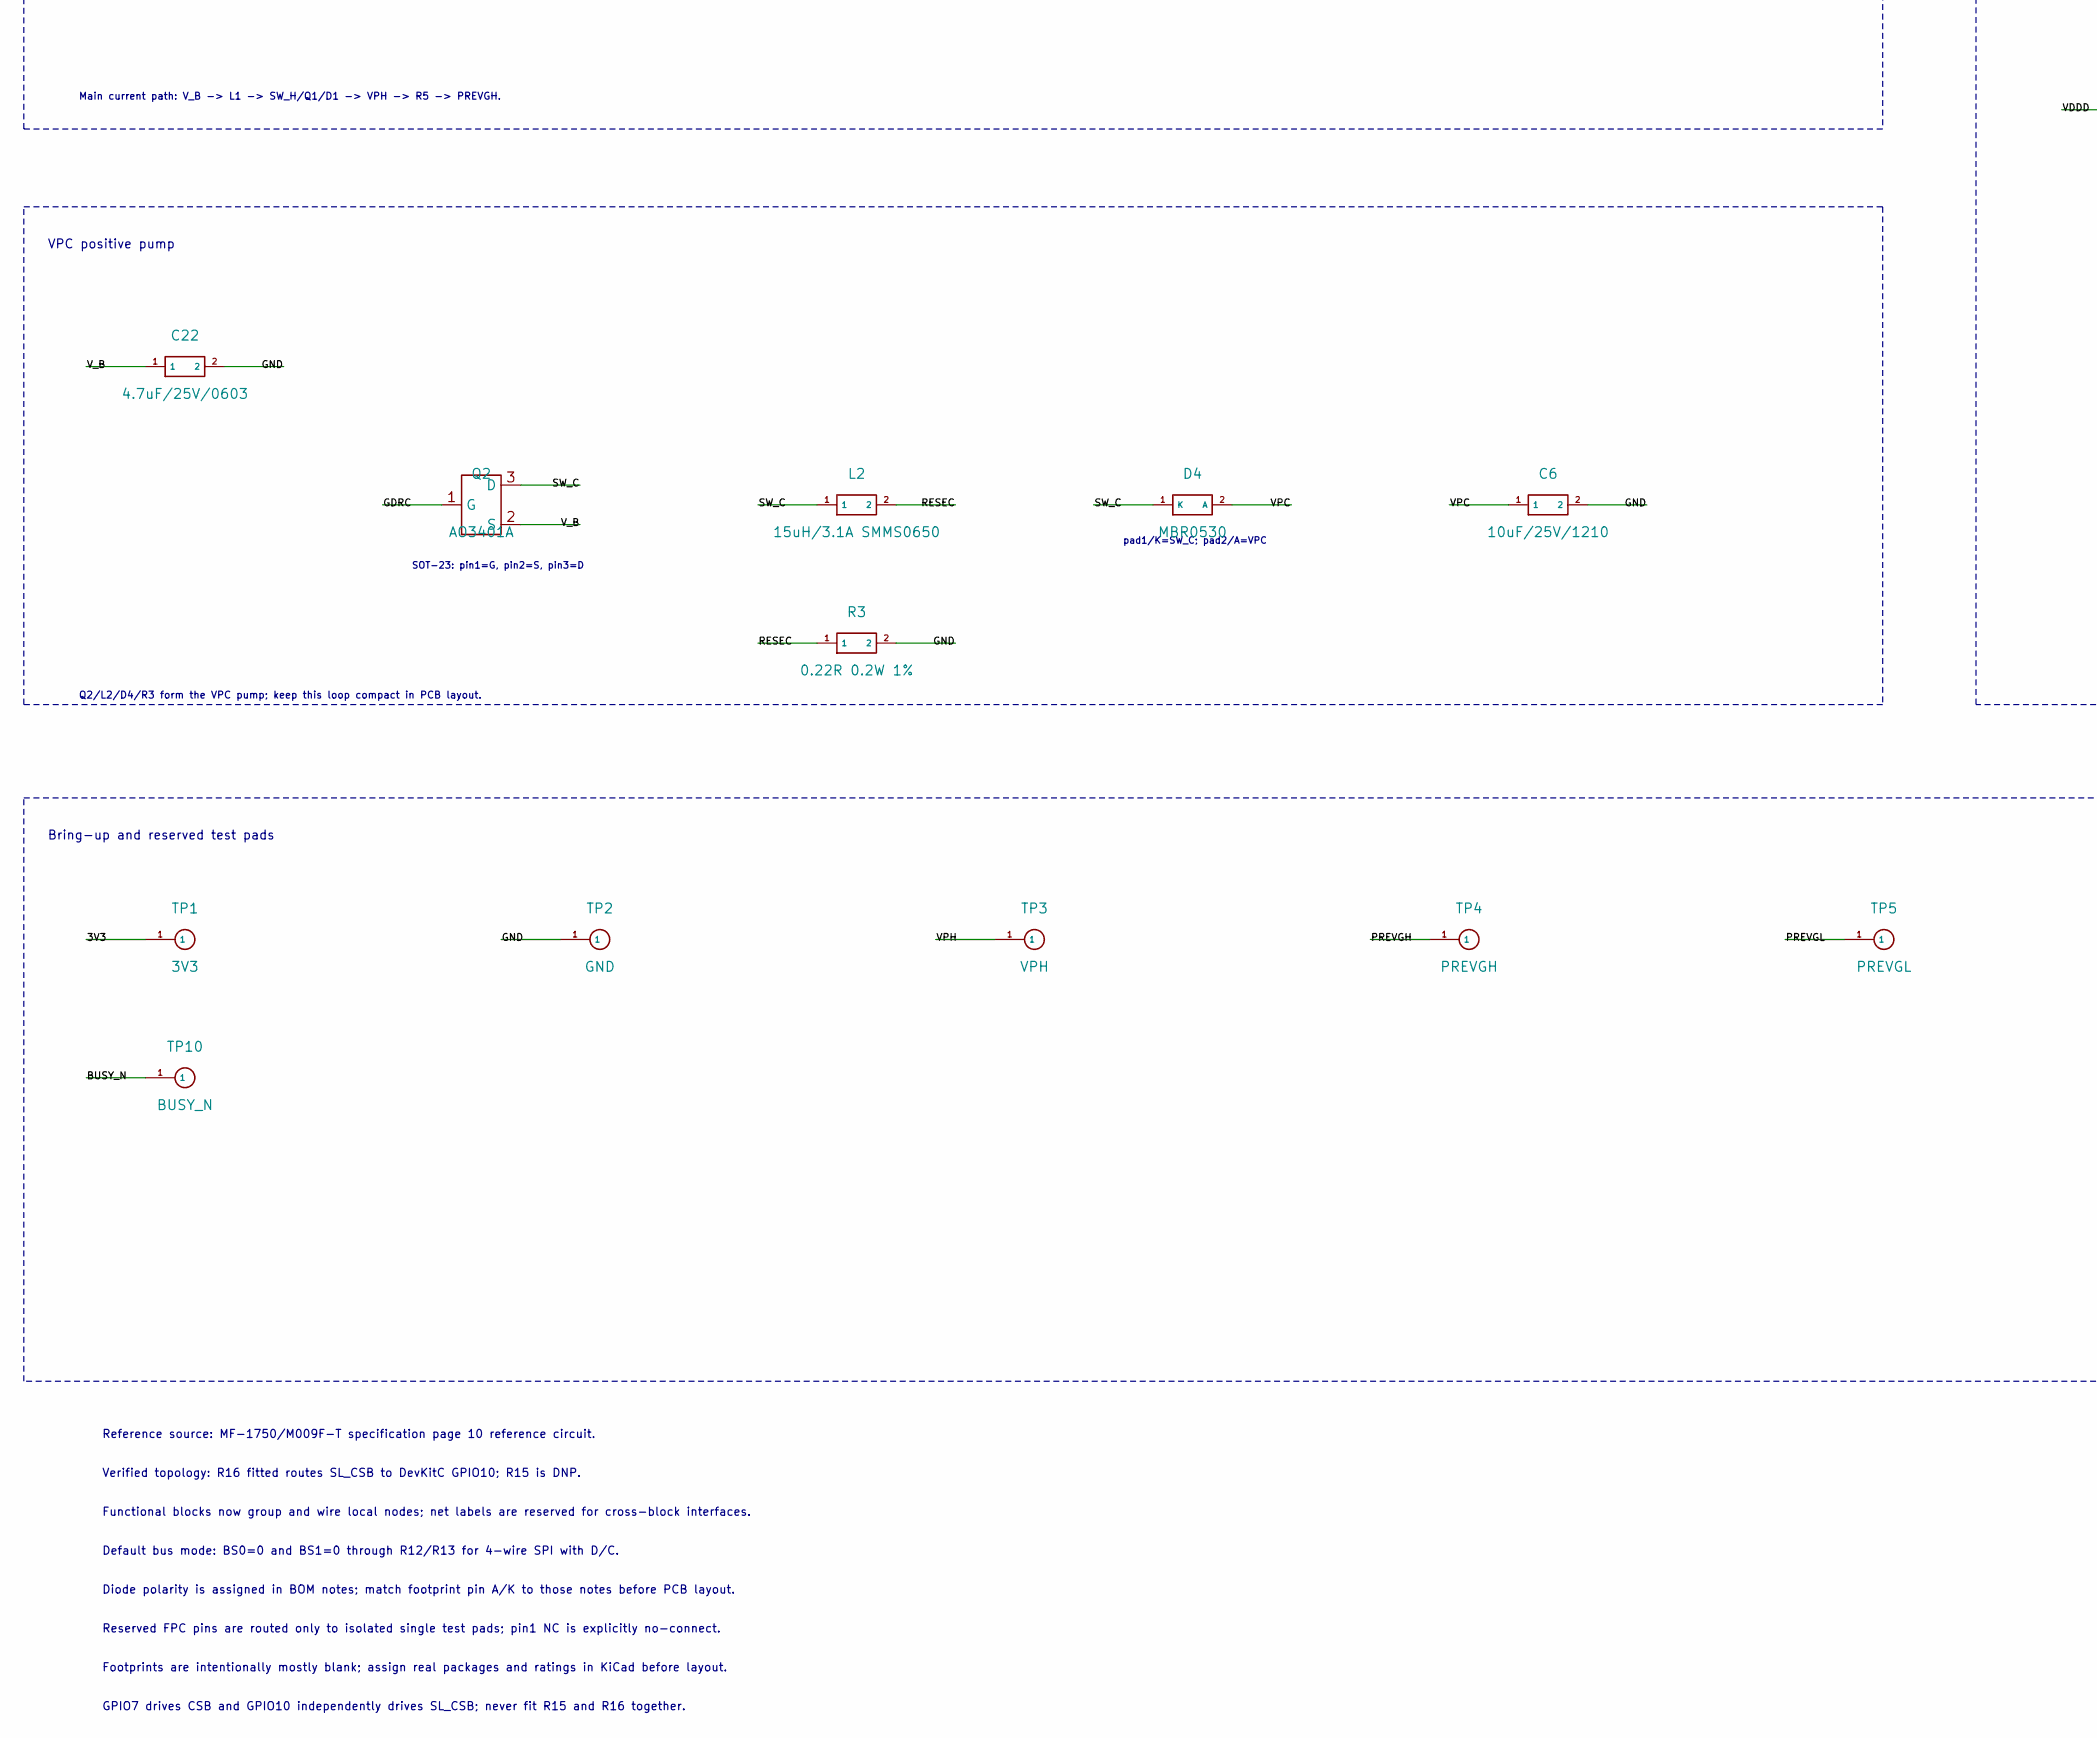
[picture p68: schematic mf1750_devkitc_b2_pcba_margin.kicad_sch, MF-1750 DevKitC Compact Carrier Rev B2 PCBA Edge Margin, part in row 2, column 1]

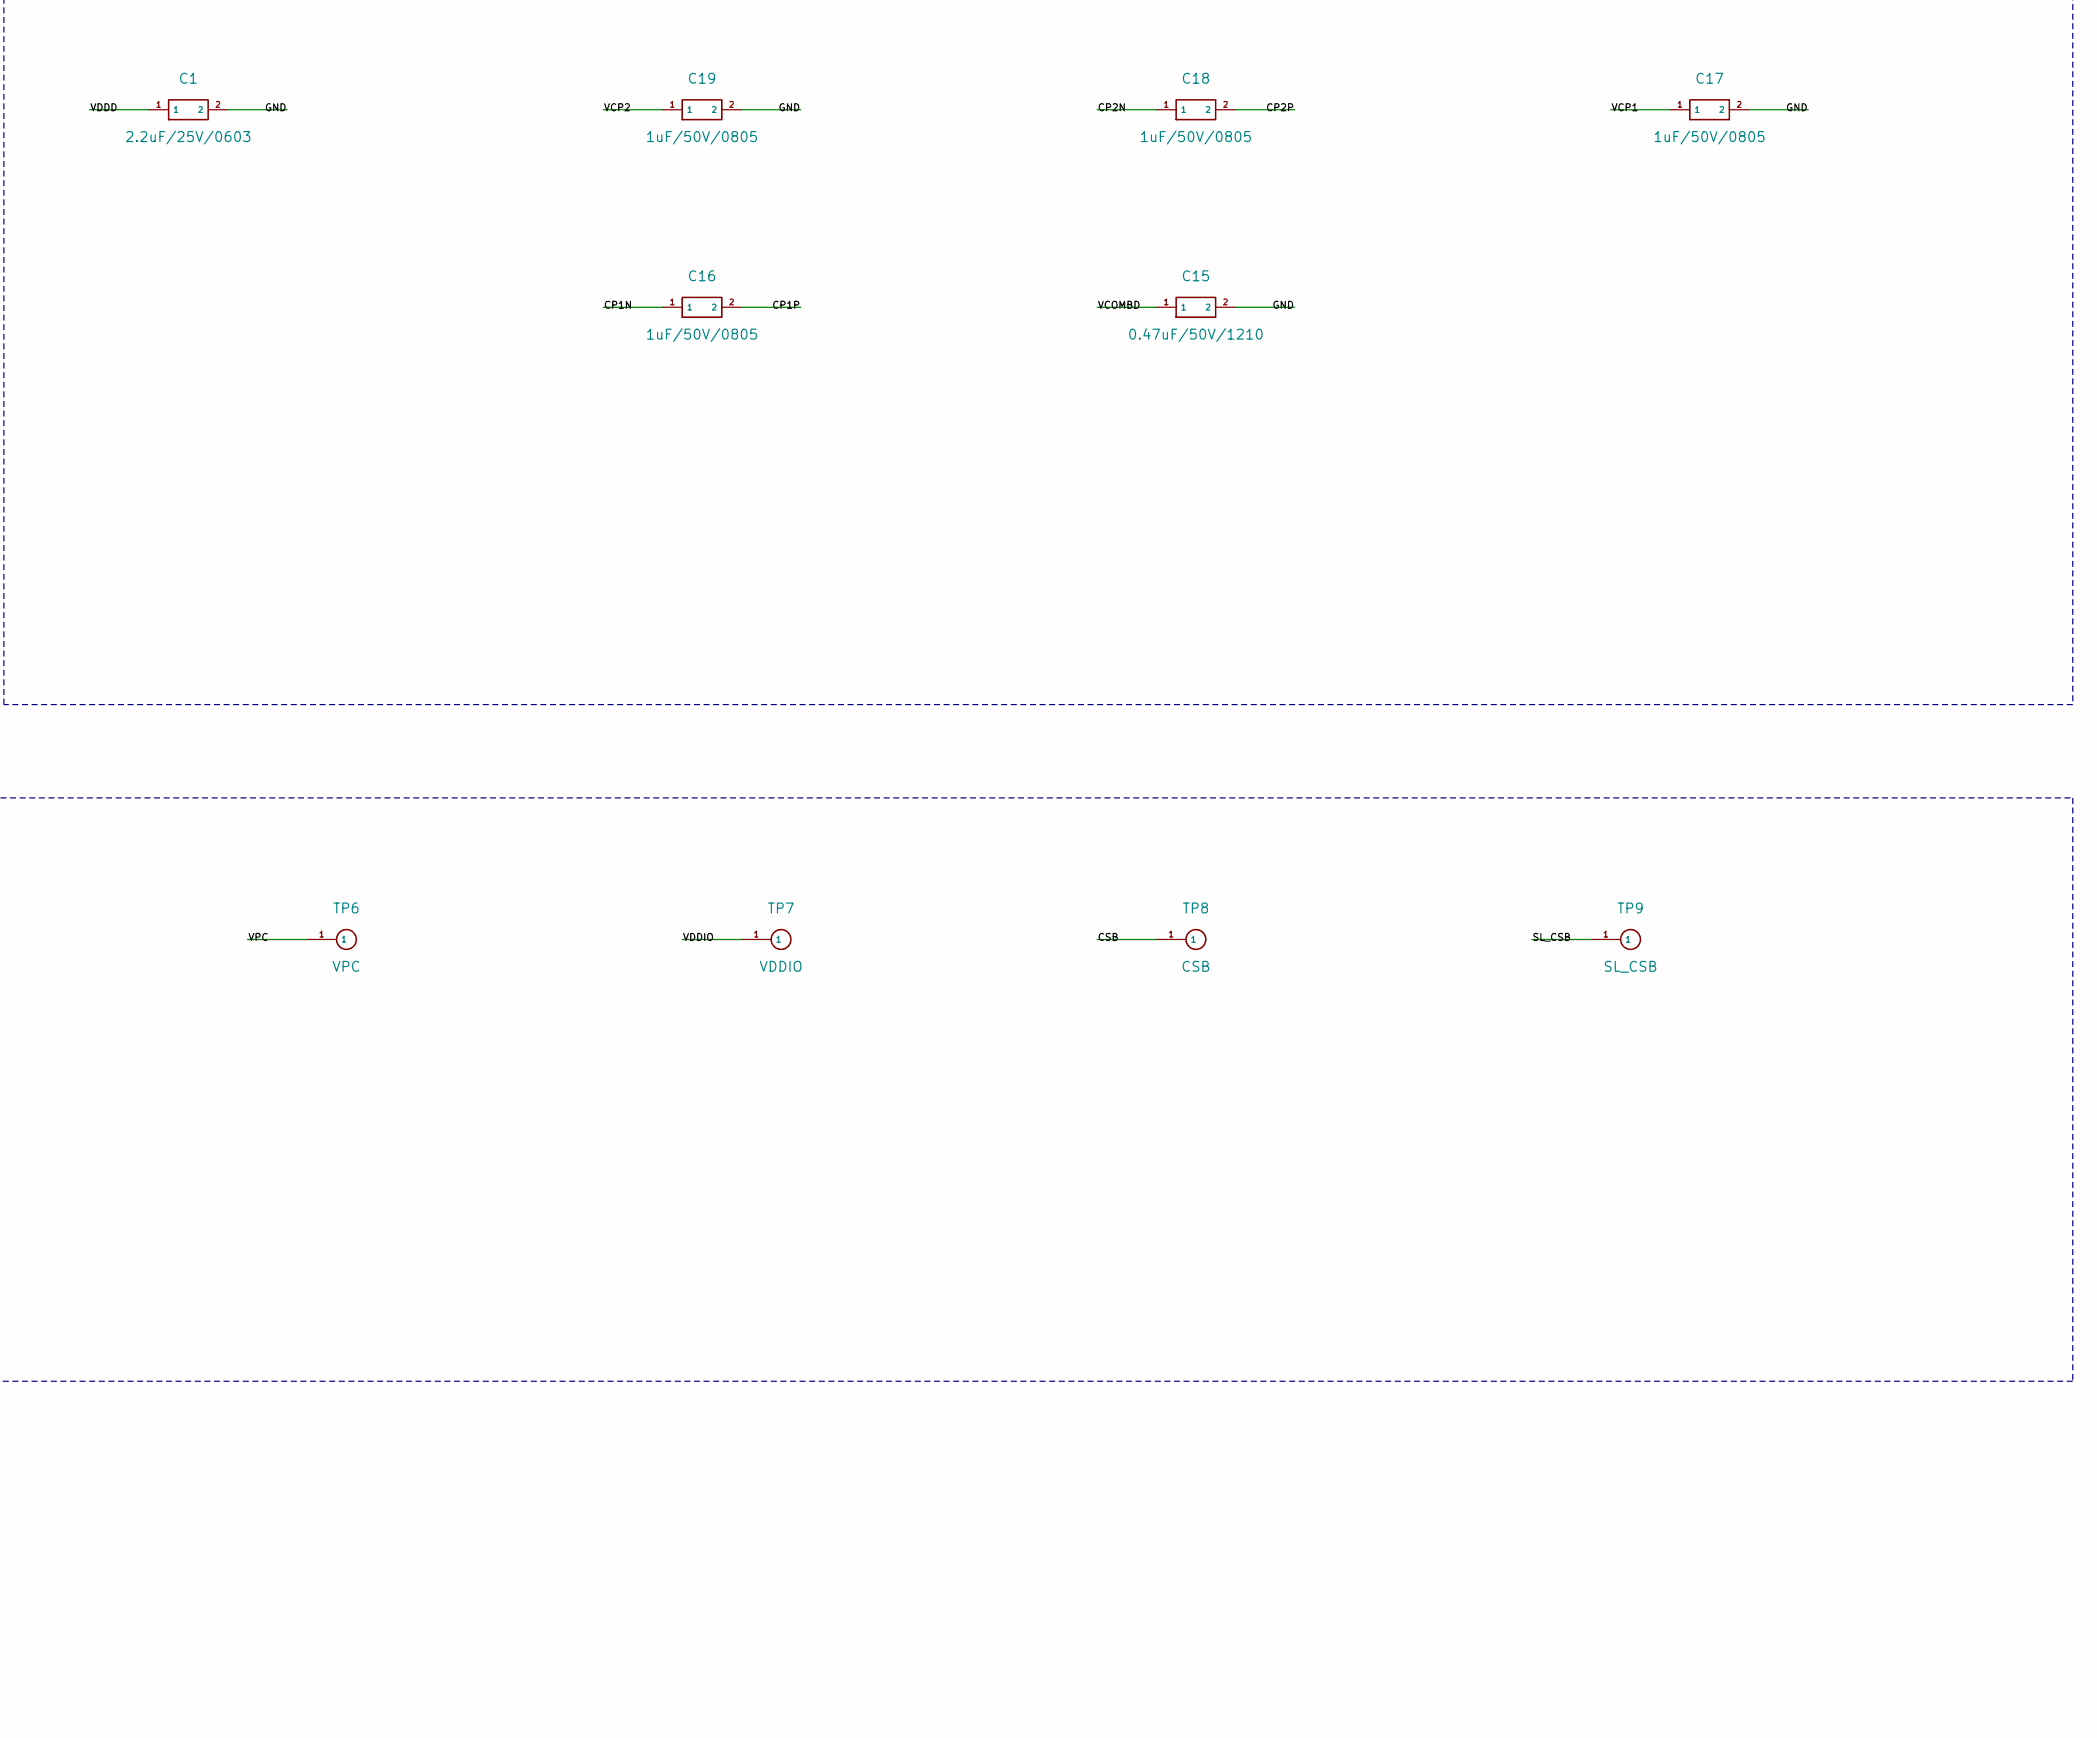
[picture p69: schematic mf1750_devkitc_b2_pcba_margin.kicad_sch, MF-1750 DevKitC Compact Carrier Rev B2 PCBA Edge Margin, part in row 2, column 2]

Parts:
C0, C22: 4.7uF/25V/0603; C_0603_1608Metric
C1: 2.2uF/25V/0603; C_0603_1608Metric
C2, C4, C5, C6, C7, C8, C9, C10, C11, C12, C23: 10uF/25V/1210; C_1210_3225Metric
C3: 0.1uF/50V/0603; C_0603_1608Metric
C13: 4.7uF/10V/0805; C_0805_2012Metric
C14, C15: 0.47uF/50V/1210; C_1210_3225Metric
C16, C17, C18, C19, C20, C21: 1uF/50V/0805; C_0805_2012Metric
D1, D2, D3, D4: MBR0530; D_SOD-123
J1: MF-1750 50pin FPC; XUNPU_FPC-05FB-50PH20_1x50_P0.5mm_DualContact
J2: ESP32-S3-DevKitC-1-N16R8 socket; ESP32-S3-DevKitC-1_Socket
J3: EPD 3V3 IN; JST_PH_S2B-PH-K_1x02_P2.00mm_Horizontal
L1, L2: 15uH/3.1A SMMS0650; SXN_SMMS0650_7.1x6.6mm
Q1: Si1308EDL; SOT-323_SC-70
Q2: AO3401A; SOT-23-3
R1: 0.2R 0.2W 1%; R_1206_3216Metric
R2, R4, R5, R6, R7, R8, R12, R13, R16: 0R; R_0603_1608Metric
R3: 0.22R 0.2W 1%; R_1206_3216Metric
R9, R10: 4.7k 1%; R_0603_1608Metric
R15: 0R DNP; R_0603_1608Metric; not fitted
TP1: 3V3; TestPoint_Pad_D1.0mm
TP2: GND; TestPoint_Pad_D1.0mm
TP3: VPH; TestPoint_Pad_D1.0mm
TP4: PREVGH; TestPoint_Pad_D1.0mm
TP5: PREVGL; TestPoint_Pad_D1.0mm
TP6: VPC; TestPoint_Pad_D1.0mm
TP7: VDDIO; TestPoint_Pad_D1.0mm
TP8: CSB; TestPoint_Pad_D1.0mm
TP9: SL_CSB; TestPoint_Pad_D1.0mm
TP10: BUSY_N; TestPoint_Pad_D1.0mm

Connections:
/3V3: J3.1 (EPD 3V3 IN), R4.1, R8.1, R9.2, R10.2, TP1.1
/BS0: J1.26 (BS0), R12.2
/BS1: J1.27 (BS1), R13.2
/BUSY_N: J1.29 (BUSY_N), J2.4 (J1-4 GPIO4 / BUSY_N), TP10.1
/CP1N: C16.1, J1.45 (CP1N)
/CP1P: C16.2, J1.46 (CP1P)
/CP2N: C18.1, J1.42 (CP2N)
/CP2P: C18.2, J1.43 (CP2P)
/CS2: J2.16 (J1-16 GPIO10 / CS2), R16.1
/CSB: J1.31 (CSB), J2.7 (J1-7 GPIO7 / CSB), R15.1, TP8.1
/DC: J1.30 (DC), J2.6 (J1-6 GPIO6 / DC)
/EPD_3V3: C3.1, R4.2, R6.1, R7.1
/FPL_VCOM: C14.1, J1.3 (FPL_VCOM)
/GDRC: J1.9 (GDRC), Q2.1 (G)
/GDRH: J1.5 (GDRH), Q1.1 (G)
/GND: C0.2, C1.2, C2.2, C3.2, C5.2, C6.2, C7.2, C8.2, C9.2, C10.2, C11.2, C12.2, C13.2, C14.2, C15.2, C17.2, C19.2, C20.2, C21.2, C22.2, C23.2, D2.1 (K), J1.12 (GND), J1.21 (GNDA), J1.39 (GND), J2.22 (J1-22 GND), J2.23 (J3-22 GND), J2.24 (J3-21 GND), J2.44 (J3-1 GND), J3.2 (GND), R1.2, R2.2, R3.2, R12.1, R13.1, TP2.1
/NEG_PUMP_H: C4.2, D2.2 (A), D3.1 (K)
/PREVGH: J1.49 (VGH), R5.2, TP4.1
/PREVGL: C5.1, D3.2 (A), J1.13 (VGL), TP5.1
/REFN: C21.1, J1.22 (REFN)
/REFP: C20.1, J1.23 (REFP)
/RESEC: J1.10 (RESEC), L2.2, R3.1
/RESEH: J1.6 (RESEH), Q1.2 (S), R1.1
/RESEL: J1.8 (RESEL), R2.1
/RST_N: J1.28 (RST_N), J2.5 (J1-5 GPIO5 / RST_N)
/SCL: J1.32 (SCL), J2.18 (J1-18 GPIO12 / SCL)
/SI0: J1.33 (SI0), J2.17 (J1-17 GPIO11 / SI0)
/SL_CSB: J1.4 (SL_CSB), R15.2, R16.2, TP9.1
/SW_C: D4.1 (K), L2.1, Q2.3 (D)
/SW_H: C4.1, D1.2 (A), L1.2, Q1.3 (D)
/TFT_VCOM: C13.1, J1.2 (TFT_VCOM)
/TSCL: J1.24 (TSCL), R9.1
/TSDA: J1.25 (TSDA), R10.1
/VCOMBD: C15.1, J1.50 (VCOMBD)
/VCP1: C17.1, J1.44 (VCP1)
/VCP2: C19.1, J1.41 (VCP2)
/VDD: J1.38 (VDD), R6.2
/VDDD: C1.1, J1.37 (VDDD)
/VDDIO: J1.40 (VDDIO), R7.2, TP7.1
/VPC: C6.1, D4.2 (A), J1.11 (VPC), TP6.1
/VPH: C2.1, D1.1 (K), J1.14 (VPH), R5.1, TP3.1
/VSH: C7.1, J1.15 (VSH)
/VSH_LV: C8.1, J1.16 (VSH_LV)
/VSH_LV2: C9.1, J1.17 (VSH_LV2)
/VSL: C10.1, J1.18 (VSL)
/VSL_LV: C11.1, J1.19 (VSL_LV)
/VSL_LV2: C12.1, J1.20 (VSL_LV2)
/V_B: C0.1, C22.1, C23.1, L1.1, Q2.2 (S), R8.2

Notes on the sheet:
MCU / SPI control input
3V3 distribution, pullups, and 4-wire mode
HV boost and negative gate pump
VPC positive pump
Panel FPC and MF-1750 signals
Panel-side caps, references, and flying capacitors
Bring-up and reserved test pads
FIT: distributes J3 external EPD 3V3 input to EPD_3V3
populate: BS0 low, 4-wire
populate: BS1 low, 4-wire
DNP: independent CS configuration verified on real panel
FIT: routes GPIO10/CS2 to SL_CSB; real-panel verified configuration
R12/R13 set BS0=0 and BS1=0 for 4-wire SPI.
pad1/K=VPH; pad2/A=SW_H
pad1/K=GND; pad2/A=NEG_PUMP_H
pad1/K=NEG_PUMP_H; pad2/A=PREVGL
Vishay Si1308EDL SC-70 top view: pin1=G, pin2=S, pin3=D
Main current path: V_B -> L1 -> SW_H/Q1/D1 -> VPH -> R5 -> PREVGH.
pad1/K=SW_C; pad2/A=VPC
SOT-23: pin1=G, pin2=S, pin3=D
Q2/L2/D4/R3 form the VPC pump; keep this loop compact in PCB layout.
Reference source: MF-1750/M009F-T specification page 10 reference circuit.
Verified topology: R16 fitted routes SL_CSB to DevKitC GPIO10; R15 is DNP.
Functional blocks now group and wire local nodes; net labels are reserved for cross-block interfaces.
Default bus mode: BS0=0 and BS1=0 through R12/R13 for 4-wire SPI with D/C.
Diode polarity is assigned in BOM notes; match footprint pin A/K to those notes before PCB layout.
Reserved FPC pins are routed only to isolated single test pads; pin1 NC is explicitly no-connect.
Footprints are intentionally mostly blank; assign real packages and ratings in KiCad before layout.
GPIO7 drives CSB and GPIO10 independently drives SL_CSB; never fit R15 and R16 together.

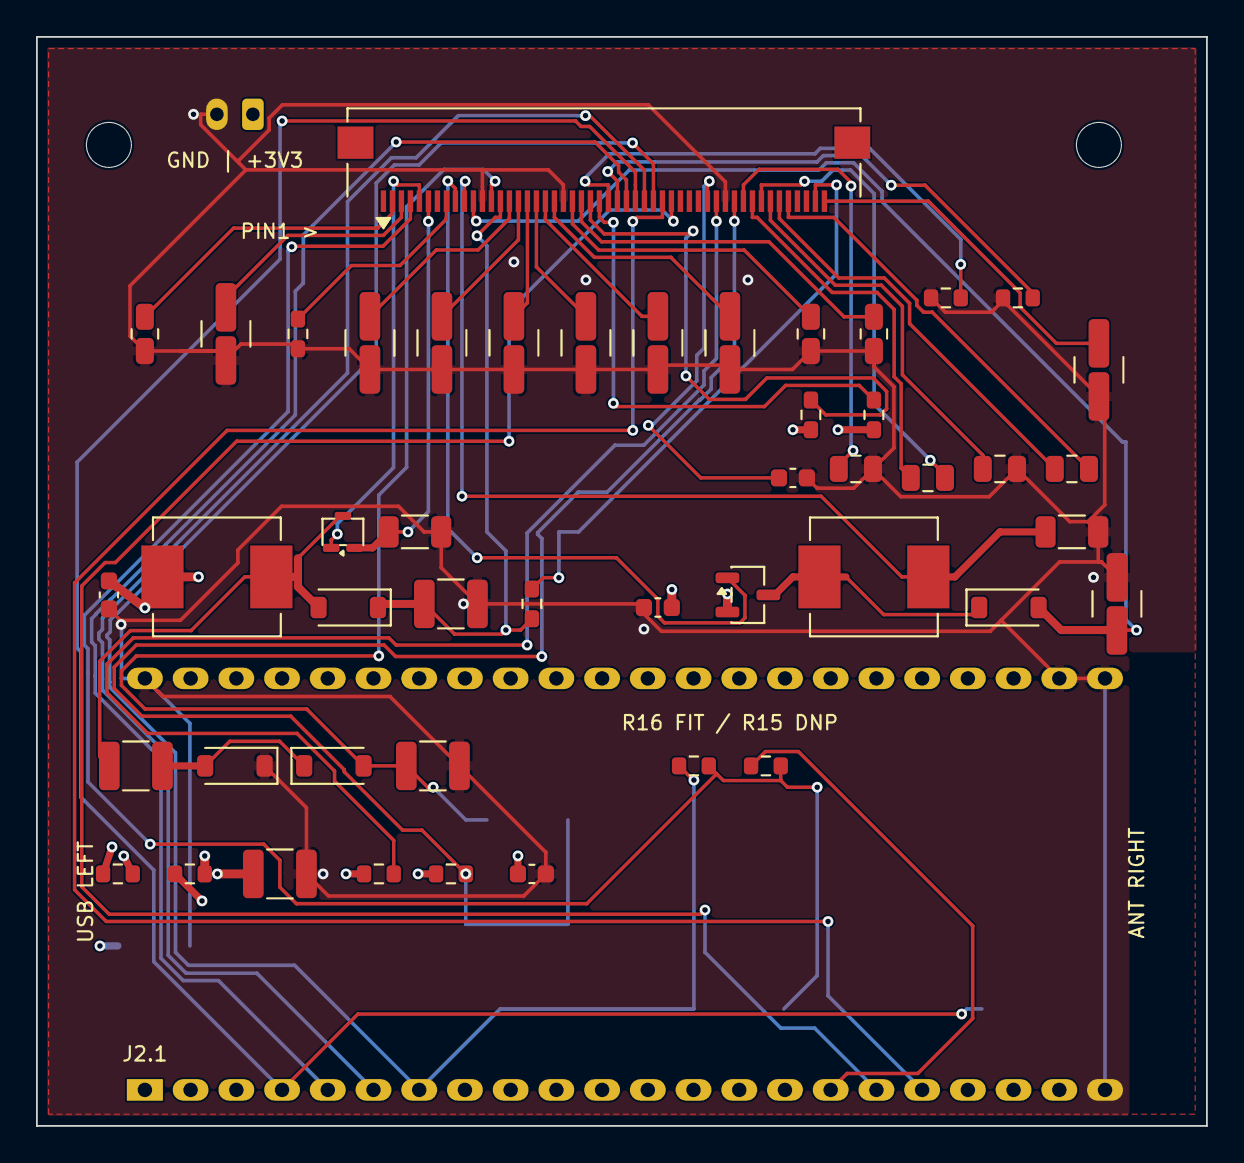
[picture p70: board mf1750_devkitc_b2_pcba_margin.kicad_pcb from above]

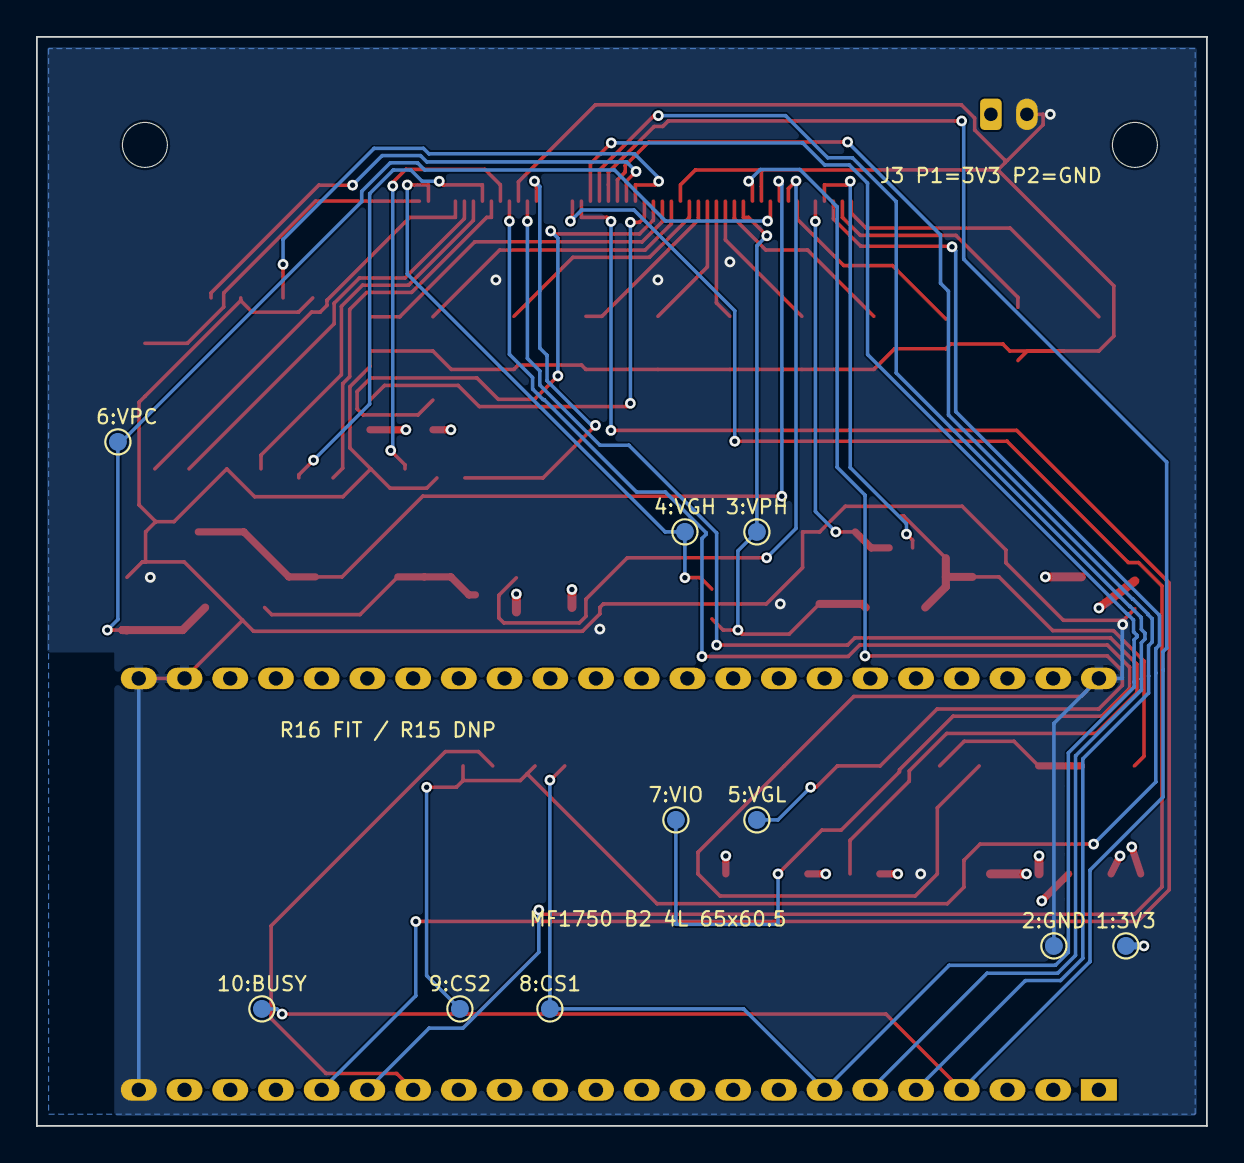
[picture p71: board mf1750_devkitc_b2_pcba_margin.kicad_pcb from below]

Board: 4 copper layers, 65.0 x 60.5 mm, 61 parts (10 on the bottom side), 48 nets.

Other parts of the board:
H1, H2: M2.5_NPTH; MountingHole_2.5mm
