oceanye/ESP32_C73-MF1750/hardware/reference_seeed_ee04/202004537_XIAO ePaper Display Board EE04_V1.2_SCH & PCB/XIAO ePaper Display Board EE04_V1.2.kicad_pcb

## KiCad design hardware/reference_seeed_ee04/202004537_XIAO ePaper Display Board EE04_V1.2_SCH & PCB/XIAO ePaper Display Board EE04_V1.2.kicad_pcb (2026-08-03)

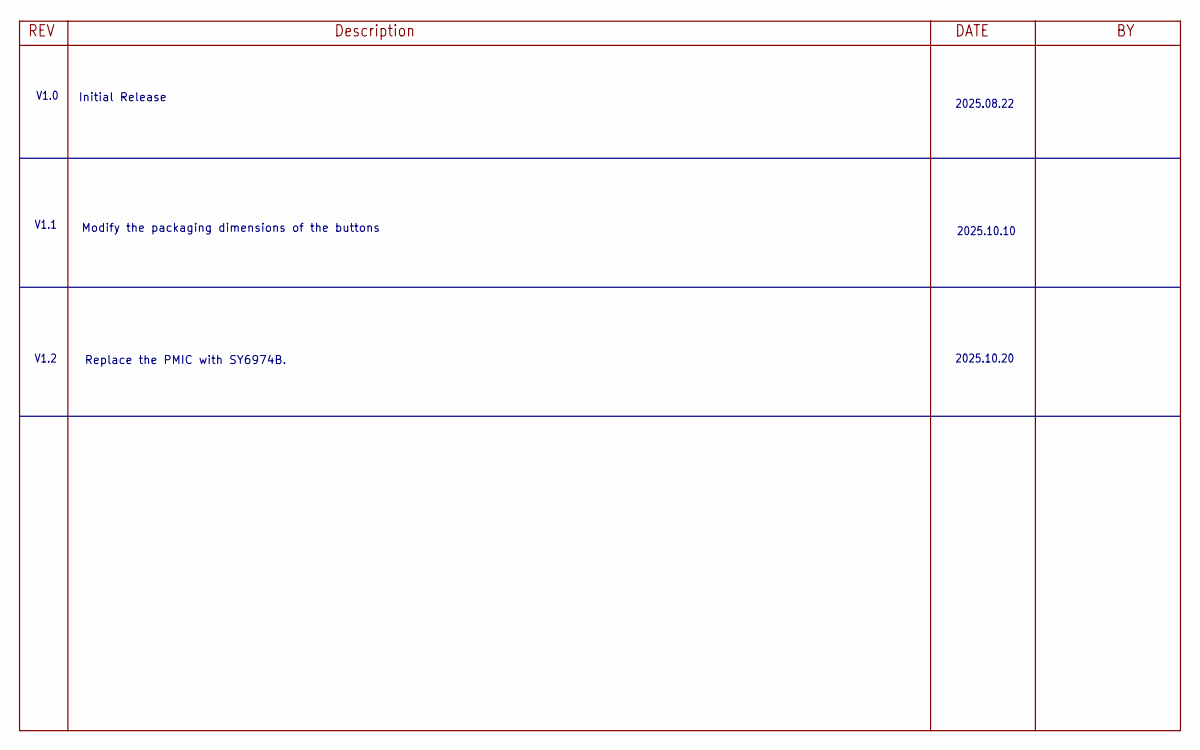
[picture p72: schematic 01 Descriptions.kicad_sch, XIAO ePaper Dsiplay Board EE04]

Notes on the sheet:
2025.08.22
2025.10.20
2025.10.10
Modify the packaging dimensions of the buttons
Replace the PMIC with SY6974B.
V1.1
Initial Release
V1.0
V1.2
