oceanye/ESP32_C73-MF1750/hardware/reference_seeed_ee04/202004537_XIAO ePaper Display Board EE04_V1.2_SCH & PCB/XIAO ePaper Display Board EE04_V1.2.kicad_pcb

## KiCad design hardware/reference_seeed_ee04/202004537_XIAO ePaper Display Board EE04_V1.2_SCH & PCB/XIAO ePaper Display Board EE04_V1.2.kicad_pcb (continued)

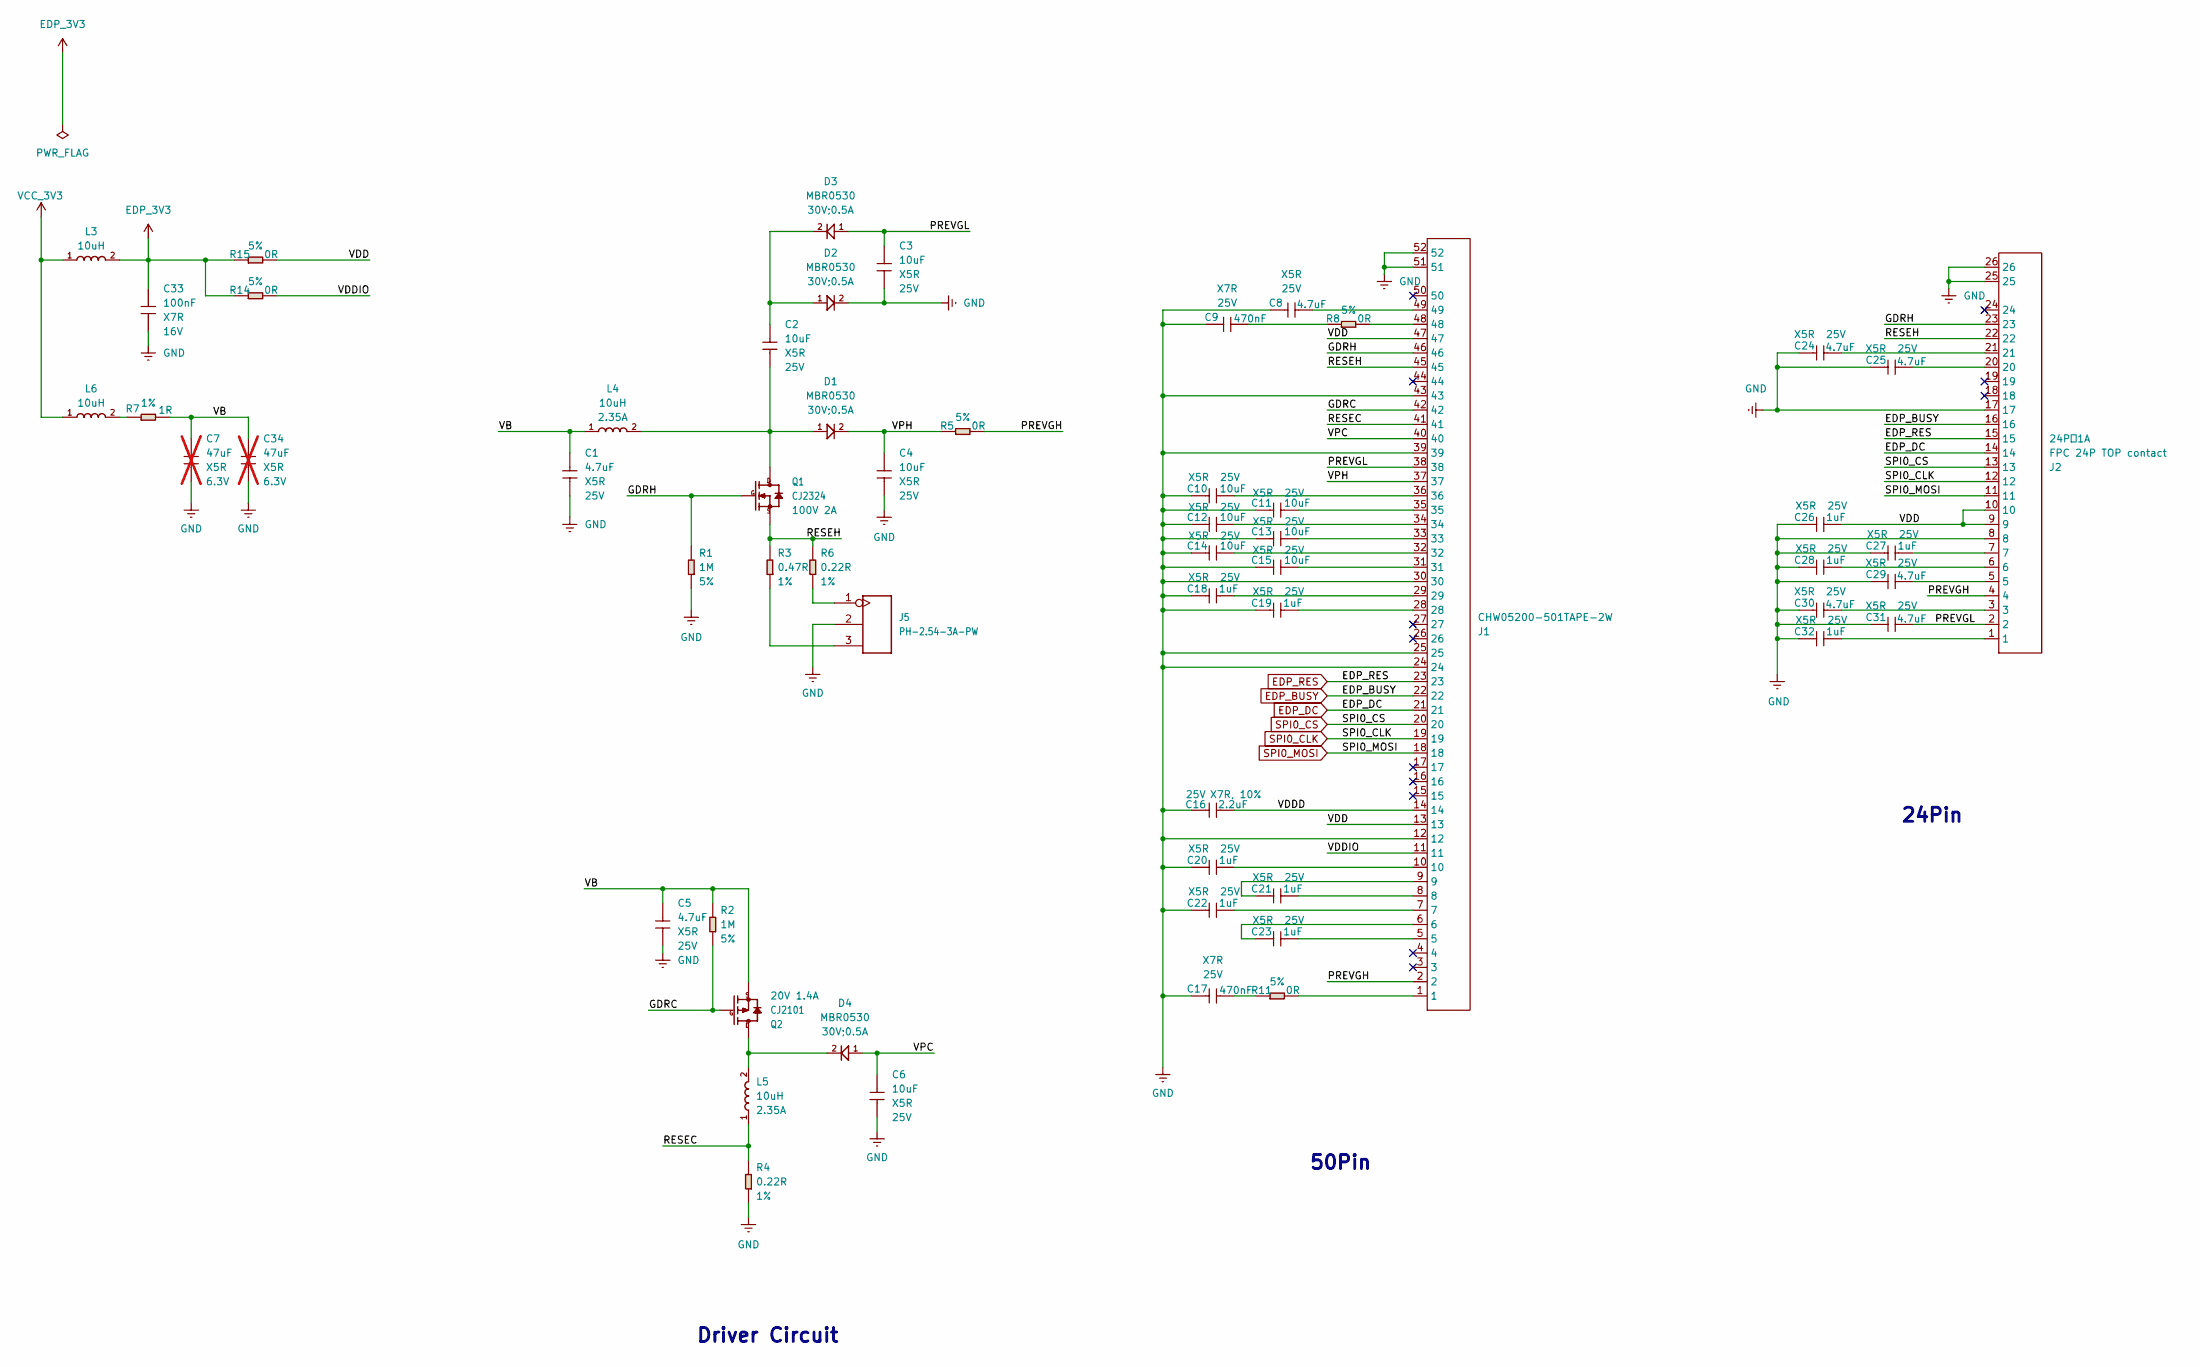
[picture p73: schematic E-ink.kicad_sch, XIAO ePaper Dsiplay Board EE04]

Parts:
C1, C5, C8, C24, C25, C29, C30, C31: 4.7uF; C0805; Voltage Rating 25V; MPN CC0805KKX5R8BB475
C2, C3, C4, C6, C10, C11, C12, C13, C14, C15: 10uF; C0805; Voltage Rating 25V; MPN CC0805KKX5R8BB106
C7, C34: 47uF; C0805; Voltage Rating 6.3V; MPN CC0805MKX5R5BB476; not fitted
C9, C17: 470nF; C0603; Voltage Rating 25V; MPN CC0603KRX7R8BB474
C16: 2.2uF; C0805; Voltage Rating 25V; MPN CC0805KKX7R8BB225
C18, C19, C20, C21, C22, C23, C26, C27, C28, C32: 1uF; C0402; Voltage Rating 25V; MPN CC0402KRX5R8BB105
C33: 100nF; C0402; Voltage Rating 16V; MPN CC0402KRX7R7BB104
D1, D2, D3, D4: MBR0530; SOD-123; Rating 30V;0.5A; MPN MBR0530
J1: CHW05200-501TAPE-2W; FPC50-0.5-28.6X4.9X2MM; MPN CHW05200-501TAPE-2W
J2: FPC 24P TOP contact; FPC24-0.5-15.5X4.9X2MM; Rating 24P，1A; MPN FPC0.5K-DH-24WB
J5: PH-2.54-3A-PW; H3-2.54-90D; MPN PH-2.54-3A-PW
L3, L6: 10uH; L0603; MPN MWSD1608FE100KT
L4, L5: 10uH; L5040S; Rating 2.35A; MPN SWPA5040S100MT
Q1: CJ2324; SOT23; Rating 100V 2A; MPN CJ2324
Q2: CJ2101; SOT-323; Rating 20V 1.4A; MPN CJ2101
R1, R2: 1M; R0402; Power Rating 5%; MPN RC0402JR-071ML
R3: 0.47R; R0603; Power Rating 1%; MPN RL0603FR-070R47L
R4, R6: 0.22R; R0805; Power Rating 1%; MPN RL0805FR-7W0R22L
R5, R8, R11, R14, R15: 0R; R0603; Power Rating 5%; MPN RC0603JR-070RL
R7: 1R; R0805; Power Rating 1%; MPN RC0805FR-071RL

Connections:
/E-ink/GDRC: J1.42, Q2.1 (G), R2.1
/E-ink/GDRH: J1.46, J2.23, Q1.1 (G), R1.2
/E-ink/PREVGH: J1.2, J2.4, R5.2
/E-ink/PREVGL: C3.2, C31.2, D3.1, J1.38, J2.2
/E-ink/RESEC: J1.41, L5.1, R4.2
/E-ink/RESEH: J1.45, J2.22, Q1.2 (S), R3.2, R6.2
/E-ink/VB: C1.1, C5.1, C7.1, C34.1, L4.1, Q2.2 (S), R2.2, R7.2
/E-ink/VDD: C26.2, J1.13, J1.47, J2.9, J2.10, R15.2
/E-ink/VDDD: C16.2, J1.14
/E-ink/VDDIO: J1.11, R14.2
/E-ink/VPC: C6.2, D4.1, J1.40
/E-ink/VPH: C4.2, D1.2, J1.37, R5.1
EDP_3V3: C33.1, L3.2, R14.1, R15.1
EDP_BUSY: J1.22, J2.16; also elsewhere on the board
EDP_DC: J1.21, J2.14; also elsewhere on the board
EDP_RES: J1.23, J2.15; also elsewhere on the board
GND: C1.2, C3.1, C4.1, C5.2, C6.1, C7.2, C8.1, C9.1, C10.2, C11.2, C12.2, C13.2, C14.2, C15.2, C16.1, C17.1, C18.1, C19.1, C20.1, C22.1, C24.1, C25.1, C26.1, C27.1, C28.1, C29.1, C30.1, C31.1, C32.1, C33.2, C34.2, D2.2, J1.12, J1.24, J1.25, J1.30, J1.39, J1.43, J1.51, J1.52, J2.8, J2.17, J2.25, J2.26, J5.2, R1.1, R4.1; also elsewhere on the board
unnamed: C2.2, D2.1, D3.2
unnamed: C8.2, J1.49
unnamed: C9.2, R8.1
unnamed: C10.1, J1.36
unnamed: C11.1, J1.35
unnamed: C12.1, J1.34
unnamed: C13.1, J1.33
unnamed: C14.1, J1.32
unnamed: C15.1, J1.31
unnamed: C17.2, R11.1
unnamed: C18.2, J1.29
unnamed: C19.2, J1.28
unnamed: C20.2, J1.10
unnamed: C21.1, J1.9
unnamed: C21.2, J1.8
unnamed: C22.2, J1.7
unnamed: C23.1, J1.6
unnamed: C23.2, J1.5
unnamed: C24.2, J2.21
unnamed: C25.2, J2.20
unnamed: C27.2, J2.7
unnamed: C28.2, J2.6
unnamed: C29.2, J2.5
unnamed: C30.2, J2.3
unnamed: C32.2, J2.1
unnamed: J1.1, R11.2
unnamed: J1.48, R8.2
unnamed: J5.1, R6.1
unnamed: J5.3, R3.1
unnamed: L6.2, R7.1
unnamed: C2.1, D1.1, L4.2, Q1.3 (D)
unnamed: D4.2, L5.2, Q2.3 (D)
SPI0_CLK: J1.19, J2.12; also elsewhere on the board
SPI0_CS: J1.20, J2.13; also elsewhere on the board
SPI0_MOSI: J1.18, J2.11; also elsewhere on the board
VCC_3V3: L3.1, L6.1; also elsewhere on the board

Notes on the sheet:
Driver Circuit
24Pin
50Pin

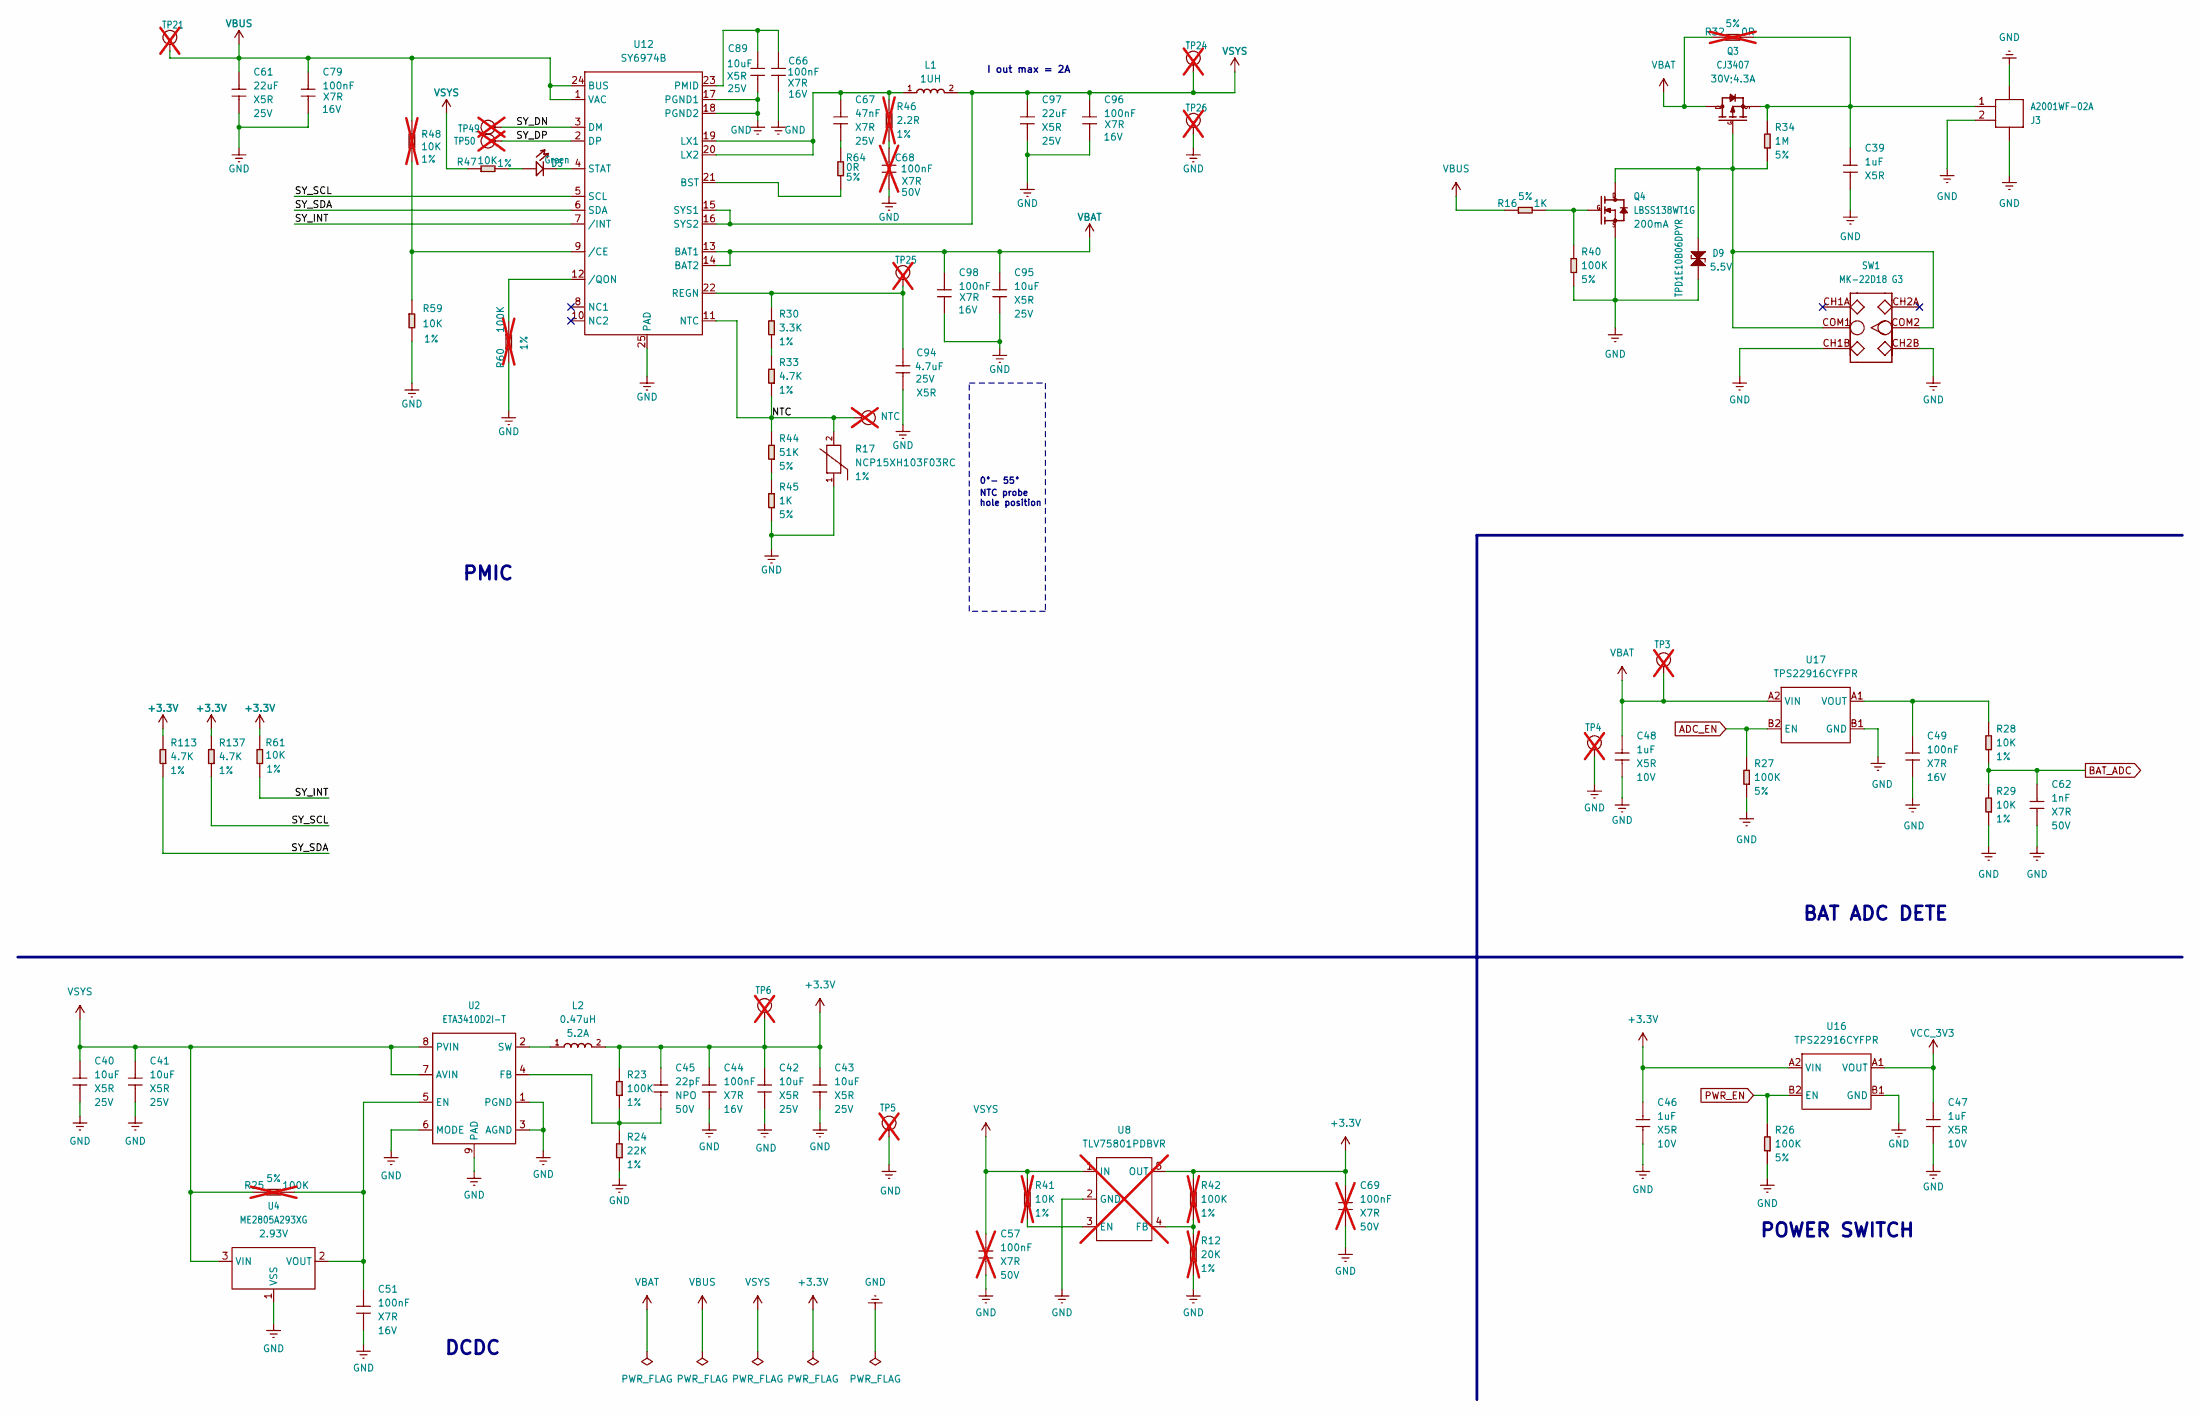
[picture p74: schematic Power.kicad_sch, XIAO ePaper Dsiplay Board EE04]

Parts:
C39, C46, C47, C48: 1uF; C0402; Voltage Rating 10V; MPN CC0402KRX5R6BB105
C40, C41, C42, C43, C89, C95: 10uF; C0805; Voltage Rating 25V; MPN CC0805KKX5R8BB106
C44, C49, C51, C66, C79, C96, C98: 100nF; C0402; Voltage Rating 16V; MPN CC0402KRX7R7BB104
C45: 22pF; C0402; Voltage Rating 50V; MPN CC0402JRNPO9BN220
C57, C68, C69: 100nF; C0603; Voltage Rating 50V; MPN CC0603KRX7R9BB104; not fitted
C61, C97: 22uF; C0805; Voltage Rating 25V; MPN CC0805MKX5R8BB226
C62: 1nF; C0402; Voltage Rating 50V; MPN CC0402KRX7R9BB102
C67: 47nF; C0402; Voltage Rating 25V; MPN CC0402KRX7R8BB473
C94: 4.7uF; C0805; Voltage Rating 25V; MPN CC0805KKX5R8BB475
D5: Green; LED2-0.6X1.7MM; MPN 27-21/GHC-YR1S2M/3C
D9: TPD1E10B06DPYR; ESD-0402; Rating 5.5V; MPN TPD1E10B06DPYR
J3: A2001WF-02A; JST2+2P_2.0_PH_S2B-PH-SM4-TB_1x02-1MP_Horizontal; MPN A2001WF-02A
L1: 1UH; INT2-SMD-4.2X4.4X1.8MM; MPN MWSA0402S-1R0MT
L2: 0.47uH; L0805; Rating 5.2A; MPN WPN201610MR47MT
NTC_IN2: NTC; TP-D45MIL; Part Type Test Point; not fitted
Q3: CJ3407; SOT23; Rating 30V;4.3A; MPN CJ3407
Q4: LBSS138WT1G; SOT-323; Rating 200mA; MPN LBSS138WT1G
R12: 20K; R0402; Power Rating 1%; MPN RC0402FR-0720KL; not fitted
R16, R45: 1K; R0402; Power Rating 5%; MPN RC0402JR-071KL
R17: NCP15XH103F03RC; R0402; Power Rating 1%; MPN NCP15XH103F03RC
R23: 100K; R0402; Power Rating 1%; MPN RC0402FR-07100KL
R24: 22K; R0402; Power Rating 1%; MPN RC0402FR-0722KL
R25: 100K; R0402; Power Rating 5%; MPN RC0402JR-07100KL; not fitted
R26, R27, R40: 100K; R0402; Power Rating 5%; MPN RC0402JR-07100KL
R28, R29, R47, R59, R61: 10K; R0402; Power Rating 1%; MPN RC0402FR-0710KL
R30: 3.3K; R0402; Power Rating 1%; MPN RC0402JR-073K3L
R32: 0R; R0603; Power Rating 5%; MPN RC0603JR-070RL; not fitted
R33, R113, R137: 4.7K; R0402; Power Rating 1%; MPN RC0402FR-074K7L
R34: 1M; R0402; Power Rating 5%; MPN RC0402JR-071ML
R41, R48: 10K; R0402; Power Rating 1%; MPN RC0402FR-0710KL; not fitted
R42, R60: 100K; R0402; Power Rating 1%; MPN RC0402FR-07100KL; not fitted
R44: 51K; R0402; Power Rating 5%; MPN RC0402JR-0751KL
R46: 2.2R; R0603; Power Rating 1%; MPN RC0603FR-072R2L; not fitted
R64: 0R; R0402; Power Rating 5%; MPN RC0402JR-070RL
SW1: MK-22D18 G3; SW6-2CH-2.54-9X3.5X3.5; MPN MK-22D18 G3
TP3, TP4, TP5, TP6, TP21, TP24, TP25, TP26, TP49, TP50: Test Point; TP-D45MIL; Part Type Test Point; not fitted
U2: ETA3410D2I-T; DFN8G-0.5-2X2MM; MPN ETA3410D2I-T
U4: ME2805A293XG; SOT-23; Rating 2.93V; MPN ME2805A293XG
U8: TLV75801PDBVR; SOT-23-5; MPN TLV75801PDBVR; not fitted
U12: SY6974B; QFN24G-0.5-4X4MM; MPN SY6974B
U16, U17: TPS22916CYFPR; WLCSP4-0.4-0.77X0.77X0.33MM; MPN TPS22916CYFPR

Connections:
+3.3V: C42.2, C43.2, C44.1, C45.1, C46.1, C69.1, L2.2, R23.2, R42.2, R61.2, R113.2, R137.2, TP6.1 (T), U8.5 (OUT), U16.A2 (VIN)
/Power/NTC: NTC_IN2.1 (T), R17.2, R33.1, R44.2, U12.11 (NTC)
/Power/SY_DN: TP49.1 (T), U12.3 (DM)
/Power/SY_DP: TP50.1 (T), U12.2 (DP)
/Power/SY_INT: R61.1, U12.7 (/INT)
/Power/SY_SCL: R137.1, U12.5 (SCL)
/Power/SY_SDA: R113.1, U12.6 (SDA)
ADC_EN: R27.2, U17.B2 (EN); also elsewhere on the board
BAT_ADC: C62.1, R28.1, R29.2; also elsewhere on the board
GND: C39.2, C40.1, C41.1, C42.1, C43.1, C44.2, C46.2, C47.2, C48.2, C49.2, C51.2, C57.2, C61.2, C62.2, C66.1, C68.1, C69.2, C79.2, C89.1, C94.2, C95.2, C96.2, C97.2, C98.2, D9.1, J3.2, J3.3, J3.4, Q4.2 (S), R12.1, R17.1, R24.1, R26.1, R27.1, R29.1, R40.1, R45.1, R59.2, R60.2, SW1.CH1B, SW1.CH2B, TP4.1 (T), TP5.1 (T), TP26.1 (T), U2.1 (PGND), U2.3 (AGND), U2.6 (MODE), U2.9 (PAD), U4.1 (VSS), U8.2 (GND), U12.17 (PGND1), U12.18 (PGND2), U12.25 (PAD), U16.B1 (GND), U17.B1 (GND); also elsewhere on the board
unnamed: C67.2, R64.2
unnamed: C68.2, R46.1
unnamed: D5.1 (+), R47.2
unnamed: D5.2 (-), U12.4 (STAT)
unnamed: D9.2, Q3.1 (G), Q4.3 (D), R34.1, SW1.COM1, SW1.COM2
unnamed: C39.1, J3.1, Q3.2 (S), R32.2, R34.2
unnamed: Q4.1 (G), R16.2, R40.2
unnamed: R30.1, R33.2
unnamed: R44.1, R45.2
unnamed: C94.1, R30.2, TP25.1 (T), U12.22 (REGN)
unnamed: C51.1, R25.1, U2.5 (EN), U4.2 (VOUT)
unnamed: C45.2, R23.1, R24.2, U2.4 (FB)
unnamed: L2.1, U2.2 (SW)
unnamed: R41.1, U8.3 (EN)
unnamed: R12.2, R42.1, U8.4 (FB)
unnamed: R64.1, U12.21 (BST)
unnamed: C67.1, L1.1, R46.2, U12.19 (LX1), U12.20 (LX2)
unnamed: C66.2, C89.2, U12.23 (PMID)
unnamed: R48.1, R59.1, U12.9 (/CE)
unnamed: R60.1, U12.12 (/QON)
unnamed: C49.1, R28.2, U17.A1 (VOUT)
PWR_EN: R26.2, U16.B2 (EN); also elsewhere on the board
VBAT: C48.1, C95.1, C98.1, Q3.3 (D), R32.1, TP3.1 (T), U12.13 (BAT1), U12.14 (BAT2), U17.A2 (VIN); also elsewhere on the board
VBUS: C61.1, C79.1, R16.1, R48.2, TP21.1 (T), U12.1 (VAC), U12.24 (BUS); also elsewhere on the board
VCC_3V3: C47.1, U16.A1 (VOUT); also elsewhere on the board
VSYS: C40.2, C41.2, C57.1, C96.1, C97.1, L1.2, R25.2, R41.2, R47.1, TP24.1 (T), U2.7 (AVIN), U2.8 (PVIN), U4.3 (VIN), U8.1 (IN), U12.15 (SYS1), U12.16 (SYS2)

Notes on the sheet:
PMIC
DCDC
BAT ADC DETE
POWER SWITCH
0°- 55°
I out max = 2A
NTC probe hole position

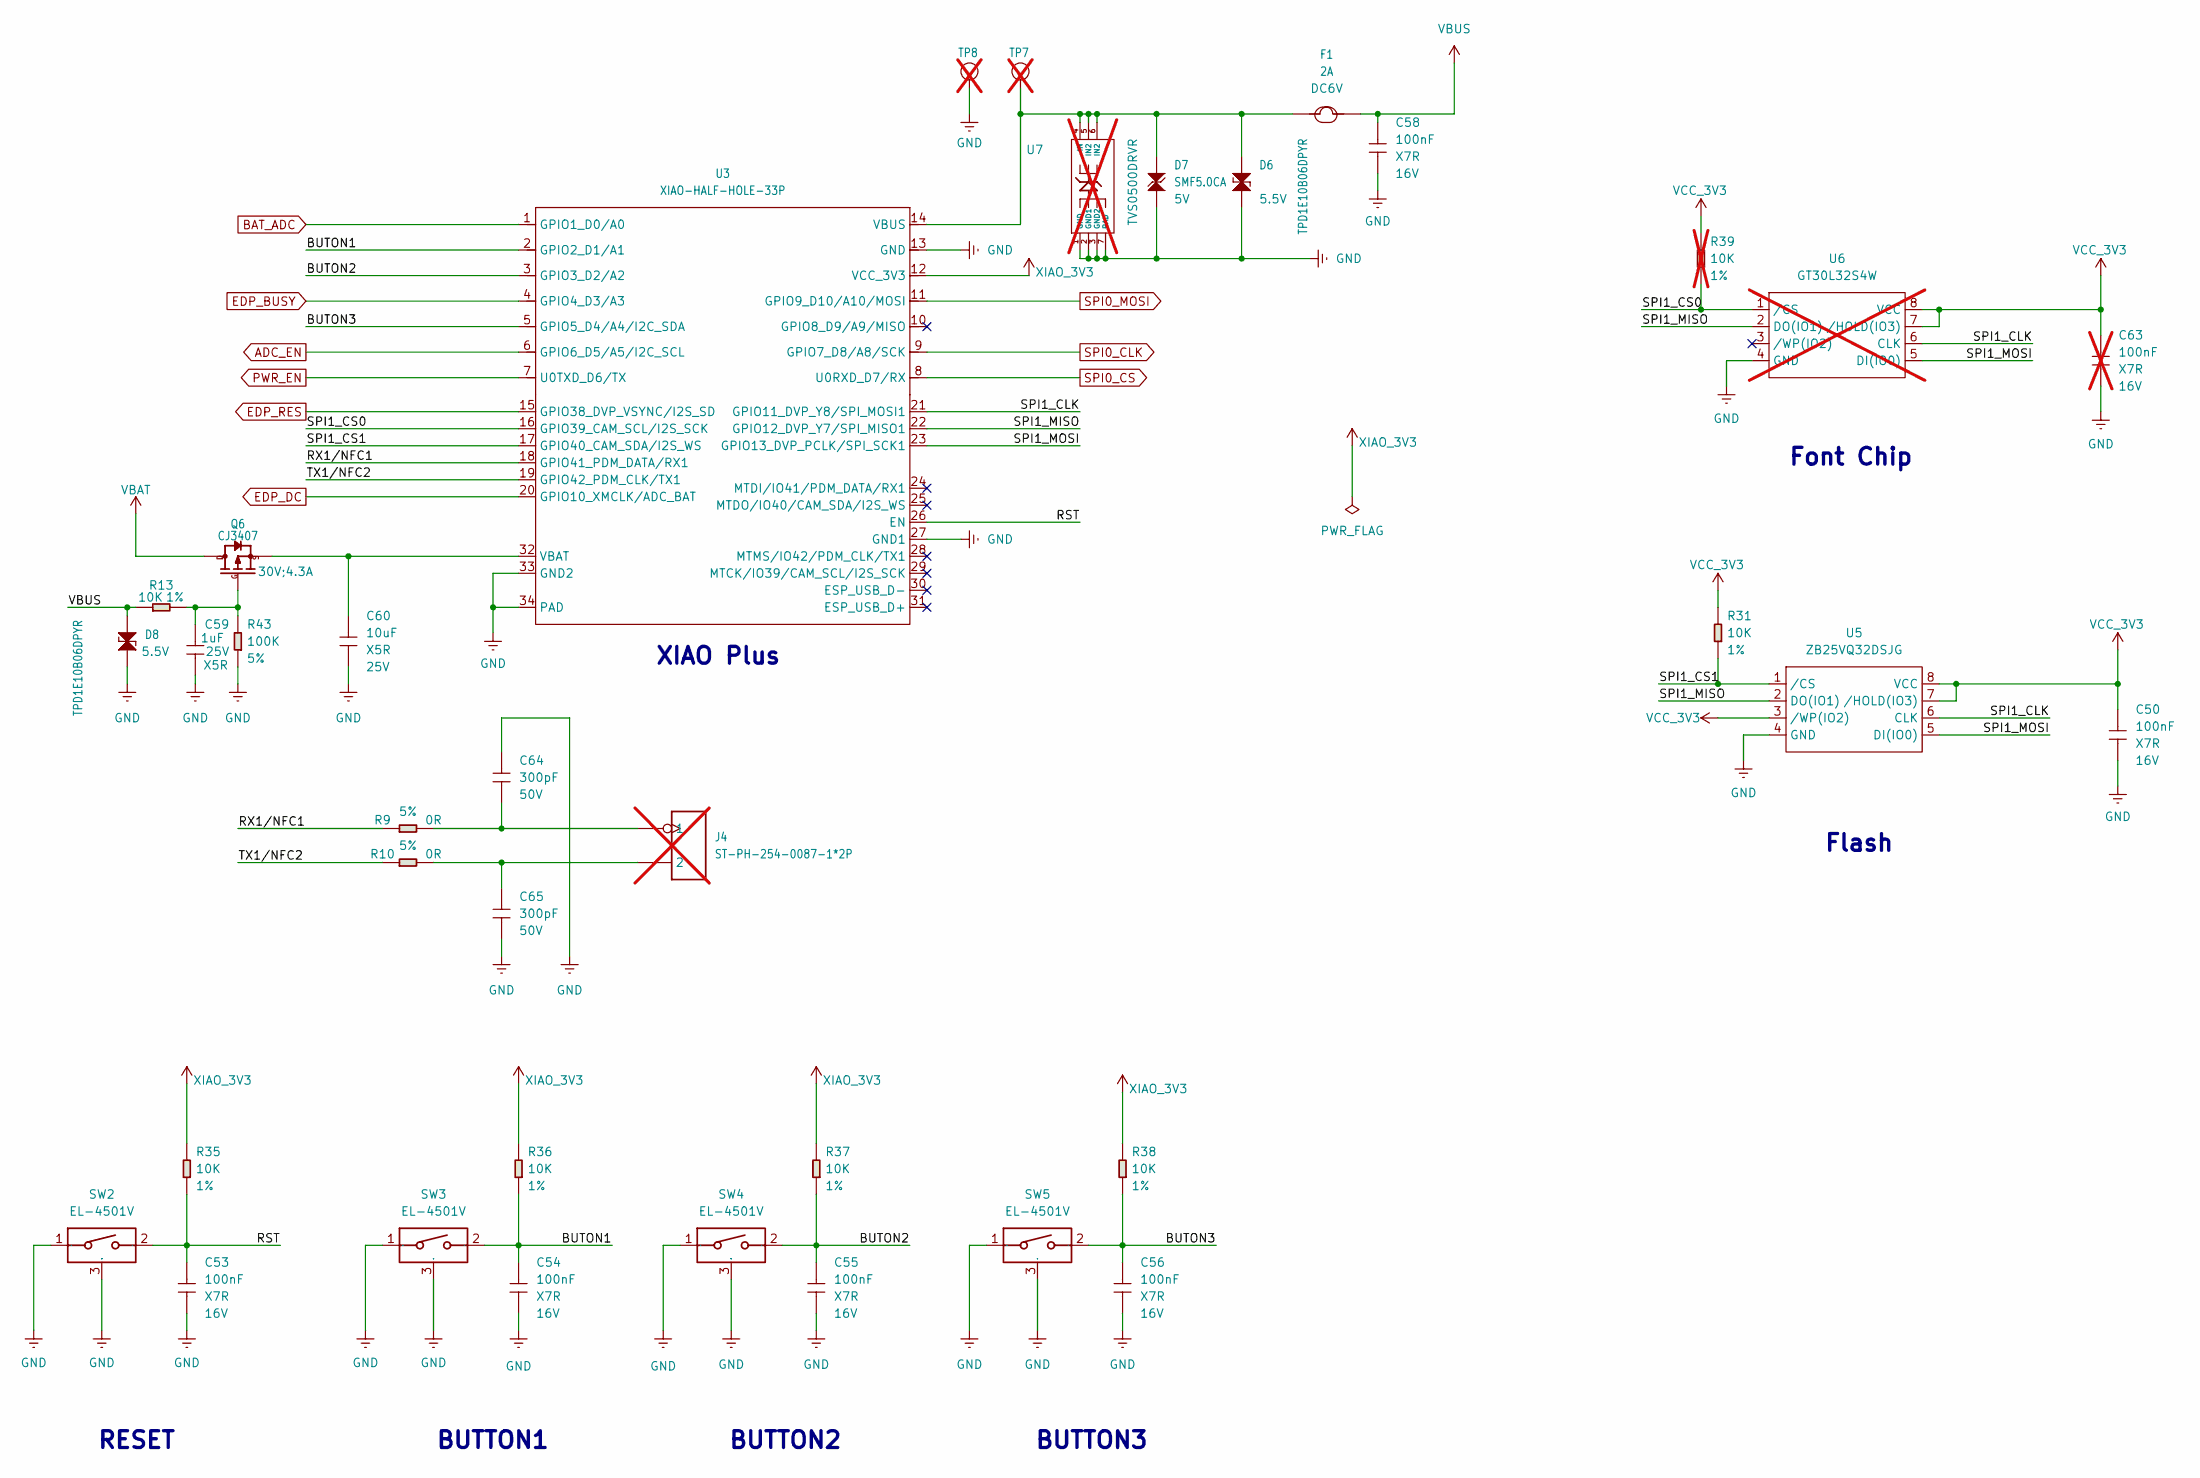
[picture p75: schematic XIAO.kicad_sch, XIAO ePaper Dsiplay Board EE04]

Parts:
C50, C53, C54, C55, C56, C58: 100nF; C0402; Voltage Rating 16V; MPN CC0402KRX7R7BB104
C59: 1uF; C0402; Voltage Rating 25V; MPN CC0402KRX5R8BB105
C60: 10uF; C0805; Voltage Rating 25V; MPN CC0805KKX5R8BB106
C63: 100nF; C0402; Voltage Rating 16V; MPN CC0402KRX7R7BB104; not fitted
C64, C65: 300pF; C0402; Voltage Rating 50V; MPN GRM1555C1H301JA01D
D6, D8: TPD1E10B06DPYR; ESD-0402; Rating 5.5V; MPN TPD1E10B06DPYR
D7: SMF5.0CA; SOD-123; Rating 5V; MPN SMF5.0CA
F1: 2A; F1210; Rating DC6V; MPN SMD1210R200SF
J4: ST-PH-254-0087-1*2P; H2P-2.54-65_40MIL; MPN ST-PH-254-0087-1*2P; not fitted
Q6: CJ3407; SOT23; Rating 30V;4.3A; MPN CJ3407
R9, R10: 0R; R0402; Power Rating 5%; MPN RC0402JR-070RL
R13, R31, R35, R36, R37, R38: 10K; R0402; Power Rating 1%; MPN RC0402FR-0710KL
R39: 10K; R0402; Power Rating 1%; MPN RC0402FR-0710KL; not fitted
R43: 100K; R0402; Power Rating 5%; MPN RC0402JR-07100KL
SW2, SW3, SW4, SW5: EL-4501V; SW3-DIP-SIDE-4.5X4.5X5.5MM; MPN EL-4501V
TP7, TP8: Test Point; TP-D45MIL; Part Type Test Point; not fitted
U3: XIAO-HALF-HOLE-33P; XIAO-ESP32-S3-Plus-SMD
U5: ZB25VQ32DSJG; SOIC8-1.27-5.3X5.3MM; MPN ZB25VQ32DSJG
U6: GT30L32S4W; SOP8-1.27-5.2X5.2x2.16MM; MPN GT30L32S4W; not fitted
U7: TVS0500DRVR; WSON7-0.65-2X2X0.8MM; MPN TVS0500DRVR; not fitted

Connections:
/XIAO/BUTON1: C54.1, R36.1, SW3.2, U3.2 (GPIO2_D1/A1)
/XIAO/BUTON2: C55.1, R37.1, SW4.2, U3.3 (GPIO3_D2/A2)
/XIAO/BUTON3: C56.1, R38.1, SW5.2, U3.5 (GPIO5_D4/A4/I2C_SDA)
/XIAO/RST: C53.1, R35.1, SW2.2, U3.26 (EN)
/XIAO/RX1/NFC1: R9.1, U3.18 (GPIO41_PDM_DATA/RX1)
/XIAO/SPI1_CLK: U3.21 (GPIO11_DVP_Y8/SPI_MOSI1), U5.6 (CLK), U6.6 (CLK)
/XIAO/SPI1_CS0: R39.1, U3.16 (GPIO39_CAM_SCL/I2S_SCK), U6.1 (/CS)
/XIAO/SPI1_CS1: R31.1, U3.17 (GPIO40_CAM_SDA/I2S_WS), U5.1 (/CS)
/XIAO/SPI1_MISO: U3.22 (GPIO12_DVP_Y7/SPI_MISO1), U5.2 (DO(IO1)), U6.2 (DO(IO1))
/XIAO/SPI1_MOSI: U3.23 (GPIO13_DVP_PCLK/SPI_SCK1), U5.5 (DI(IO0)), U6.5 (DI(IO0))
/XIAO/TX1/NFC2: R10.1, U3.19 (GPIO42_PDM_CLK/TX1)
ADC_EN: U3.6 (GPIO6_D5/A5/I2C_SCL); also elsewhere on the board
BAT_ADC: U3.1 (GPIO1_D0/A0); also elsewhere on the board
EDP_BUSY: U3.4 (GPIO4_D3/A3); also elsewhere on the board
EDP_DC: U3.20 (GPIO10_XMCLK/ADC_BAT); also elsewhere on the board
EDP_RES: U3.15 (GPIO38_DVP_VSYNC/I2S_SD); also elsewhere on the board
GND: C50.2, C53.2, C54.2, C55.2, C56.2, C58.2, C59.2, C60.1, C63.2, C64.1, C65.2, D6.1, D7.1, D8.1, R43.1, SW2.1, SW2.3 (GND), SW3.1, SW3.3 (GND), SW4.1, SW4.3 (GND), SW5.1, SW5.3 (GND), TP8.1 (T), U3.13 (GND), U3.27 (GND1), U3.33 (GND2), U3.34 (PAD), U5.4 (GND), U6.4 (GND), U7.1 (GND), U7.2 (GND1), U7.3 (GND2), U7.7 (PAD); also elsewhere on the board
unnamed: C64.2, J4.1, R9.2
unnamed: C65.1, J4.2, R10.2
unnamed: C59.1, Q6.1 (G), R13.2, R43.2
unnamed: C60.2, Q6.2 (S), U3.32 (VBAT)
unnamed: D6.2, D7.2, F1.1, TP7.1 (T), U3.14 (VBUS), U7.4 (IN), U7.5 (IN2), U7.6 (IN2)
PWR_EN: U3.7 (U0TXD_D6/TX); also elsewhere on the board
SPI0_CLK: U3.9 (GPIO7_D8/A8/SCK); also elsewhere on the board
SPI0_CS: U3.8 (U0RXD_D7/RX); also elsewhere on the board
SPI0_MOSI: U3.11 (GPIO9_D10/A10/MOSI); also elsewhere on the board
VBAT: Q6.3 (D); also elsewhere on the board
VBUS: C58.1, D8.2, F1.2, R13.1; also elsewhere on the board
VCC_3V3: C50.1, C63.1, R31.2, R39.2, U5.3 (/WP(IO2)), U5.7 (/HOLD(IO3)), U5.8 (VCC), U6.7 (/HOLD(IO3)), U6.8 (VCC); also elsewhere on the board
XIAO_3V3: R35.2, R36.2, R37.2, R38.2, U3.12 (VCC_3V3)

Notes on the sheet:
BUTTON1
BUTTON2
Flash
BUTTON3
Font Chip
RESET
XIAO Plus

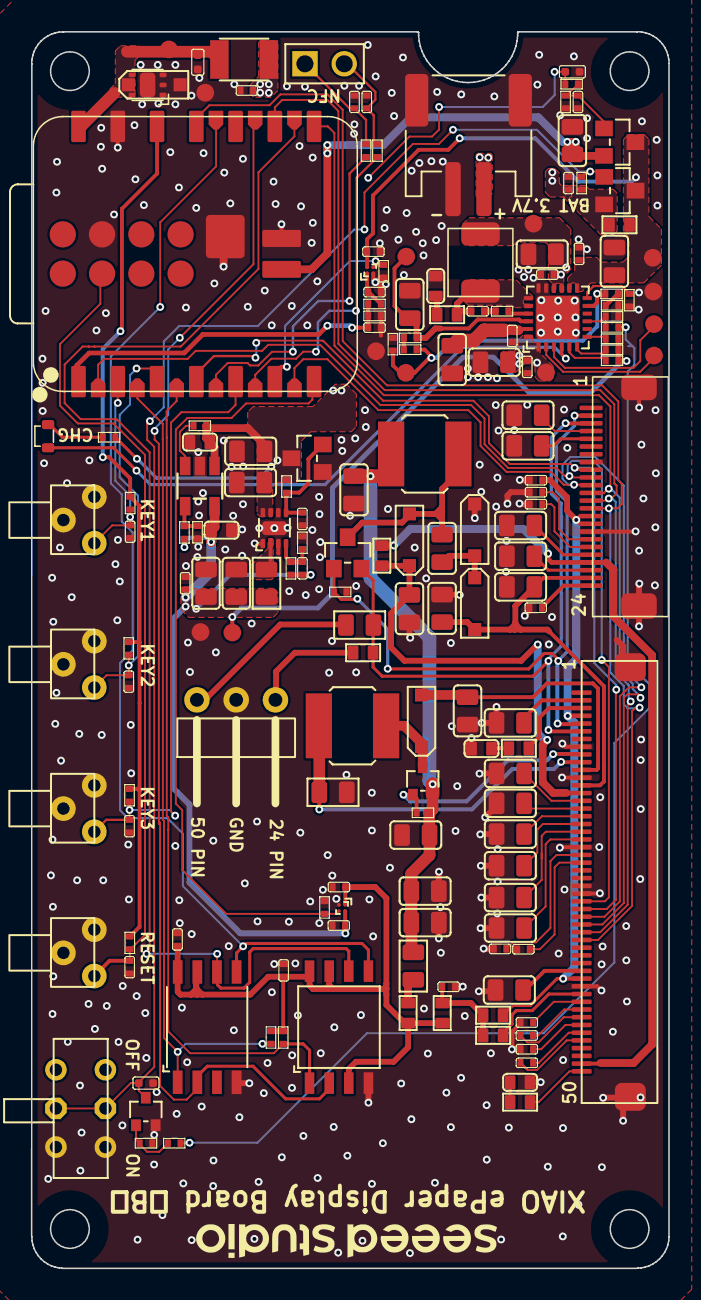
[picture p76: board XIAO ePaper Display Board EE04_V1.2.kicad_pcb from above]

Board: 2 copper layers, 41.2 x 80.0 mm, 174 parts (0 on the bottom side), 104 nets.
