oceanye/ESP32_C73-MF1750/hardware/build_mf1750_wroom_b3_board_r3.py

#!/usr/bin/env python3
"""Build the MF1750 WROOM B3 R3 *placed, not routed* PCB staging file.

This is a fail-closed schematic-to-board synchronization foundation.  It:

* exports a KiCad 10 ``kicadxml`` netlist from the selected B3 schematic;
* loads the SHA-256-frozen B2 PCB as the sole geometry/routing predecessor;
* preserves every B2 footprint except removed J3 (including J2/H1/H2)
  position/orientation/side/package;
* removes only the eleven source-track UUIDs authorized by the reviewed R3
  migration audit and preserves every other B2 track plus all 75 vias as a
  geometry/net subset;
* removes obsolete J3, retains J2 as the schematic-controlled DNP footprint;
* migrates every routed/pad/zone use of ``/3V3`` to ``/EPD_SW_3V3``;
* synchronizes every schematic footprint, UUID path, DNP flag and numbered pad
  net, loading footprints only from explicit project or KiCad 10 libraries;
* expands the outline to a parameterized 80 x 125 mm default; and
* reshapes the F/B/In1 GND pours with a real right-edge notch around the
  official WROOM antenna keepout (a fill-only exclusion is not accepted).

The only persistent output is the fixed staging PCB path below.  JSON audit
evidence is emitted to stdout.  The formal B3 PCB, B2 inputs, schematics and
attached hardware are never modified or accessed.  Routing and final placement
remain explicitly out of scope.
"""

from __future__ import annotations

import argparse
import collections
import datetime as dt
import hashlib
import json
import os
import re
import secrets
import shutil
import subprocess
import tempfile
import traceback
import xml.etree.ElementTree as ET
from dataclasses import dataclass
from pathlib import Path
from typing import Iterable

try:
    import pcbnew  # type: ignore
except Exception as exc:  # pragma: no cover - exercised by non-KiCad Python
    pcbnew = None  # type: ignore[assignment]
    PCBNEW_IMPORT_ERROR = f"{type(exc).__name__}: {exc}"
else:
    PCBNEW_IMPORT_ERROR = ""


ROOT = Path(__file__).resolve().parents[1]
HARDWARE = ROOT / "hardware"
B2_DIR = HARDWARE / "mf1750_devkitc_b2_pcba_margin"
B2_BOARD = B2_DIR / "mf1750_devkitc_b2_pcba_margin.kicad_pcb"
B3_DIR = HARDWARE / "mf1750_wroom_b3_power_tf"
STAGING = B3_DIR / "staging"
PROJECT_BASENAME = "mf1750_wroom_b3_power_tf"
# This path and digest are the reviewed R3 schematic authority.  The identically
# hashed ``*_r3_staging.kicad_sch`` is evidence only and is deliberately not a
# selectable input.  A caller cannot redirect synchronization to another
# schematic with a command-line option.
CANONICAL_SCHEMATIC = B3_DIR / f"{PROJECT_BASENAME}.kicad_sch"
CANONICAL_SCHEMATIC_SHA256 = (
    "158e54c1b8e0301860239bd69d837215caf2a9f5d5a34687a32fee922b310bf0"
)
CANONICAL_PROJECT = B3_DIR / f"{PROJECT_BASENAME}.kicad_pro"
FORMAL_B3_BOARD = B3_DIR / f"{PROJECT_BASENAME}.kicad_pcb"
OUTPUT_BOARD = STAGING / "mf1750_wroom_b3_power_tf_r3_placed.kicad_pcb"

B2_BOARD_SHA256 = "462e127279bacc894eab5e8cc242cd6d26e1d3ee87708ad398f8064b5a5c4238"
DEFAULT_WIDTH_MM = 80.0
DEFAULT_HEIGHT_MM = 125.0
B2_DRIVER_BOTTOM_MM = 60.5
EDGE_INSET_MM = 0.65
ANTENNA_NOTCH_MARGIN_MM = 0.30

BOARD_ONLY_MECHANICAL_REFS = frozenset({"H1", "H2"})
OBSOLETE_REFS = frozenset({"J3"})

# Exact source B2 track exemptions from the reviewed placement/migration audit.
# UUIDs are only valid because B2_BOARD_SHA256 is checked before they are used.
# No via is exempt: all 75 source vias must survive.
EXEMPT_TRACK_CONTRACT: dict[str, dict[str, object]] = {
    "4d1417b9-2610-4ea8-9606-e6195d1b5abf": {
        "net": "/BUSY_N",
        "anchor_mm": (17.8336, 54.2864),
        "layer": "F.Cu",
    },
    "c7ac9ba3-f6f4-46d4-935c-e214f9bccdbc": {
        "net": "/BUSY_N",
        "anchor_mm": (6.4932, 51.3732),
        "layer": "B.Cu",
    },
    "5efd92a2-34d2-494e-8c59-2932a0ddd77d": {
        "net": "/RST_N",
        "anchor_mm": (10.0862, 52.4262),
        "layer": "B.Cu",
    },
    "0340befd-a85d-4e52-b8ef-655f1d3f1177": {
        "net": "/DC",
        "anchor_mm": (12.2199, 52.0199),
        "layer": "B.Cu",
    },
    "928a5728-d641-42f7-b774-6d21012d5bbb": {
        "net": "/CSB",
        "anchor_mm": (25.74, 54.0),
        "layer": "B.Cu",
    },
    "afa163df-7a84-4853-b0c1-b422f06590a5": {
        "net": "/CSB",
        "anchor_mm": (14.3169, 51.5769),
        "layer": "B.Cu",
    },
    "32be88ed-7f34-4043-9dce-4fdbcc086e2a": {
        "net": "/CS2",
        "anchor_mm": (45.012, 57.588),
        "layer": "F.Cu",
    },
    "062cf581-1873-4721-a329-56c85f3ec102": {
        "net": "/SI0",
        "anchor_mm": (43.2101, 55.0701),
        "layer": "B.Cu",
    },
    "15478d8c-6cc5-453b-85eb-5549480f929b": {
        "net": "/SCL",
        "anchor_mm": (43.9517, 53.2717),
        "layer": "B.Cu",
    },
    "97f80bfc-b49e-4a41-a1d7-24d5ca5f256c": {
        "net": "/3V3",
        "anchor_mm": (12.0, 10.5),
        "layer": "In2.Cu",
    },
    "40f189e3-83b2-4816-9a92-7f26f31c232e": {
        "net": "/GND",
        "anchor_mm": (9.0983, 4.3),
        "layer": "F.Cu",
    },
}
TRACK_UUID_EXEMPT = frozenset(EXEMPT_TRACK_CONTRACT)
VIA_UUID_EXEMPT: frozenset[str] = frozenset()
INTERFACE_PANEL_NETS = frozenset(
    {"/RST_N", "/DC", "/CSB", "/CS2", "/SCL", "/SI0", "/BUSY_N"}
)
J2_REQUIRED_PAD_NETS = {
    "4": "/MCU_BUSY_N",
    "5": "/MCU_RST_N",
    "6": "/MCU_DC",
    "7": "/MCU_CSB",
    "16": "/MCU_CS2",
    "17": "/MCU_SI0",
    "18": "/MCU_SCL",
}
# Mechanical pads intentionally present in a frozen/package footprint but not
# represented as electrical symbol pins.  They must remain unconnected.
ALLOWED_UNCONNECTED_MECHANICAL_PADS = {"J1": frozenset({"MP1", "MP2"})}
POWER_NET_ALIAS = {"/3V3": "/EPD_SW_3V3", "/GND": "GND"}
NO_CONNECT_NET_CANONICALIZATION = {
    "unconnected-(J2-J3-3_GPIO44/RX-Pad42)": (
        "unconnected-(J2-J3-3_GPIO44{slash}RX-Pad42)"
    ),
    "unconnected-(J2-J3-2_GPIO43/TX-Pad43)": (
        "unconnected-(J2-J3-2_GPIO43{slash}TX-Pad43)"
    ),
    "unconnected-(U11-I/O2-Pad4)": "unconnected-(U11-I{slash}O2-Pad4)",
    "unconnected-(U11-I/O1-Pad6)": "unconnected-(U11-I{slash}O1-Pad6)",
}

PROJECT_FOOTPRINT_LIBRARIES = {
    "B3_WROOM": B3_DIR / "b3_wroom_footprints.pretty",
    "MF1750_Compact": B3_DIR / "MF1750_Compact.pretty",
    "MF1750_Production": B3_DIR / "MF1750_Production.pretty",
}

# These are deterministic review placements, not an electrically optimized
# placement.  Everything else is parked on documented grids for later audit.
FIXED_PLACEMENTS_MM = {
    "U1": (52.0, 90.0, 270.0),
    "J4": (48.0, 119.0, 180.0),
    "J5": (3.0, 111.0, 90.0),
    "J6": (18.0, 120.0, 180.0),
    "U2": (39.0, 65.0, 0.0),
    "U3": (45.0, 65.0, 0.0),
    "U4": (51.0, 65.0, 0.0),
    "U5": (39.0, 72.0, 0.0),
    "U6": (49.0, 74.0, 0.0),
    "U8": (38.0, 83.0, 0.0),
    "U9": (44.0, 83.0, 0.0),
    "U10": (50.0, 83.0, 0.0),
    "U11": (56.0, 83.0, 0.0),
    "L3": (35.0, 65.0, 0.0),
    "Q3": (35.0, 72.0, 0.0),
    "D5": (35.0, 78.0, 0.0),
    "F1": (35.0, 84.0, 0.0),
    "SW1": (2.0, 65.0, 90.0),
    "SW2": (2.0, 73.0, 90.0),
    "SW3": (2.0, 81.0, 90.0),
    "SW4": (2.0, 89.0, 90.0),
    "SW5": (2.0, 97.0, 90.0),
}


@dataclass(frozen=True)
class SchematicComponent:
    ref: str
    value: str
    footprint: str
    dnp: bool
    uuid: str
    pins: frozenset[str]


@dataclass(frozen=True)
class SchematicNetlist:
    source: str
    tool: str
    components: dict[str, SchematicComponent]
    pin_nets: dict[tuple[str, str], str]
    nets: frozenset[str]


class BuildError(RuntimeError):
    """Raised whenever synchronization evidence is incomplete or inconsistent."""


def sha256_file(path: Path) -> str:
    digest = hashlib.sha256()
    with path.open("rb") as stream:
        for chunk in iter(lambda: stream.read(1024 * 1024), b""):
            digest.update(chunk)
    return digest.hexdigest()


def require_exact_sha256(path: Path, expected: str, label: str) -> str:
    if not path.is_file():
        raise BuildError(f"{label} is missing: {path}")
    actual = sha256_file(path)
    if actual.casefold() != expected.casefold():
        raise BuildError(
            f"{label} hash mismatch: expected {expected.casefold()}, got {actual}"
        )
    return actual


def find_project_locks() -> list[Path]:
    """Return KiCad locks in every source/output directory we protect."""
    locks: set[Path] = set()
    for directory in (B2_DIR, B3_DIR, STAGING):
        if directory.is_dir():
            locks.update(path.resolve() for path in directory.glob("~*.lck"))
    return sorted(locks, key=lambda path: str(path).casefold())


def _copy_required_file(source: Path, destination: Path, label: str) -> None:
    if not source.is_file():
        raise BuildError(f"self-contained project {label} is missing: {source}")
    shutil.copy2(source, destination)
    if not destination.is_file() or sha256_file(destination) != sha256_file(source):
        raise BuildError(f"self-contained project {label} copy failed: {destination}")


def prepare_self_contained_project(
    directory: Path,
    *,
    board_source: Path | None = None,
) -> dict[str, object]:
    """Create a disposable, basename-matched KiCad project in OS temp.

    KiCad schematic-parity resolution is basename/project-context sensitive.
    The copied project, schematic and eventual board therefore share exactly
    ``PROJECT_BASENAME``; project-local symbol/footprint tables and libraries
    are copied with them instead of relying on the authoritative source tree as
    an implicit working directory.
    """
    directory.mkdir(parents=True, exist_ok=False)
    project_path = directory / f"{PROJECT_BASENAME}.kicad_pro"
    schematic_path = directory / f"{PROJECT_BASENAME}.kicad_sch"
    board_path = directory / f"{PROJECT_BASENAME}.kicad_pcb"
    _copy_required_file(CANONICAL_PROJECT, project_path, "project")
    _copy_required_file(CANONICAL_SCHEMATIC, schematic_path, "schematic")
    _copy_required_file(B3_DIR / "fp-lib-table", directory / "fp-lib-table", "fp-lib-table")
    _copy_required_file(
        B3_DIR / "sym-lib-table", directory / "sym-lib-table", "sym-lib-table"
    )
    for symbol_name in ("b3_wroom_symbols.kicad_sym", "mf1750_local.kicad_sym"):
        _copy_required_file(
            B3_DIR / symbol_name, directory / symbol_name, f"symbol library {symbol_name}"
        )
    for library_name in (
        "b3_wroom_footprints.pretty",
        "MF1750_Compact.pretty",
        "MF1750_Production.pretty",
    ):
        source = B3_DIR / library_name
        destination = directory / library_name
        if not source.is_dir():
            raise BuildError(f"self-contained footprint library is missing: {source}")
        shutil.copytree(source, destination)
    if board_source is not None:
        _copy_required_file(board_source, board_path, "PCB")

    if len({project_path.stem, schematic_path.stem, board_path.stem}) != 1:
        raise BuildError("self-contained KiCad project basenames do not match")
    if sha256_file(schematic_path) != CANONICAL_SCHEMATIC_SHA256:
        raise BuildError("self-contained schematic is not the frozen R3 authority")
    required = (
        project_path,
        schematic_path,
        directory / "fp-lib-table",
        directory / "sym-lib-table",
    )
    return {
        "directory": str(directory),
        "project": str(project_path),
        "schematic": str(schematic_path),
        "board": str(board_path),
        "same_basename": True,
        "required_file_sha256": {
            path.name: sha256_file(path) for path in required
        },
        "project_footprint_libraries": [
            "b3_wroom_footprints.pretty",
            "MF1750_Compact.pretty",
            "MF1750_Production.pretty",
        ],
        "project_symbol_libraries": [
            "b3_wroom_symbols.kicad_sym",
            "mf1750_local.kicad_sym",
        ],
    }


def natural_key(value: str) -> tuple[object, ...]:
    return tuple(
        int(part) if part.isdigit() else part.casefold()
        for part in re.split(r"(\d+)", value)
    )


def find_kicad_cli(requested: Path | None) -> Path | None:
    if requested is not None:
        return requested.resolve() if requested.is_file() else None
    located = shutil.which("kicad-cli")
    if located:
        return Path(located).resolve()
    candidates = (
        Path(r"C:\Program Files\KiCad\10.0\bin\kicad-cli.exe"),
        Path("/usr/bin/kicad-cli"),
    )
    return next((candidate for candidate in candidates if candidate.is_file()), None)


def kicad_cli_version(kicad_cli: Path) -> dict[str, object]:
    completed = subprocess.run(
        [str(kicad_cli), "--version"],
        check=False,
        text=True,
        encoding="utf-8",
        errors="replace",
        capture_output=True,
        env={**os.environ, "NO_PROXY": "*", "no_proxy": "*"},
    )
    version = completed.stdout.strip() or completed.stderr.strip()
    if completed.returncode != 0:
        raise BuildError(f"kicad-cli --version failed: {version or 'no diagnostic'}")
    if version.split(".", 1)[0] != "10":
        raise BuildError(f"KiCad 10 is required; found {version!r}")
    return {"path": str(kicad_cli), "version": version}


def export_kicad_xml(
    kicad_cli: Path,
    schematic: Path,
    output: Path,
) -> dict[str, object]:
    command = [
        str(kicad_cli),
        "sch",
        "export",
        "netlist",
        "--format",
        "kicadxml",
        "--output",
        str(output),
        str(schematic),
    ]
    completed = subprocess.run(
        command,
        cwd=output.parent,
        check=False,
        text=True,
        encoding="utf-8",
        errors="replace",
        capture_output=True,
        env={**os.environ, "NO_PROXY": "*", "no_proxy": "*"},
    )
    if completed.returncode != 0:
        raise BuildError(
            "KiCad XML netlist export failed: "
            + (completed.stderr.strip() or completed.stdout.strip() or "no diagnostic")
        )
    if not output.is_file() or output.stat().st_size == 0:
        raise BuildError("KiCad XML export returned success without an output file")
    return {
        "command": command,
        "returncode": completed.returncode,
        "stdout": completed.stdout.strip(),
        "stderr": completed.stderr.strip(),
        "bytes": output.stat().st_size,
        "sha256": sha256_file(output),
    }
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
