oceanye/ESP32_C73-MF1750/hardware/build_mf1750_wroom_b3_r16_control_service_unified.py

#!/usr/bin/env python3
"""Strictly unify proven R12 control/service route branches in staging.

Operating mode: REVISION, staging-only.  The SHA-bound R12 PCB is the sole
geometry source.  This builder imports the exact additive copper deltas from
the independently verified button-remediation, MCU_EN, UART0, and JTAG
branches.  It never creates or edits route geometry and never relaxes a gate.

The candidate is intentionally retained as HOLD evidence if independently
valid branches conflict after unification.  Formal PCB/project/schematic,
source branches, routing registry, README, and STATUS files are protected
read-only inputs.
"""

from __future__ import annotations

import collections
import datetime as dt
import hashlib
import json
import os
from pathlib import Path
import re
import subprocess
import sys
import tempfile
import traceback
from typing import Any, Iterable

import route_mf1750_wroom_b3_boot_n_r8e as boot


pcbnew = boot.pcbnew
base = boot.base

ROOT = Path(__file__).resolve().parents[1]
HARDWARE = ROOT / "hardware"
B3_DIR = HARDWARE / "mf1750_wroom_b3_power_tf"
STAGING = B3_DIR / "staging"

SOURCE_BOARD = STAGING / "mf1750_wroom_b3_power_tf_r12_r11_user_key_2_n_routed.kicad_pcb"
SOURCE_SHA256 = "3a92f2aa31292032f38fcbae7152e67d20ef1cf50e0e619f6243faf3abe32ea3"
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
