oceanye/ESP32_C73-MF1750/(commit log)

2026-08-03 feat: establish MF-1750 Rev A1 driver RC1 baseline
2026-08-03 feat: add host frame contract and fixtures
2026-08-04 docs: publish accepted driver API contract
2026-08-05 research: add extended-color offline groundwork
2026-08-05 docs: record extended-color stage gates
2026-08-30 docs: add camera coarse-screen discovery gate
2026-08-30 docs: prepare daylight camera-assisted T3 run
2026-08-30 docs: record daylight camera preflight stop
2026-09-01 feat: define 256-slot lightness target
2026-10-10 feat: L535 full-color route, runtime waveform tooling, MAP-v2 intermediate scan
    - L535 calibrated palette + gamut + frame-path firmware variants (v1/v2),
    production zero-diff proven
    - full-color demo pipeline: FS dither quantization + 180-deg pre-rotation
    compensation, upright demo on screen
    - runtime_waveform: format registry (SPD1657_R20_L535_GEOMETRY_V1) +
    l535_table_builder (535B reference-exact, header knobs mV-encoded)
    - MAP-v2 8x8 directed (history,target) live scan + geometry calibration:
    no new independent intermediate colors (violet candidate = code-1 alias);
    transition truncation and code-axis drift recorded as mechanism evidence
    - 14 falsified-route ledger maintained; i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
2026-10-11 docs: publish direct waveform handoff and test options
    Publish the prepared 2026-10-11 handoff, research options, and current status. Corresponding ladder PLL/power code updates follow on this branch. Hardware tested: NO.
2026-10-11 feat: dither atlas frame builder and palette v2 builder (fail-closed); record gamut collapse finding
2026-10-12 feat: WF A1/B1 variant bundles (PLL 50Hz / VSH_LV2 6.9V) + white-clear margin evidence
    - wf_ab bundle builder with offline+compile-time assertions
    (R20[1:5]==PWR[2:6] mirror, R20[6]==PLL[0]); bins sealed, held
    NOT_QUALIFIED_AWAITING_PASSIVE_CAPTURE
    - controlled single-variable result: L535 active-table white clear
    deterministically fails (navy field, drf 1.51x bimodal) while OTP path
    heals (21671-21691, white); panel healthy - table/panel-state mismatch
    - VSH6600 white-clear re-test: PARTIAL (navy->gray-beige, L31->63) -
    voltage margin model supported; panel drift has crossed 6600mV
    - driver API doc: register 7 research variant build tags (contract fix)
2026-10-18 feat: WF full commented-table probe variant + live new stable mauve field
2026-10-20 test: pin spatial decode audit; document P0 anomaly findings
2026-10-20 feat: build partial block V2 bundles (code7 probe swap, patch code4)
2026-10-20 docs: record P0 V2 probe result (position-determined rendering)
2026-10-20 feat: build V3 normalization+probe session env
2026-10-20 docs: record P0 V3 (normalization clears position colors; camera moved mid-batch)
2026-10-20 feat: build V4 compact-layout atlas session env (8 cells in visible window, probes dropped)
2026-10-20 docs: record P0 V4 batch FAIL_STOP (bench power anomaly, parasitic supply suspected)
2026-10-20 docs: record bench power check (supply still OFF, batches frozen until physical restore)
2026-10-20 docs: record relay rebind + POWER_RESTORED (bench back online, new seal ce9201f6)
2026-10-20 fix: block geometry solver real-photo detection (cluster area filter, halo-break morphology, Canny rim anchor)
2026-10-21 feat: build BTST2[3] sweep session env (4 drive strengths, V4 frame reused)
2026-10-21 feat: build waveform-variant atlas env (0E/1C/1D/0E_R0R1 full-frame x V4 8-code frame)
